wasauce/AirCloudPCBs/AirCloudv1/Deliverables/images/04.jpg

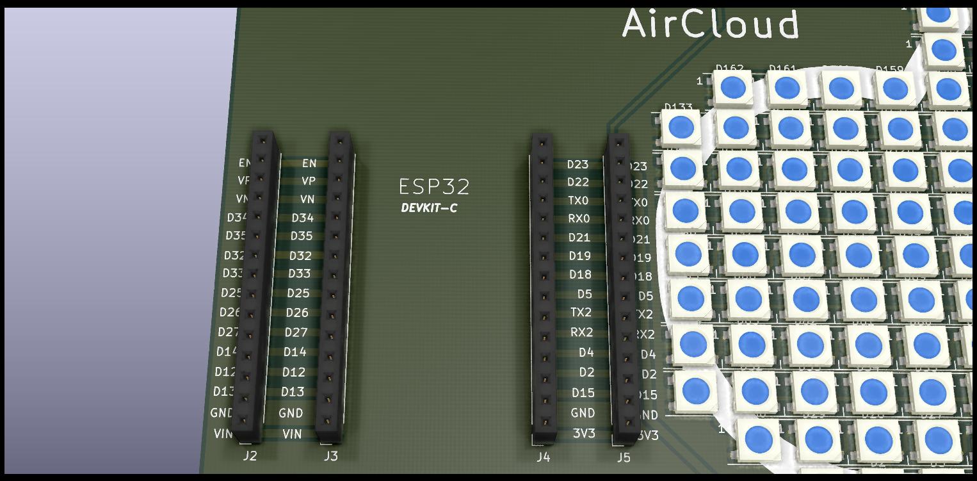
AirCloudv1/Deliverables/images/04.jpg
