wasauce/AirCloudPCBs/AirCloudv1/Deliverables/images/01.jpg

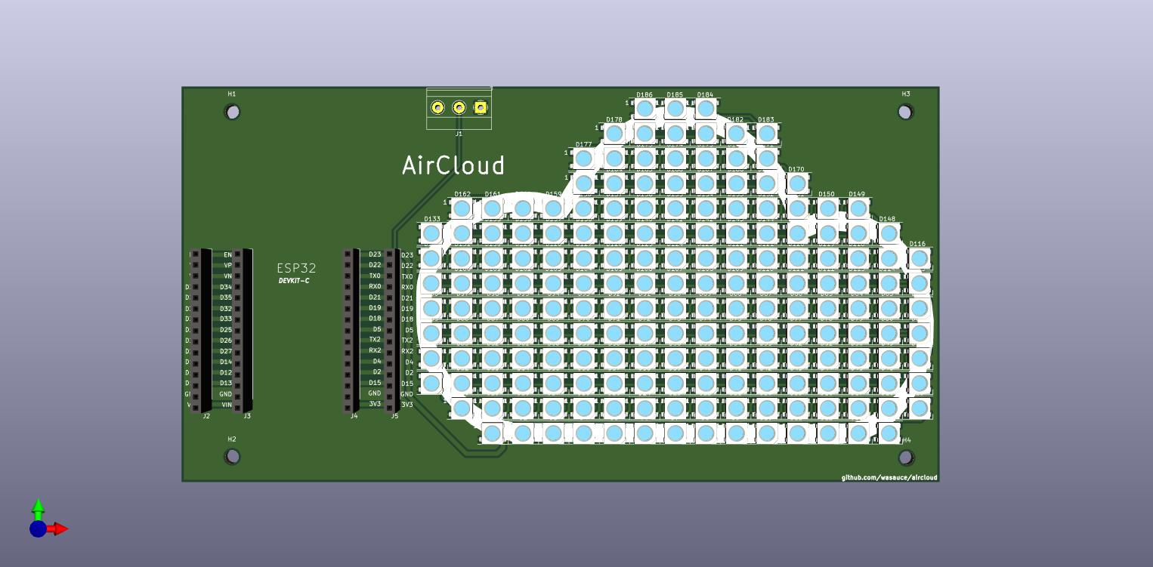
AirCloudv1/Deliverables/images/01.jpg
