wasauce/AirCloudPCBs/AirCloudv1/CONNECTION.png

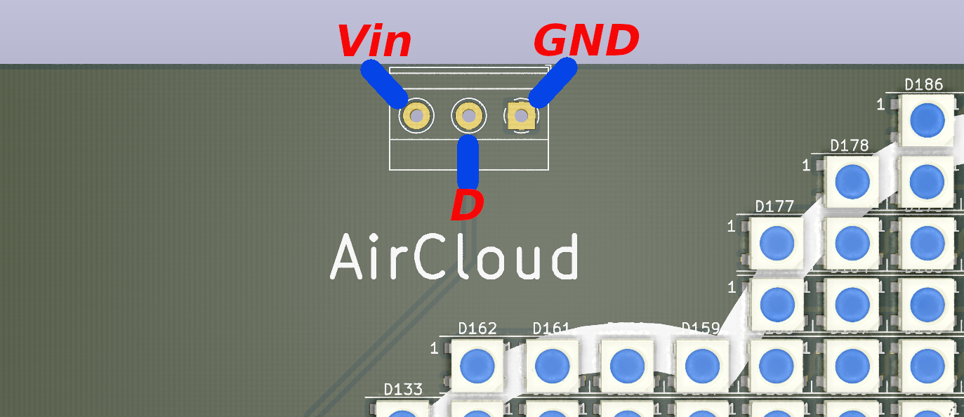
AirCloudv1/CONNECTION.png
