wasauce/AirCloudPCBs/AirCloudv1/Deliverables-matrix/images/01.jpg

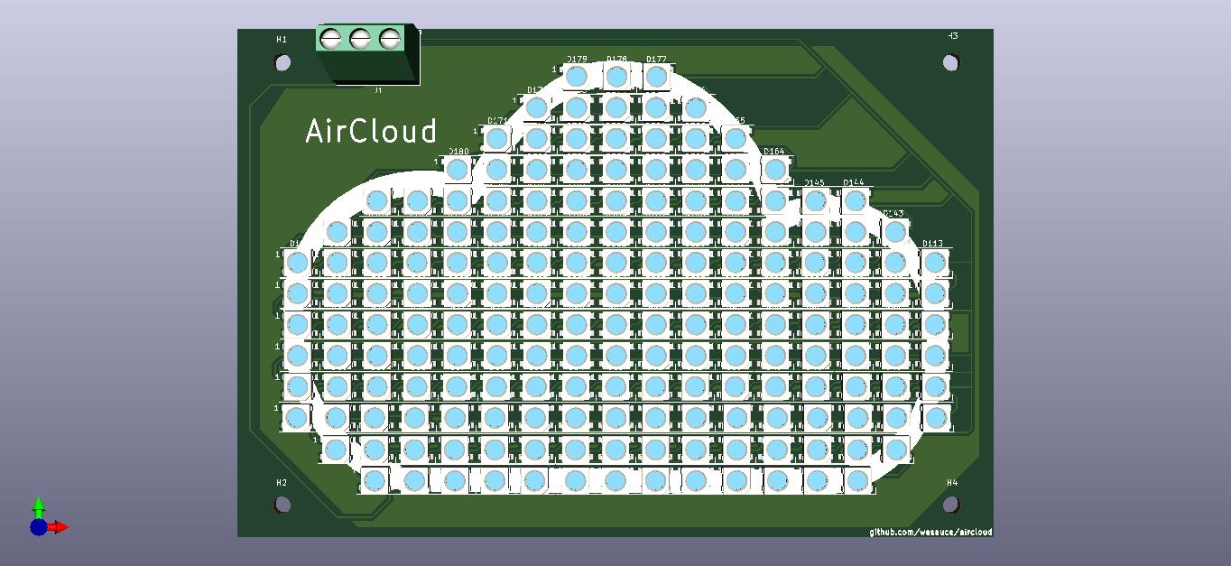
AirCloudv1/Deliverables-matrix/images/01.jpg
