wasauce/AirCloudPCBs/AirCloudv1/Deliverables-matrix/images/02.jpg

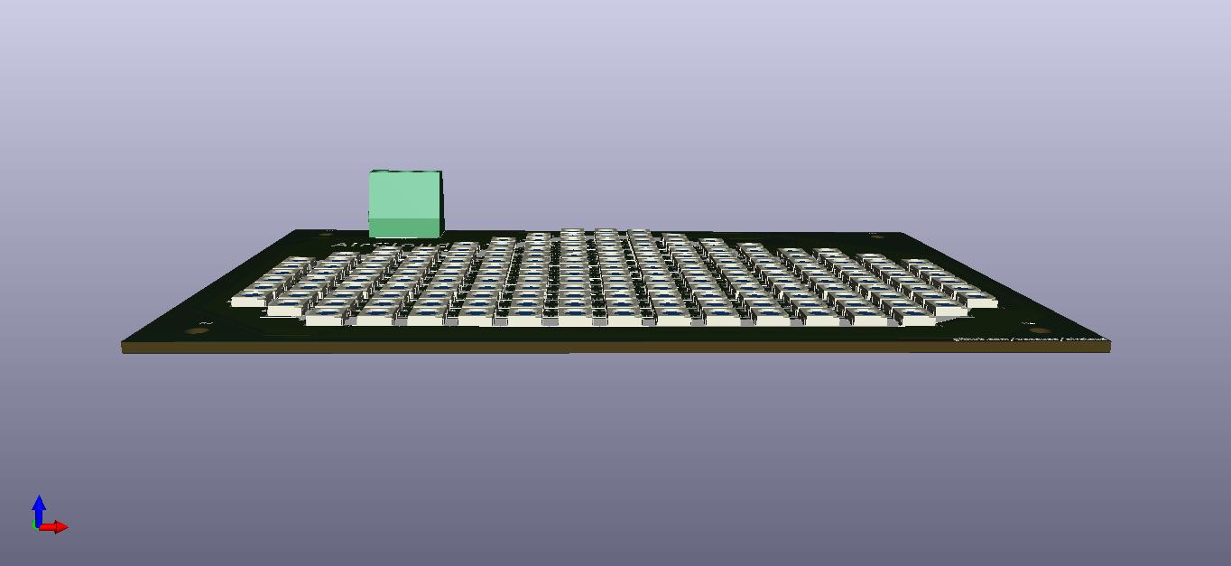
AirCloudv1/Deliverables-matrix/images/02.jpg
