wasauce/AirCloudPCBs/AirCloudv1/Deliverables-matrix/images/03.jpg

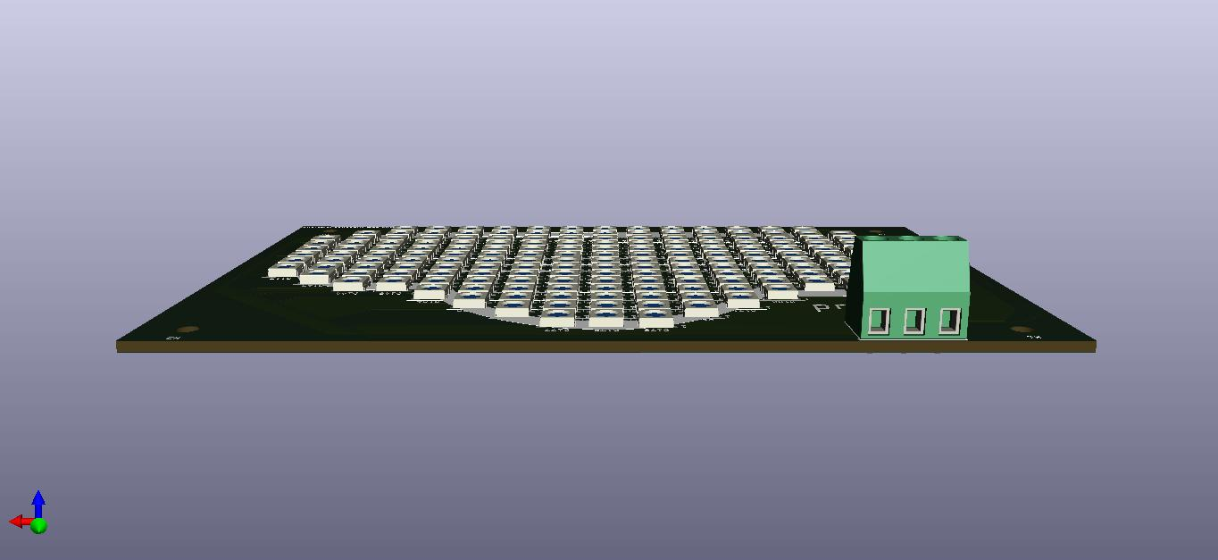
AirCloudv1/Deliverables-matrix/images/03.jpg
