wasauce/AirCloudPCBs/AirCloudv1/Deliverables/images/02.jpg

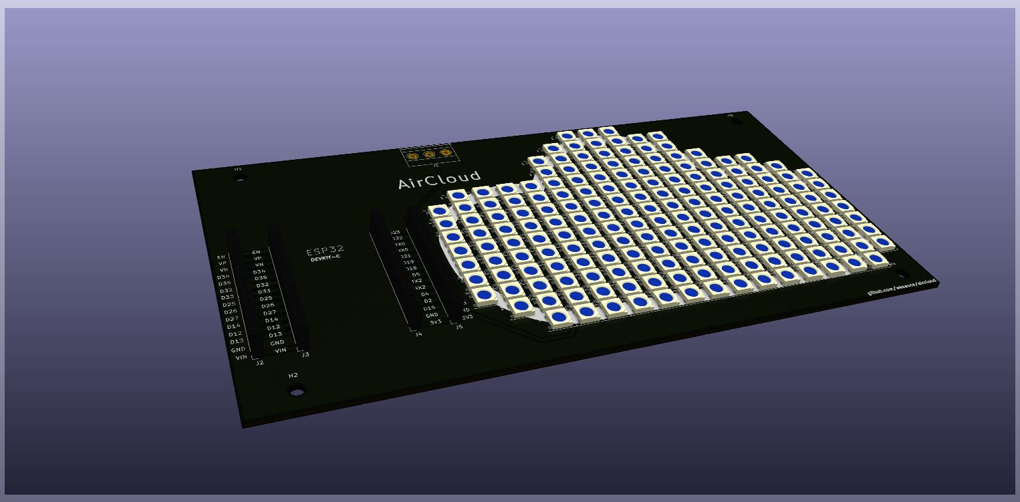
AirCloudv1/Deliverables/images/02.jpg
