wasauce/AirCloudPCBs/AirCloudv1/Deliverables/images/03.jpg

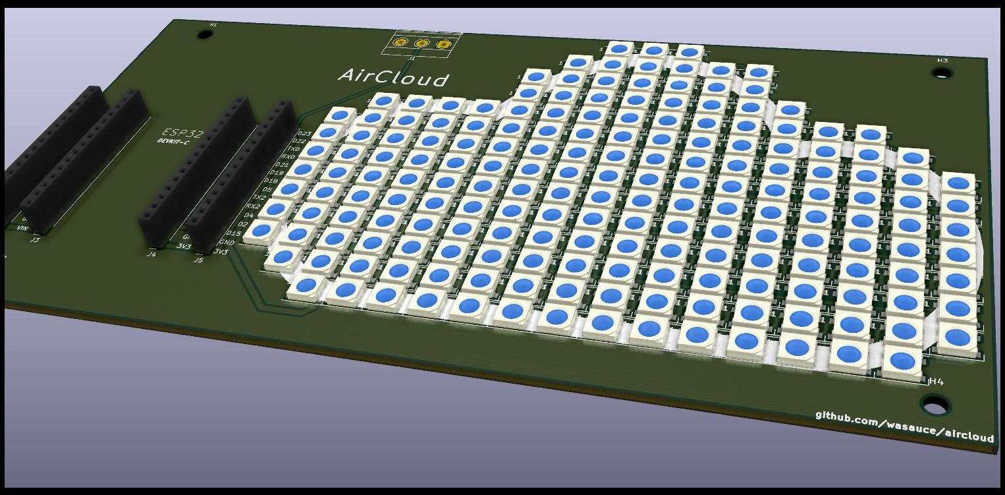
AirCloudv1/Deliverables/images/03.jpg
