wasauce/AirCloudPCBs/AirCloudv2/AirCloud_Back.PNG

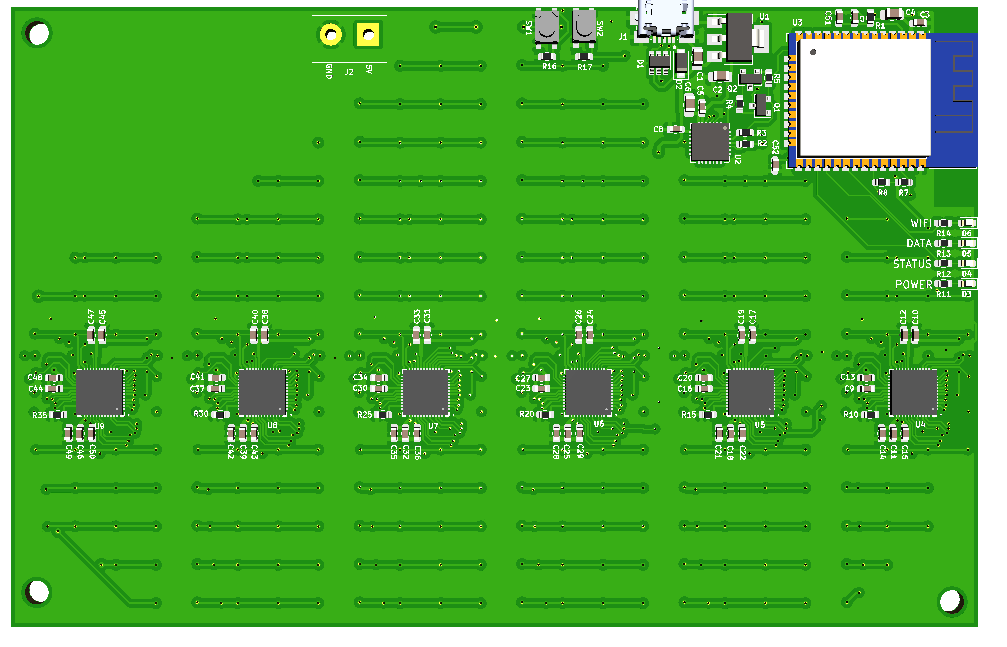
AirCloudv2/AirCloud_Back.PNG
