wasauce/AirCloudPCBs/AirCloudv2/AirCloud_Back_jack.PNG

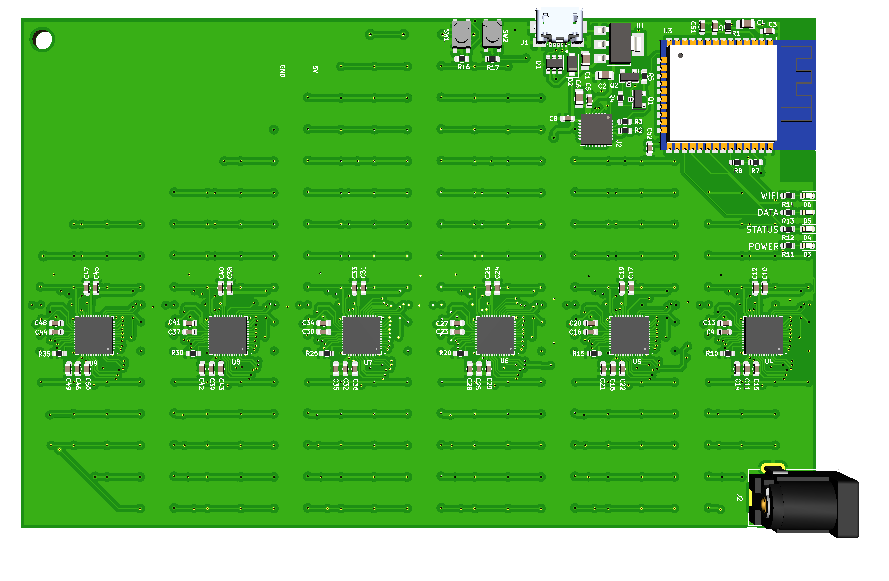
AirCloudv2/AirCloud_Back_jack.PNG
