wasauce/AirCloudPCBs/AirCloudv2/AirCloud_Back_Spacinf.PNG

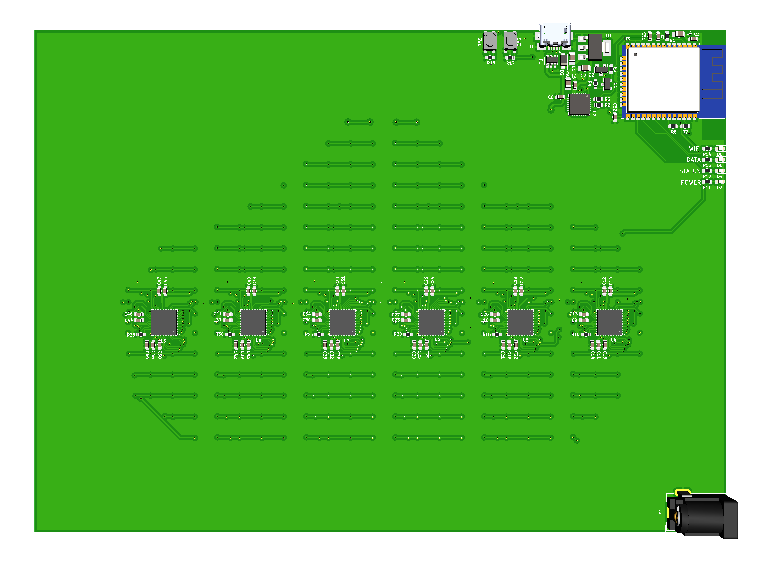
AirCloudv2/AirCloud_Back_Spacinf.PNG
