wasauce/AirCloudPCBs/AirCloudv2/AirCloud_Front.PNG

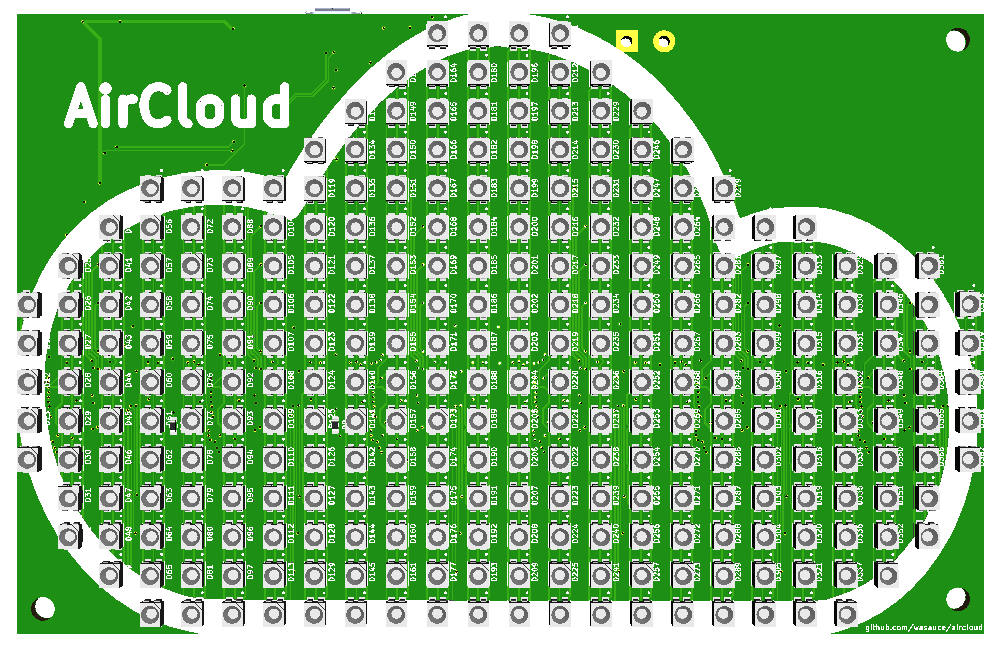
AirCloudv2/AirCloud_Front.PNG
