wasauce/AirCloudPCBs/AirCloudv2/AirCloud_Front_Jack.PNG

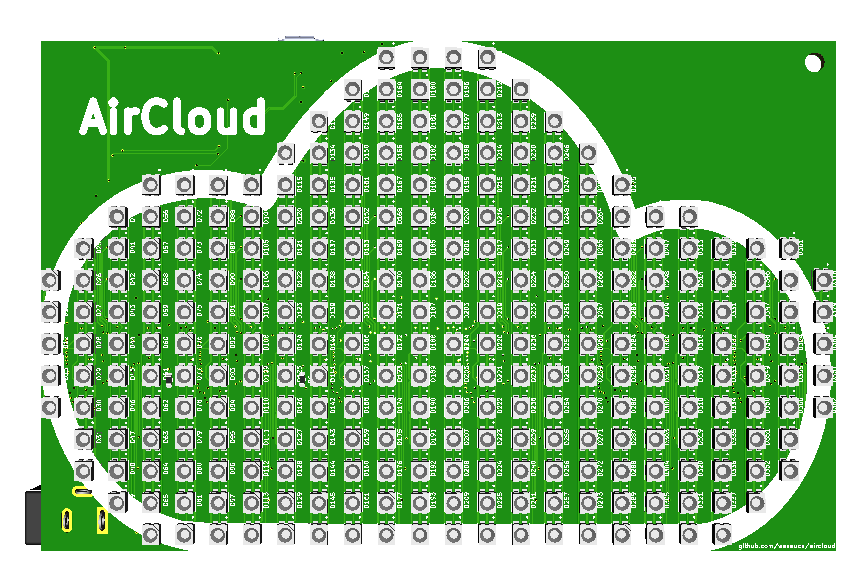
AirCloudv2/AirCloud_Front_Jack.PNG
