wasauce/AirCloudPCBs/AirCloudv2/AirCloud_Front_Spacing.PNG

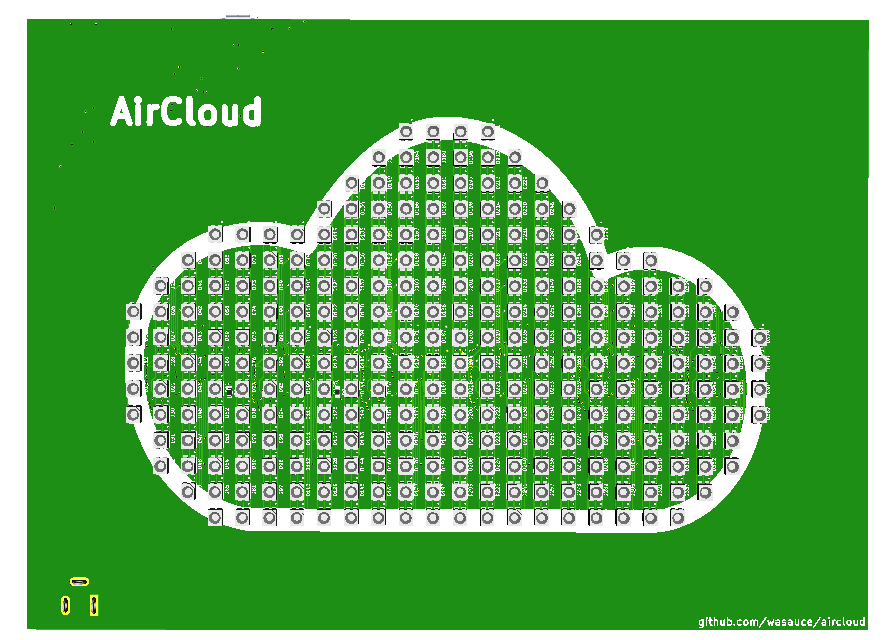
AirCloudv2/AirCloud_Front_Spacing.PNG
