wasauce/AirCloudPCBs/AirCloudv2/Matrix.PNG

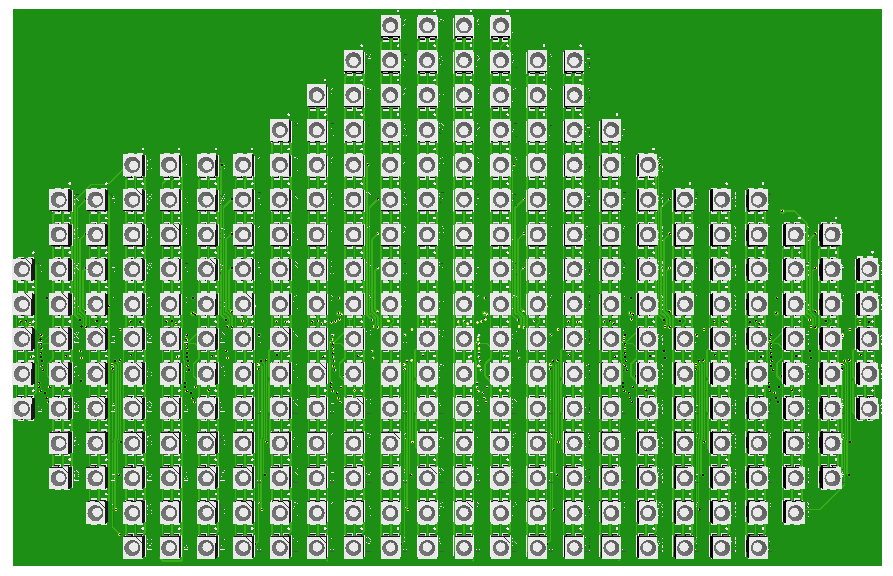
AirCloudv2/Matrix.PNG
