wasauce/AirCloudPCBs/AirCloudv2/Matrix_1.PNG

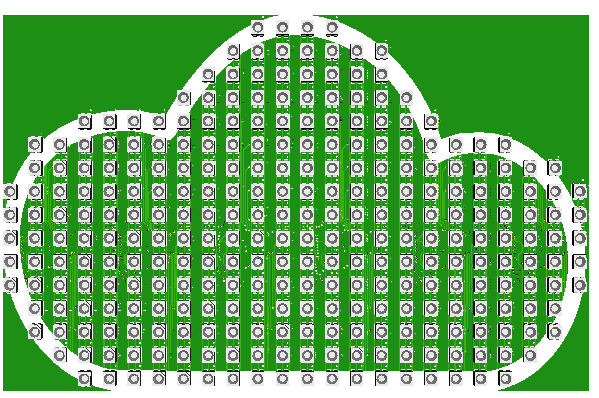
AirCloudv2/Matrix_1.PNG
