wasauce/AirCloudPCBs/AirCloudv3/Images/1.jpg

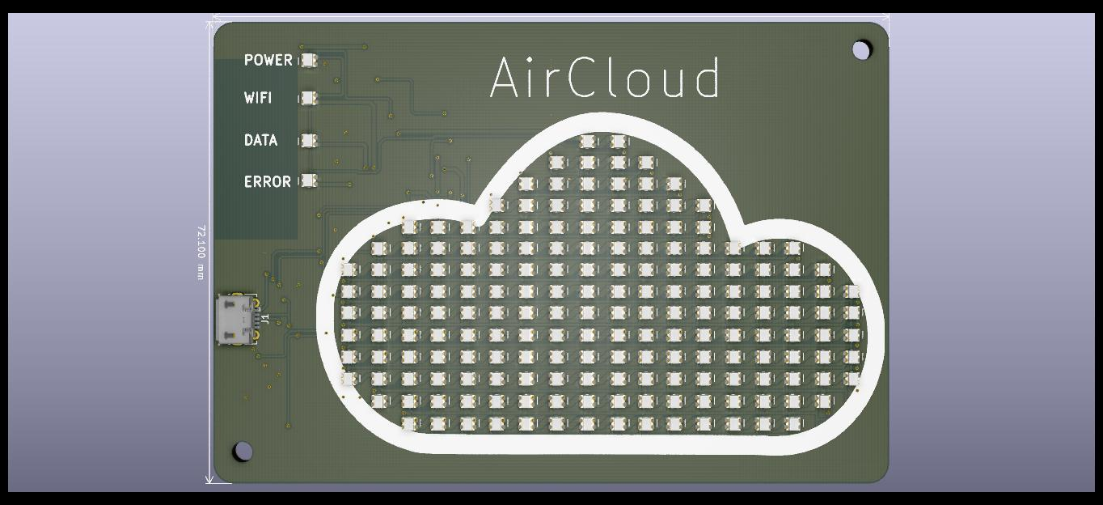
AirCloudv3/Images/1.jpg
