wasauce/AirCloudPCBs/AirCloudv3/Images/2.jpg

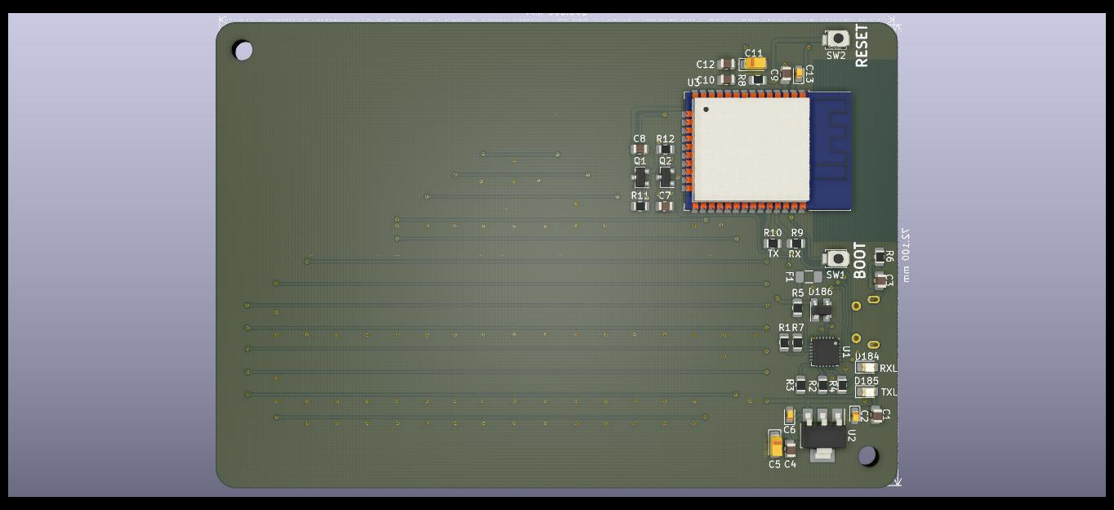
AirCloudv3/Images/2.jpg
