wasauce/AirCloudPCBs/AirCloudv3/Images/3.jpg

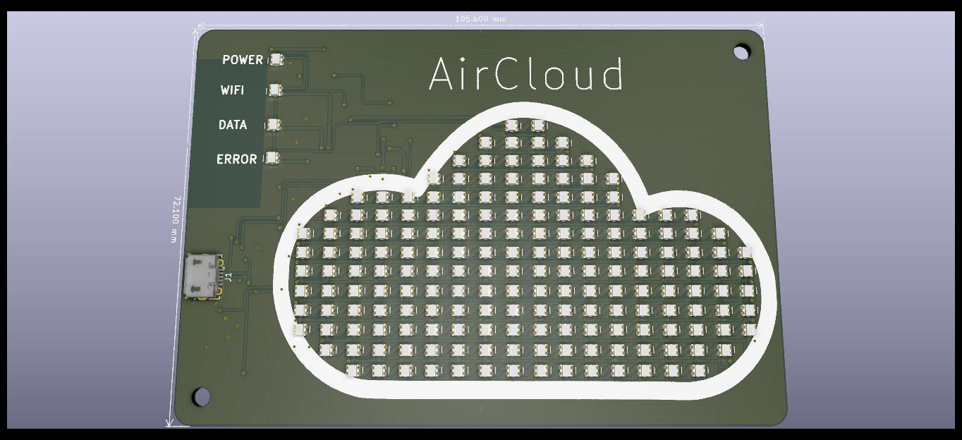
AirCloudv3/Images/3.jpg
