wasauce/AirCloudPCBs/AirCloudv3/Images/4.jpg

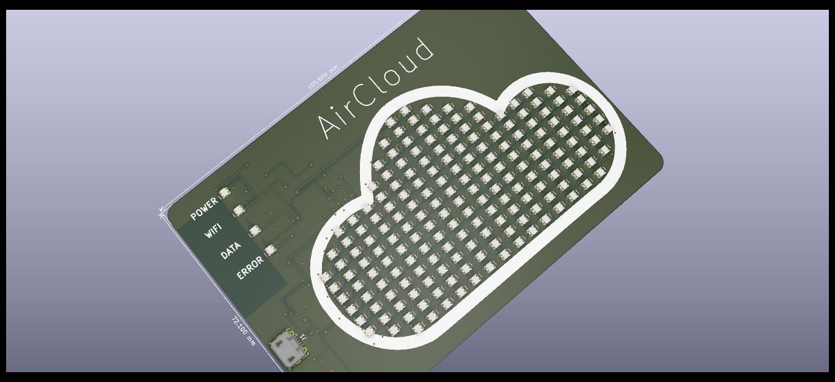
AirCloudv3/Images/4.jpg
