wasauce/AirCloudPCBs/AirCloudv3/Images/5.jpg

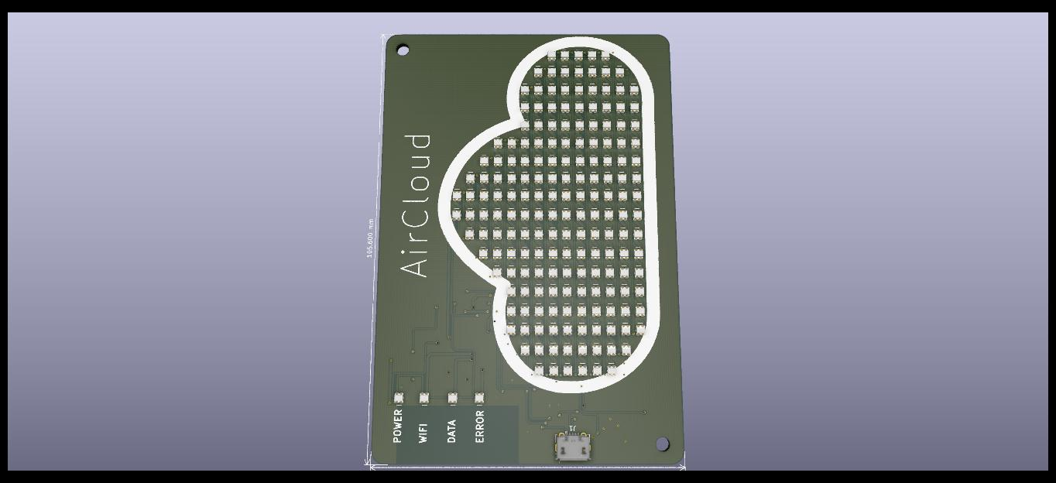
AirCloudv3/Images/5.jpg
