wasauce/AirCloudPCBs/AirCloudv3/BOM/BOM.xlsx

Reference | Value | Footprint | Datasheet | Cost | Mfg PN | Vendor Link | Vendor PN | Qty | Rev
C1, C4, C7-C10, C12 | 0.1uF | C_0805_2012Metric | https://www.mouser.com/datasheet/2/40/X7RDielectric-777024.pdf | 0.1000 | 08055C104KAT2A | https://www.mouser.com/ProductDetail/AVX/08055C104KAT2A | 581-08055C104K | 7 | OK | 0.7000
C2, C6 | 10uF/6V3 | CP_EIA-1608-08_AVX-J | https://www.mouser.com/datasheet/2/427/tmcj-1764085.pdf | 0.2700 | TMCJ0J106MTRF | https://www.mouser.com/ProductDetail/Vishay-Sprague/TMCJ0J106MTRF | 74-TMCJ0J106MTRF | 2 | OK | 0.5400
C3 | 4.7nF | C_0805_2012Metric | https://www.mouser.com/datasheet/2/445/885012207090-1727858.pdf | 0.1000 | 885000000000 | https://www.mouser.com/ProductDetail/Wurth-Elektronik/885012207090 | 710-885012207090 | 1 | OK | 0.1000
C5, C11 | 22uF | CP_EIA-3216-18_Kemet-A | https://www.mouser.com/datasheet/2/212/1/KEM_T2005_T491-1093550.pdf | 0.5300 | T491A226K006AT7280 | https://www.mouser.com/ProductDetail/KEMET/T491A226K006AT7280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 | 80-T491A226K006AT | 2 | OK | 1.0600
C13 | 4.7uF | CP_EIA-1608-08_AVX-J | https://www.mouser.com/datasheet/2/427/tmcj-1764085.pdf | 0.2700 | TMCJ0J475MTRF | https://www.mouser.com/ProductDetail/Vishay-Sprague/TMCJ0J475MTRF?qs=WatphXlIDnxcU2F%2FkoHLoA%3D%3D | 74-TMCJ0J475MTRF | 1 | OK | 0.2700
D184, D185 | Blue | LED_0805_2012Metric_Castellated | https://www.mouser.com/datasheet/2/445/150080BS75000-1715853.pdf | 0.1800 | 150080BS75000 | https://www.mouser.com/ProductDetail/Wurth-Elektronik/150080BS75000?qs=2kOmHSv6VfT2tBo3UPVqAQ%3D%3D | 710-150080BS75000 | 2 | OK | 0.3600
D186 | PRTR5V0U2X | SOT-143 | https://www.mouser.com/datasheet/2/916/PRTR5V0U2X-1320589.pdf | 0.5000 | PRTR5V0U2X,215 | https://www.mouser.com/ProductDetail/Nexperia/PRTR5V0U2X215 | 771-PRTR5V0U2X-T/R | 1 | OK | 0.5000
D1-D183, D187-D190 | WS2812B_2020 | WS2812B2020 | https://datasheet.lcsc.com/lcsc/2012110135_Worldsemi-WS2812B-2020_C965555.pdf | 0.0924 | WS2812B-2020 | https://lcsc.com/product-detail/Light-Emitting-Diodes-LED_Worldsemi-WS2812B-2020_C965555.html | C965555 | 187 | OK | 17.2788
F1 | 6V/500mA | Fuse_1206_3216Metric | https://www.mouser.com/datasheet/2/87/eaton-pts1206-6-60-volt-dc-surface-mount-resettabl-1608737.pdf | 0.1300 | PTS12066V050 | https://www.mouser.com/ProductDetail/Bussmann-Eaton/PTS12066V050?qs=QmibqUXyDhT3w6keDqXDtw%3D%3D | PTS12066V050 | 1 | OK | 0.1300
J1 | USB_B_Micro | USB_Micro-B_Molex-105017-0001 | https://datasheet.lcsc.com/lcsc/1811131824_MOLEX-1050170001_C136000.pdf | 0.2880 | 105017-0001 | https://lcsc.com/product-detail/Micro-USB-Connectors_MOLEX_105017-0001_105017-0001_C136000.html | C136000 | 1 | OK | 0.2880
Q1, Q2 | MMBT3904 | SOT-23 | https://www.mouser.com/datasheet/2/916/MMBT3904-1599187.pdf | 0.1000 | MMBT3904,215 | https://www.mouser.com/ProductDetail/Nexperia/MMBT3904215?qs=LOCUfHb8d9s%2FW6hzAJGDbw%3D%3D | 771-MMBT3904T/R | 2 | OK | 0.2000
R1 | 2K | R_0805_2012Metric | https://www.mouser.com/datasheet/2/447/PYu_RT_1_to_0_01_RoHS_L_11-1669912.pdf | 0.1200 | RT0805FRE102KL | https://www.mouser.com/ProductDetail/Yageo/RT0805FRE102KL?qs=F5EMLAvA7ICZZb51T28hLA%3D%3D | 603-RT0805FRE102KL | 1 | OK | 0.1200
R2, R3 | 1K | R_0805_2012Metric | https://www.mouser.com/datasheet/2/447/PYu_RT_1_to_0_01_RoHS_L_11-1669912.pdf | 0.1200 | RT0805FRE071KL | https://www.mouser.com/ProductDetail/Yageo/RT0805FRE071KL?qs=8cPjvKtxWv4wlgQ3qHu8dQ%3D%3D | 603-RT0805FRE071KL | 2 | OK | 0.2400
R4 | 22K | R_0805_2012Metric | https://www.mouser.com/datasheet/2/427/crcwce3-1762584.pdf | 0.1000 | CRCW080522K0FKEAC | https://www.mouser.com/ProductDetail/Vishay-Dale/CRCW080522K0FKEAC?qs=E3Y5ESvWgWM%252BLh7gNR1oHw%3D%3D | 71-CRCW080522K0FKEAC | 1 | OK | 0.1000
R5 | 22.1K | R_0805_2012Metric | https://www.mouser.com/datasheet/2/392/susumu_RR_Data_Sheet-1206438.pdf | 0.1000 | RR1220P-2212-D-M | https://www.mouser.com/ProductDetail/Susumu/RR1220P-2212-D-M | 754-RR1220P-2212D-M | 1 | OK | 0.1000
R6 | 1M | R_0805_2012Metric | https://www.mouser.com/datasheet/2/447/PYu_AC_51_RoHS_L_7-1714230.pdf | 0.1000 | AC0805FR-7W1ML | https://www.mouser.com/ProductDetail/Yageo/AC0805FR-7W1ML?qs=tggtontpCXNsGpOF44NrCA%3D%3D | 603-AC0805FR-7W1ML | 1 | OK | 0.1000
R7 | 47.5K | R_0805_2012Metric | https://www.mouser.com/datasheet/2/447/PYu_AC_51_RoHS_L_7-1714230.pdf | 0.1000 | AC0805FR-7W47K5L | https://www.mouser.com/ProductDetail/Yageo/AC0805FR-7W47K5L | 603-AC0805FR-7W47K5L | 1 | OK | 0.1000
R8 | 620 | R_0805_2012Metric | https://www.mouser.com/datasheet/2/54/crxxxxx-1858361.pdf | 0.1000 | CR0805-JW-621ELF | https://www.mouser.com/ProductDetail/Bourns/CR0805-JW-621ELF?qs=%252BcBkmVQIZ2S44sYUQ9%2FccQ%3D%3D | 652-CR0805JW-621ELF | 1 | OK | 0.1000
R9, R10 | 150 | R_0805_2012Metric | https://www.mouser.com/datasheet/2/54/crxxxxx-1858361.pdf | 0.1000 | CR0805-FX-1500ELF | https://www.mouser.com/ProductDetail/Bourns/CR0805-FX-1500ELF | 652-CR0805FX-1500ELF | 2 | OK | 0.2000
R11, R12 | 10K | R_0805_2012Metric | https://www.mouser.com/datasheet/2/392/susumu_RR_Data_Sheet-1206438.pdf | 0.1000 | RR1220P-103-D | https://www.mouser.com/ProductDetail/Susumu/RR1220P-103-D?qs=nCAm%252BcMdy9wM6YRNq%2FvwoQ%3D%3D | 754-RR1220P-103D | 2 | OK | 0.2000
SW1 | BOOT | SW_SPST_B3U-1000P | https://datasheet.lcsc.com/lcsc/1810010153_Omron-Electronics-B3U-1000P_C231329.pdf | 0.2585 | B3U-1000P | https://lcsc.com/product-detail/Tactile-Switches_Omron-Electronics-B3U-1000P_C231329.html | C231329 | 1 | OK | 0.2585
SW2 | RESET | SW_SPST_B3U-1000P | https://datasheet.lcsc.com/lcsc/1810010153_Omron-Electronics-B3U-1000P_C231329.pdf | 0.2585 | B3U-1000P | https://lcsc.com/product-detail/Tactile-Switches_Omron-Electronics-B3U-1000P_C231329.html | C231329 | 1 | OK | 0.2585
U1 | CP2102N-A02-GQFN24 | QFN-24-1EP_4x4mm_P0.5mm_EP2.6x2.6mm | https://www.mouser.com/datasheet/2/368/cp2102n_datasheet-1634912.pdf | 1.8700 | CP2102N-A02-GQFN24R | https://www.mouser.com/ProductDetail/Silicon-Labs/CP2102N-A02-GQFN24R?qs=u16ybLDytRaIVBf0X4zL0g%3D%3D | 634-CP2102NA02QFN24R | 1 | OK | 1.8700
U2 | AZ1117-3.3 | SOT-223-3_TabPin2 | https://datasheet.lcsc.com/lcsc/1811061323_Diodes-Incorporated-AZ1117IH-3-3TRG1_C108495.pdf | 0.2505 | AZ1117IH-3.3TRG1 | https://lcsc.com/product-detail/Dropout-Regulators-LDO_Diodes-Incorporated-AZ1117IH-3-3TRG1_C108495.html | C108495 | 1 | OK | 0.2505
U3 | ESP32-WROOM-32 | ESP32-WROOM-32 | https://datasheet.lcsc.com/lcsc/2007061615_Espressif-Systems-ESP32-WROOM-32_C82899.pdf | 2.3582 | ESP32-WROOM-32 | https://lcsc.com/product-detail/WiFi-Modules_Espressif-Systems-ESP32-WROOM-32_C82899.html | C82899 | 1 | OK | 2.3582
 |  |  |  |  |  |  | TOTAL | 224 |  | 27.6825
