wasauce/AirCloudPCBs/AirCloudv1/Deliverables/BOM.xlsx

Reference | Value | Footprint | Datasheet | Cost | Mfg Part Number | QTY | Vendor Link
D1-D186 | LED_SMD | LED_WS2812B_PLCC4_5.0x5.0mm_P3.2mm | https://cdn-shop.adafruit.com/datasheets/WS2812B.pdf | 1.8 | WS2812B | 186 | http://cdn.sparkfun.com/datasheets/BreakoutBoards/WS2812B.pdf
J1 | Screw_Terminal_01x03 | TerminalBlock_Phoenix_MKDS-1,5-3-5.08_1x03_P5.08mm |  | 0.88 | TB002-500-03BE | 1 | https://www.digikey.com/en/products/detail/cui-devices/TB002-500-03BE/10064070
J2-J5 | Conn_01x15_Female | Connector_PinSocket_2.54mm:PinSocket_1x15_P2.54mm_Vertical | http://www.adam-tech.com/downloader.php?p=SMC-1-XX-1-GT.pdf |  | SMC-1-40-1-GT | 4 | https://www.digikey.com/en/products/detail/adam-tech/SMC-1-40-1-GT/9831942
