wasauce/AirCloudPCBs/AirCloudv2/Manufacturing Files/BoM/AirCloud-BOM.xlsx

References | Description | Digikey Part # | Manufacturer | Manufacturer Part Number | Quantity
C3, C5, C7, C8, C12, C13, C14, C19, C20, C21, C26, C27, C28,C33, C34, C35, C40, C41, C42, C47, C48, C49, C51, C52 | -20%, +80% 50V Ceramic Capacitor Y5V (F) 0603 (1608 Metric) | 311-1343-1-ND | Yageo | CC0603ZRY5V9BB104 | 24
C9, C10, C11, C15, C16, C17, C18, C22, C23, C24, C25, C29,C30, C31, C32, C36, C37, C38, C39, C43, C44, C45, C46, C50 | 0.47µF ±20% 25V Ceramic Capacitor X5R 0603 (1608 Metric) | 732-7917-1-ND | Würth Elektronik | 885012106020 | 24
C1, C2, C4 | 22µF ±20% 16V Ceramic Capacitor X5R 0805 (2012 Metric) | 1276-6780-1-ND | Samsung Electro-Mechanics | CL21A226MOCLRNC | 3
C6 | 4.7µF ±10% 6.3V Ceramic Capacitor X5R 0805 (2012 Metric) | 1276-1198-1-ND | Samsung Electro-Mechanics | CL21A475KQFNNNE | 1
D2 | Clamp Ipp Tvs Diode Surface Mount SOT-23-6 | 497-6635-1-ND | STMicroelectronics | ESDA6V1BC6 | 1
D1 | Diode Schottky 1A Surface Mount SOD-123FL | 1655-1928-1-ND | SMC Diode Solutions | DSS15UTR | 1
D3, D4, D5, D6 | White LED Indication - Discrete 2.925V 0603 (1608 Metric) | 1080-1573-1-ND | Everlight Electronics Co Ltd | 19-113Z/T1D-CP2Q2HY/3T | 4
D10, D11, D12, D13, D14, D25, D26, D27, D28, D29, D30, D31, D32, D40, D41, D42, D43, D44, D45, D46, D47, D48, D49, D55, D56, D57, D58, D59, D60, D61, D62, D63, D64, D65, D66, D71, D72, D73, D74, D75, D76, D77, D78, D79, D80, D81, D82, D87, D88, D89, D90, D91, D92, D93, D94, D95, D96, D97, D98, D103, D104, D105, D106, D107, D108, D109, D110, D111, D112, D113, D114, D118, D119, D120, D121, D122, D123, D124, D125, D126, D127, D128, D129, D130, D133, D134, D135, D136, D137, D138, D139, D140, D141, D142, D143, D144, D145, D146, D148, D149, D150, D151, D152, D153, D154, D155, D156, D157, D158, D159, D160, D161, D162, D163, D164, D165, D166, D167, D168, D169, D170, D171, D172, D173, D174, D175, D176, D177, D178, D179, D180, D181, D182, D183, D184, D185, D186, D187, D188, D189, D190, D191, D192, D193, D194,D195, D196, D197, D198, D199, D200, D201, D202, D203, D204, D205, D206, D207, D208, D209, D210, D211, D212, D213, D214, D215, D216, D217, D218, D219, D220, D221, D222, D223, D224, D225, D226, D228, D229, D230, D231, D232, D233, D234, D235, D236, D237, D238, D239, D240, D241, D242, D245, D246, D247, D248, D249, D250, D251, D252, D253, D254, D255, D256, D257, D258, D262, D263, D264, D265, D266, D267, D268, D269, D270, D271, D272, D273, D274, D279, D280, D281, D282, D283, D284, D285, D286, D287, D288, D289, D290, D296, D297, D298, D299, D300, D301, D302, D303, D304, D305, D306, D312, D313, D314, D315, D316, D317, D318, D319, D320, D321, D322, D329, D330, D331, D332, D333, D334, D335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 | Red, Green, Blue (RGB) 625nm Red, 525nm Green, 470nm Blue LED Indication - Discrete 2.2V Red, 3.2V Green, 3.3V Blue 4-PLCC |  | SunLED | XZM2CRKM2DGFBB45SCCB | 285
J1 | USB - micro B USB 2.0 Receptacle Connector 5 Position Surface Mount, Right Angle | 609-4613-1-ND | Amphenol ICC (FCI) | 10118192-0001LF | 1
J2 | Power Barrel Connector Jack 2.50mm ID (0.098"), 5.50mm OD (0.217") Through Hole, Right Angle | 732-5934-ND | Würth Elektronik | 694108301002 | 1
R25, R30, R35 | 20 kOhms ±1% 0.125W, 1/8W Chip Resistor 0603 (1608 Metric) Anti-Sulfur, Moisture Resistant Thin Film | RNCP0603FTD20K0CT-ND | Stackpole Electronics Inc | RNCP0603FTD20K0 | 3
R2, R3 | 0 Ohms Jumper 0.1W, 1/10W Chip Resistor 0603 (1608 Metric) Thick Film | 311-0.0HRCT-ND | Yageo | RC0603FR-070RL | 2
R1, R4, R5, R6, R7, R8, R9, R16, R17 | 10 kOhms ±5% 0.1W, 1/10W Chip Resistor 0603 (1608 Metric) Thick Film | 311-10KGRCT-ND | Yageo | RC0603JR-0710KL | 9
R11, R12, R13, R14 | 10 kOhms ±5% 0.1W, 1/10W Chip Resistor 0603 (1608 Metric) Thick Film | 311-10KGRCT-ND | Yageo | RC0603JR-0710KL | 4
R10, R15, R20 | 20 kOhms ±1% 0.125W, 1/8W Chip Resistor 0603 (1608 Metric) Anti-Sulfur, Moisture Resistant Thin Film | RNCP0603FTD20K0CT-ND | Stackpole Electronics Inc | RNCP0603FTD20K0 | 3
SW1, SW2 | Tactile Switch SPST-NO Top Actuated Surface Mount | CKN12215-1-ND | C&K | PTS815 SJM 250 SMTR LFS | 2
U3 | Bluetooth, WiFi 802.11b/g/n, Bluetooth v4.2 +EDR, Class 1, 2 and 3 Transceiver Module 2.4GHz ~ 2.5GHz Integrated, Trace Surface Mount | 1904-1025-1-ND | Espressif Systems | ESP32-WROOM-32D (16MB) | 1
U4, U5, U6,U7, U8, U9 | IC LED DRVR LINEAR 46MA 48QFN | 706-1509-1-ND | Lumissil Microsystems | IS31FL3733-QFLS4-TR | 6
U1 | Linear Voltage Regulator IC Output 1A SOT-223 | NCP1117LPST33T3GOSCT-ND | ON Semiconductor | NCP1117LPST33T3G | 1
U2 | USB Bridge, USB to UART USB 2.0 UART Interface 28-QFN (5x5) | 336-5890-1-ND | Silicon Labs | CP2102N-A02-GQFN28R | 1
Q1, Q2 | Bipolar (BJT) Transistor NPN 100MHz Surface Mount SOT-23 | MMSS8050-L-TPMSCT-ND | Micro Commercial Co | MMSS8050-L-TP | 2
