wasauce/AirCloudPCBs/AirCloudv2/3D/PTS815SJM250SMTRLFS.stp

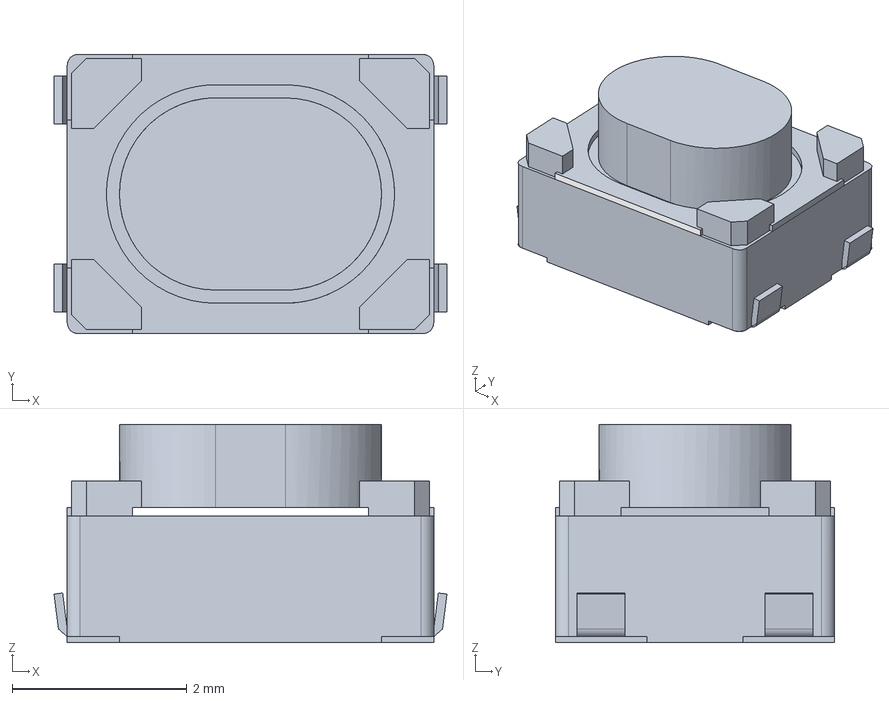
[picture p22: CAD file, 2021-05-02]
AirCloudv2/3D/PTS815SJM250SMTRLFS.stp
4.50 x 3.20 x 2.50 mm
