wasauce/AirCloudPCBs/AirCloudv2/3D/XZxxxx45.step

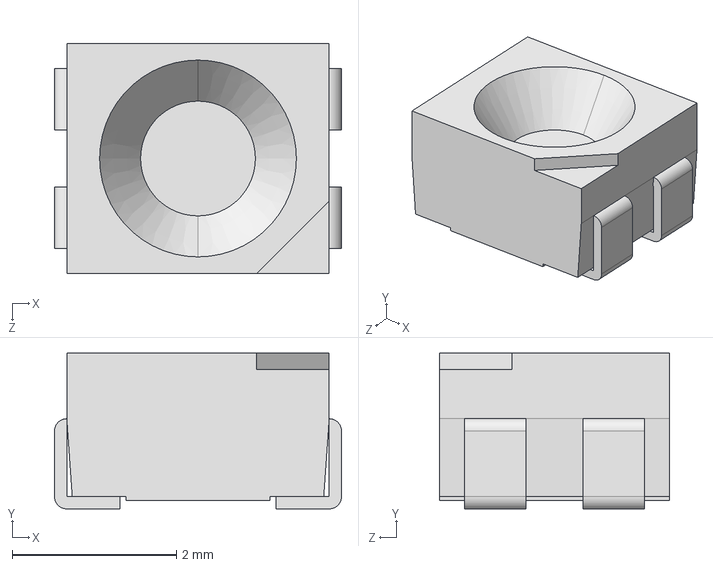
[picture p23: CAD file, 2021-05-02]
AirCloudv2/3D/XZxxxx45.step
3.50 x 1.90 x 2.80 mm
