wasauce/AirCloudPCBs/AirCloudv2/3D/QFN-48_ISI.step

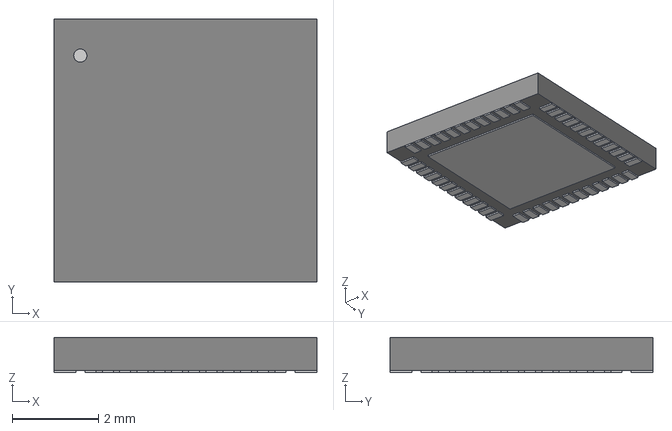
[picture p24: CAD file, 2021-05-02]
AirCloudv2/3D/QFN-48_ISI.step
6.10 x 6.10 x 0.815 mm
