wasauce/AirCloudPCBs/AirCloudv2/3D/UHD1110-FKA-CL1A13R3Q1BBQFMF3--3DModel-STEP-56544.STEP

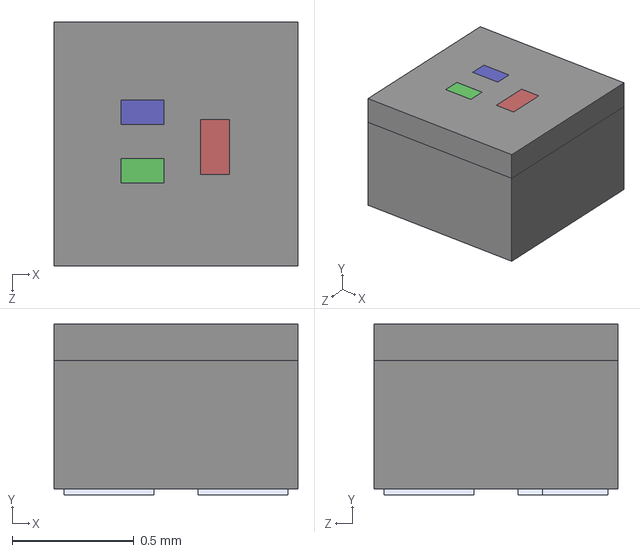
[picture p25: CAD file, 2021-05-02]
AirCloudv2/3D/UHD1110-FKA-CL1A13R3Q1BBQFMF3--3DModel-STEP-56544.STEP
1.00 x 0.7 x 1.00 mm
