wasauce/AirCloudPCBs/AirCloudv2/3D/TSM-103-01-T-SH.stp

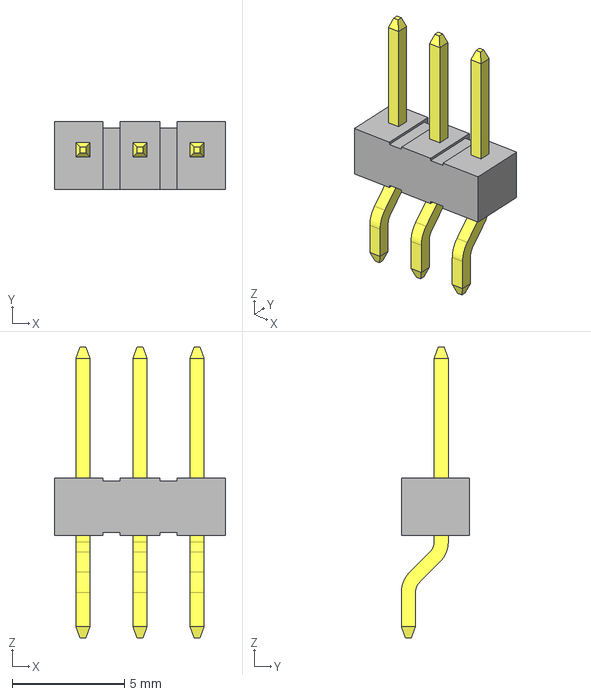
[picture p26: CAD file, 2021-05-02]
AirCloudv2/3D/TSM-103-01-T-SH.stp
7.62 x 3.05 x 13.0 mm
_TSM-103-01-SH_body
_T-1S6-08(-01-3-SH)
