wasauce/AirCloudPCBs/AirCloudv2/3D/694108301002 (rev1).stp

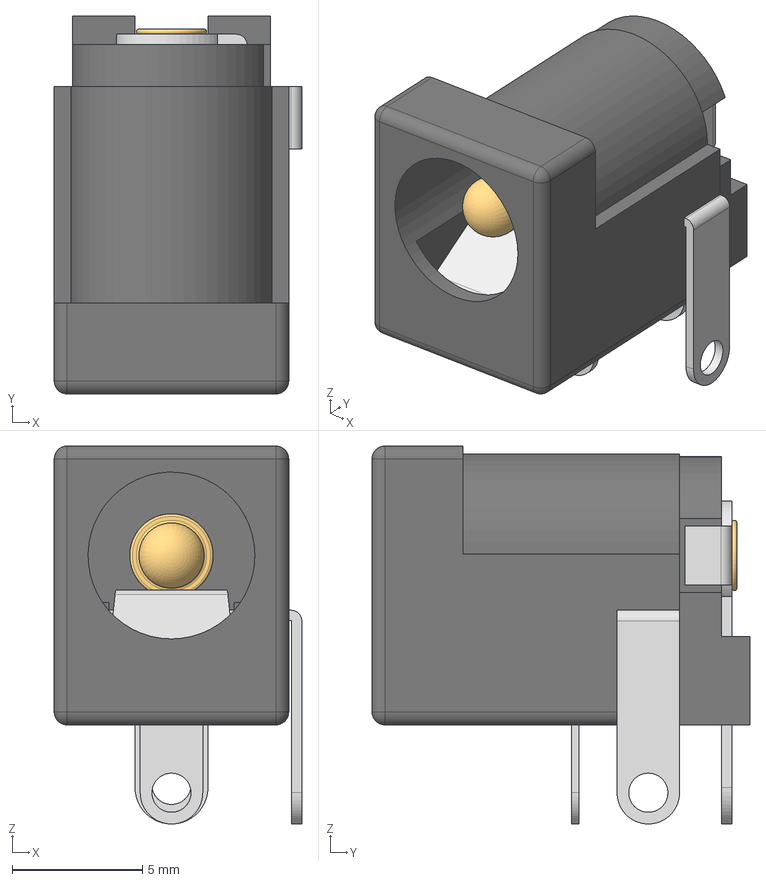
[picture p27: CAD file, 2021-05-02]
AirCloudv2/3D/694108301002 (rev1).stp
9.50 x 14.5 x 14.5 mm
6941xx301002
694108301002_PinContact
6941xx301002_Back
6941xx301002_PinContact2
6941xx301002_PinLame
6941xx301002_PinBis
