wasauce/AirCloudPCBs/AirCloudv2/3D/10118192-0001LF--3DModel-STEP-56544.STEP

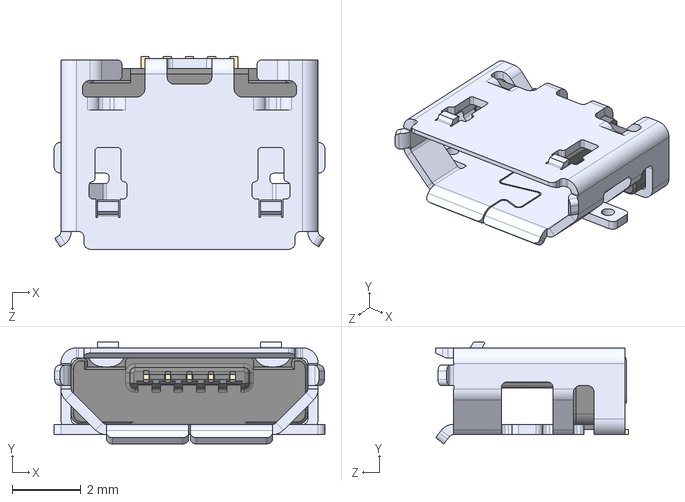
[picture p28: CAD file, 2021-05-02]
AirCloudv2/3D/10118192-0001LF--3DModel-STEP-56544.STEP
7.90 x 2.97 x 5.62 mm
