wasauce/AirCloudPCBs/AirCloudv2/3D/10118192-002lfc.stp

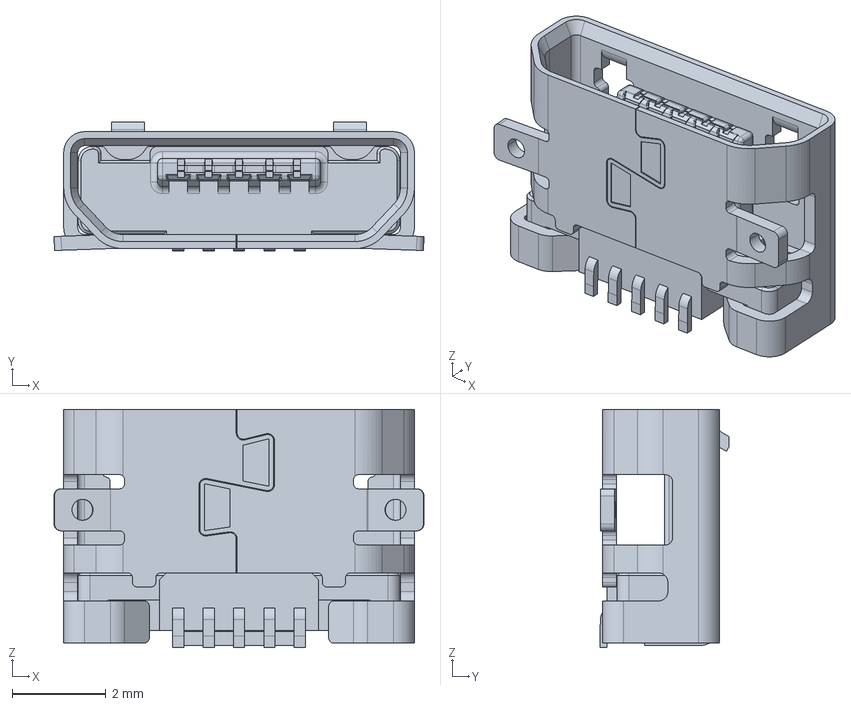
[picture p29: CAD file, 2021-05-02]
AirCloudv2/3D/10118192-002lfc.stp
7.91 x 2.77 x 5.10 mm
