wasauce/AirCloudPCBs/AirCloudv3/Schematic.pdf

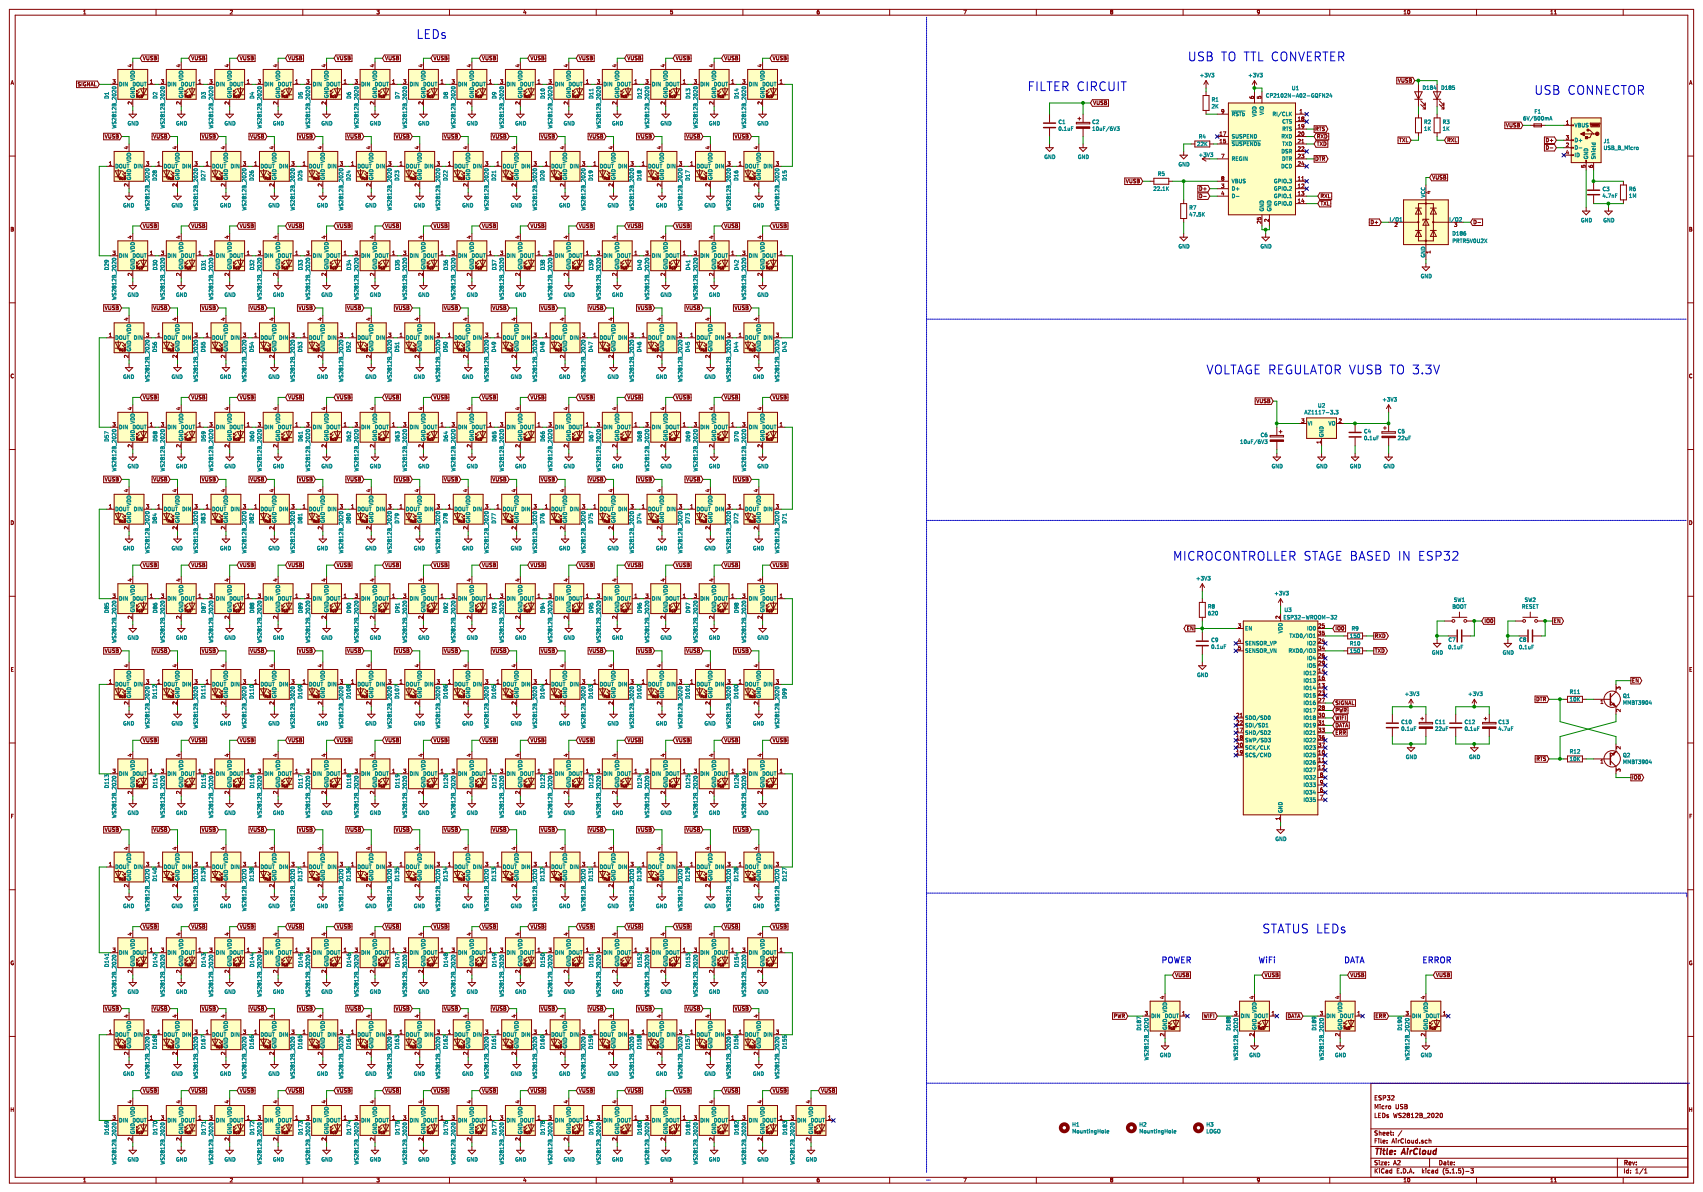
[picture p30: page 1]
