wasauce/AirCloudPCBs/AirCloudv3/PCB.pdf

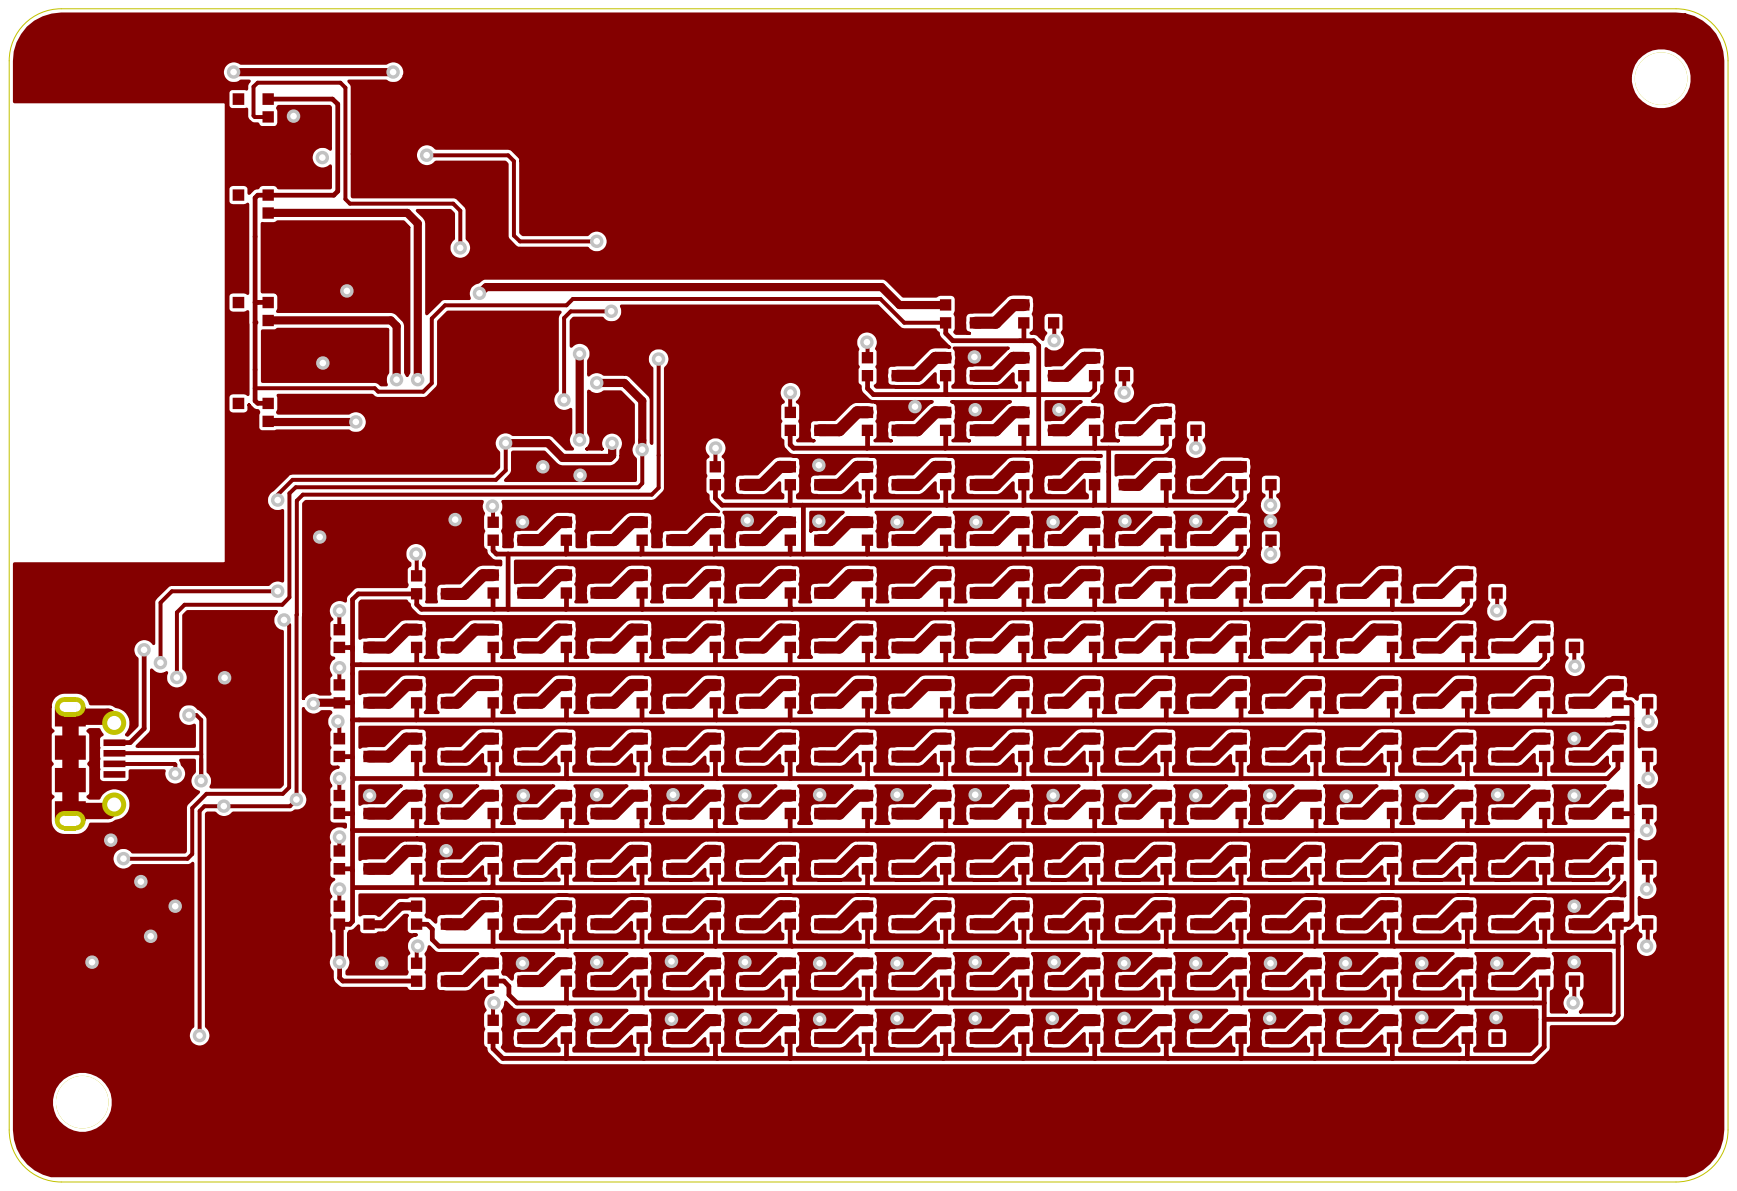
[picture p31: page 1]

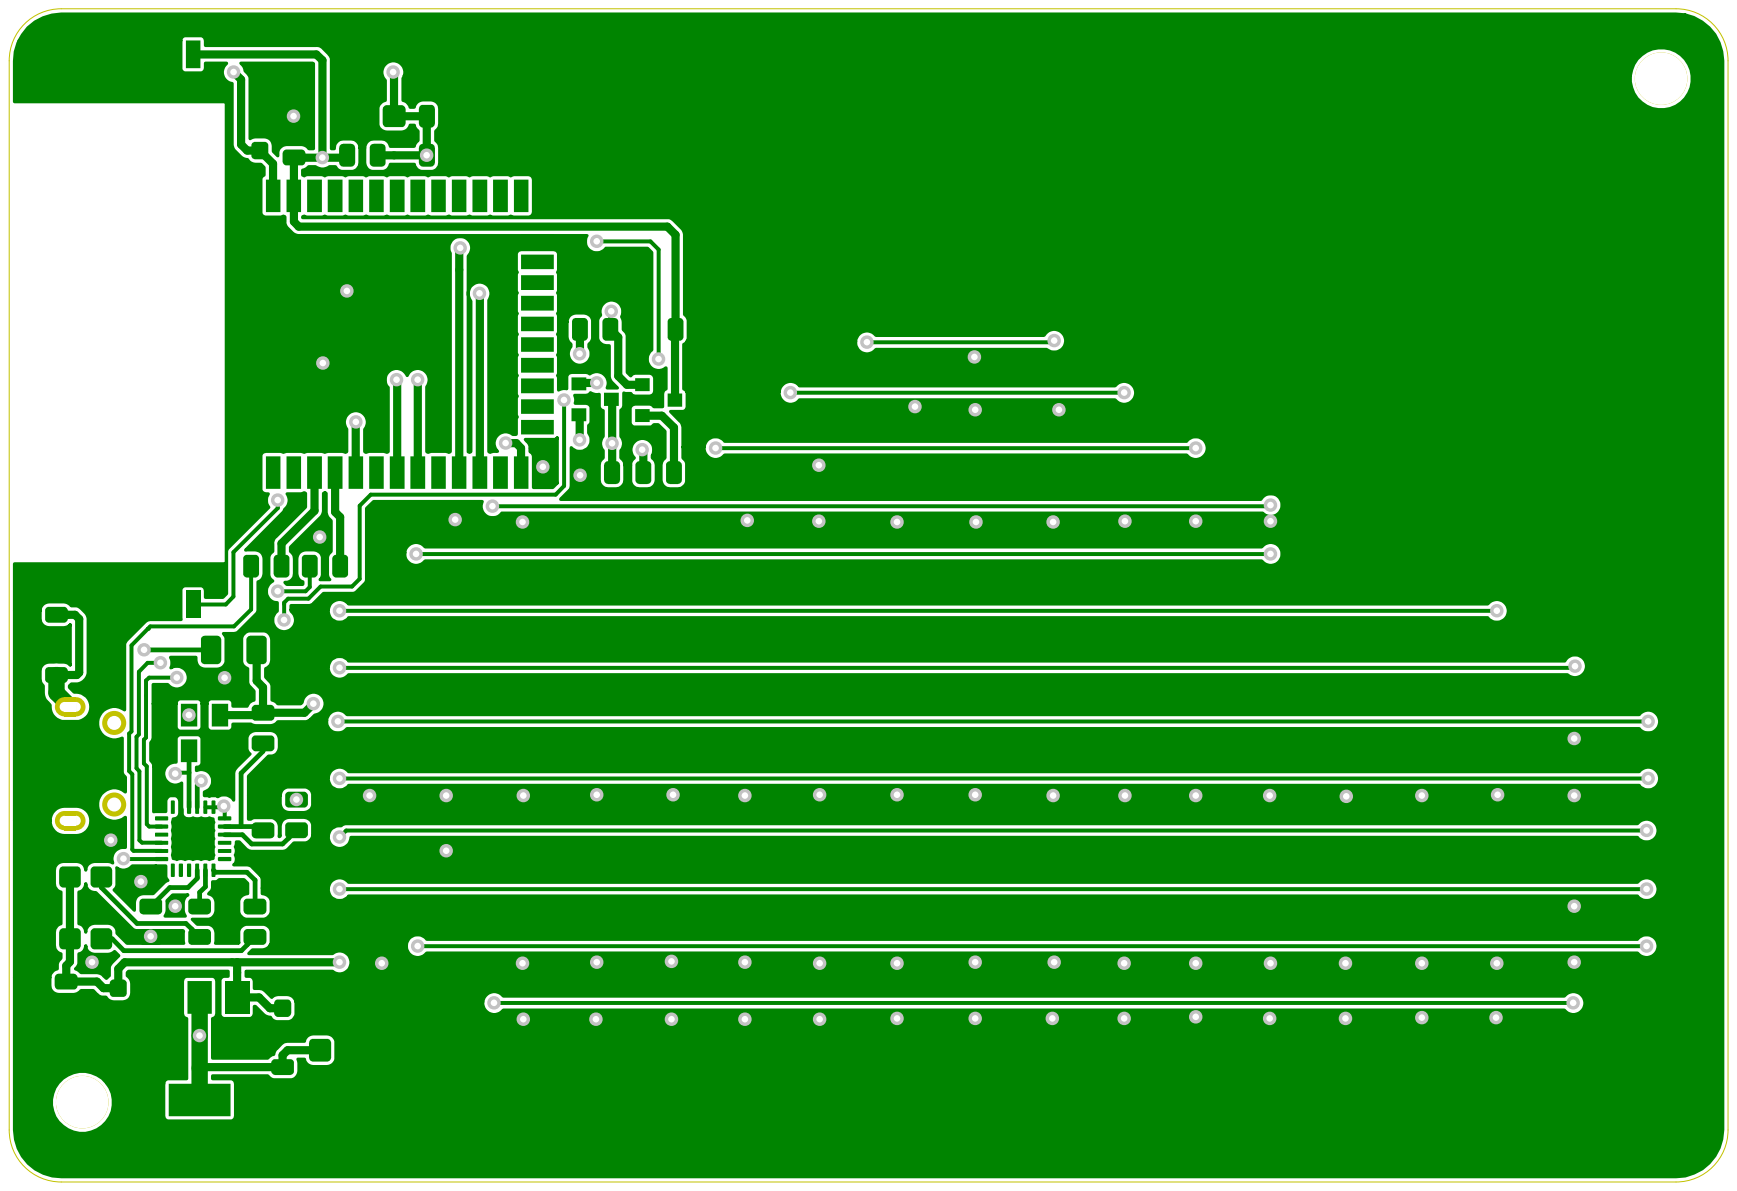
[picture p32: page 2]

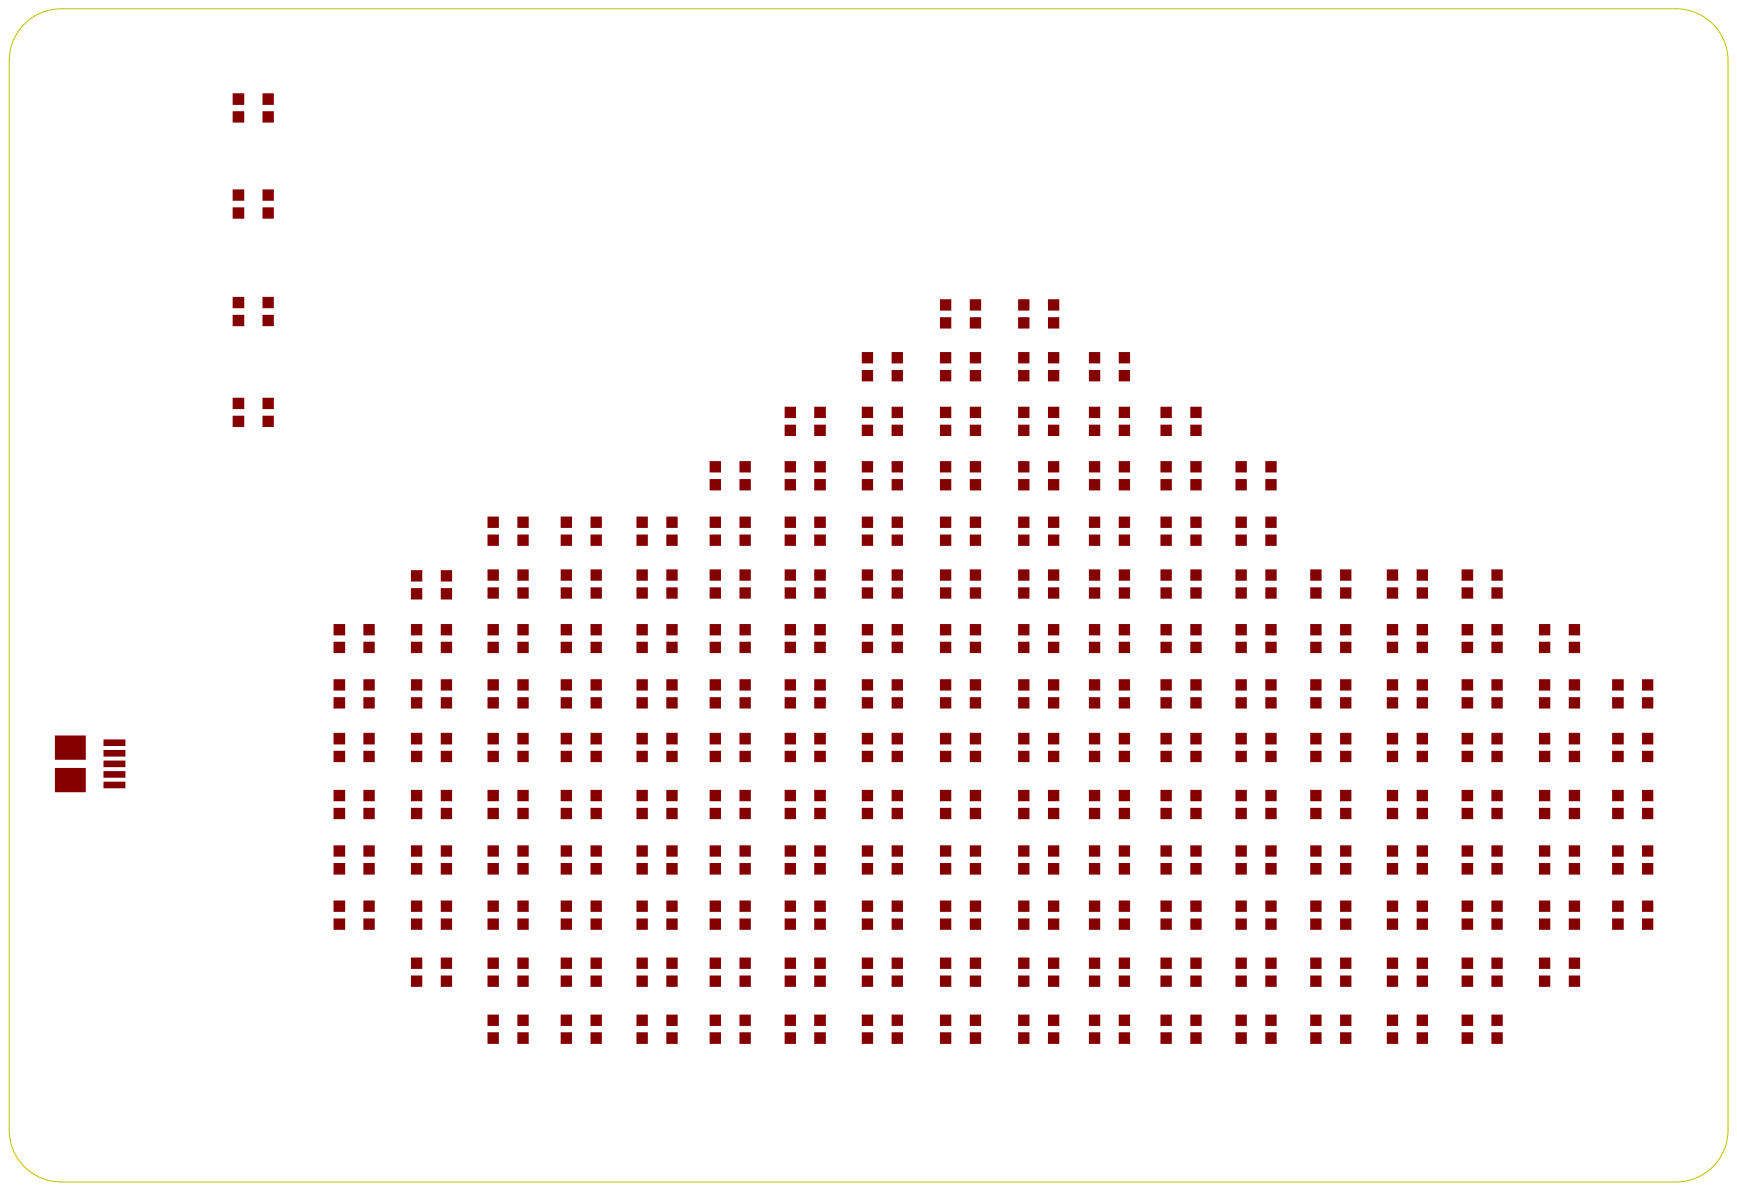
[picture p33: page 3]

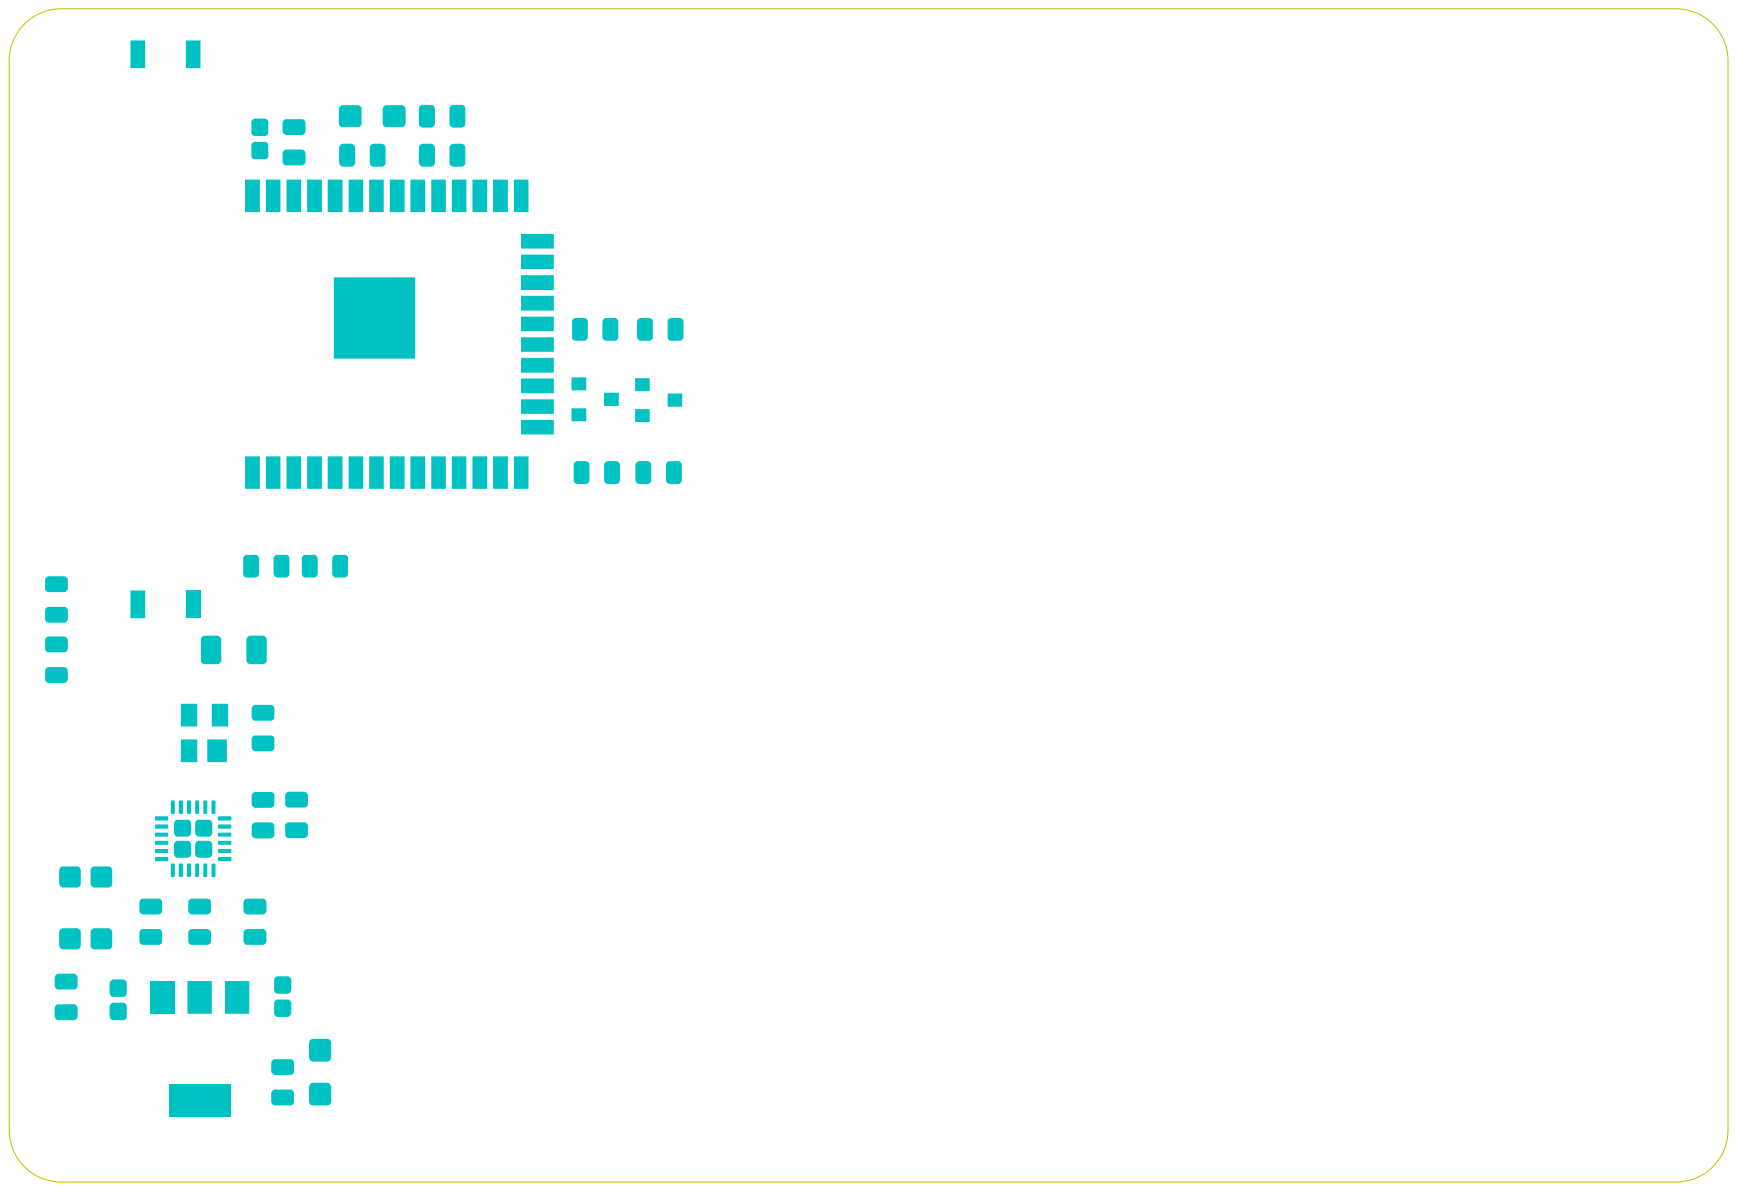
[picture p34: page 4]

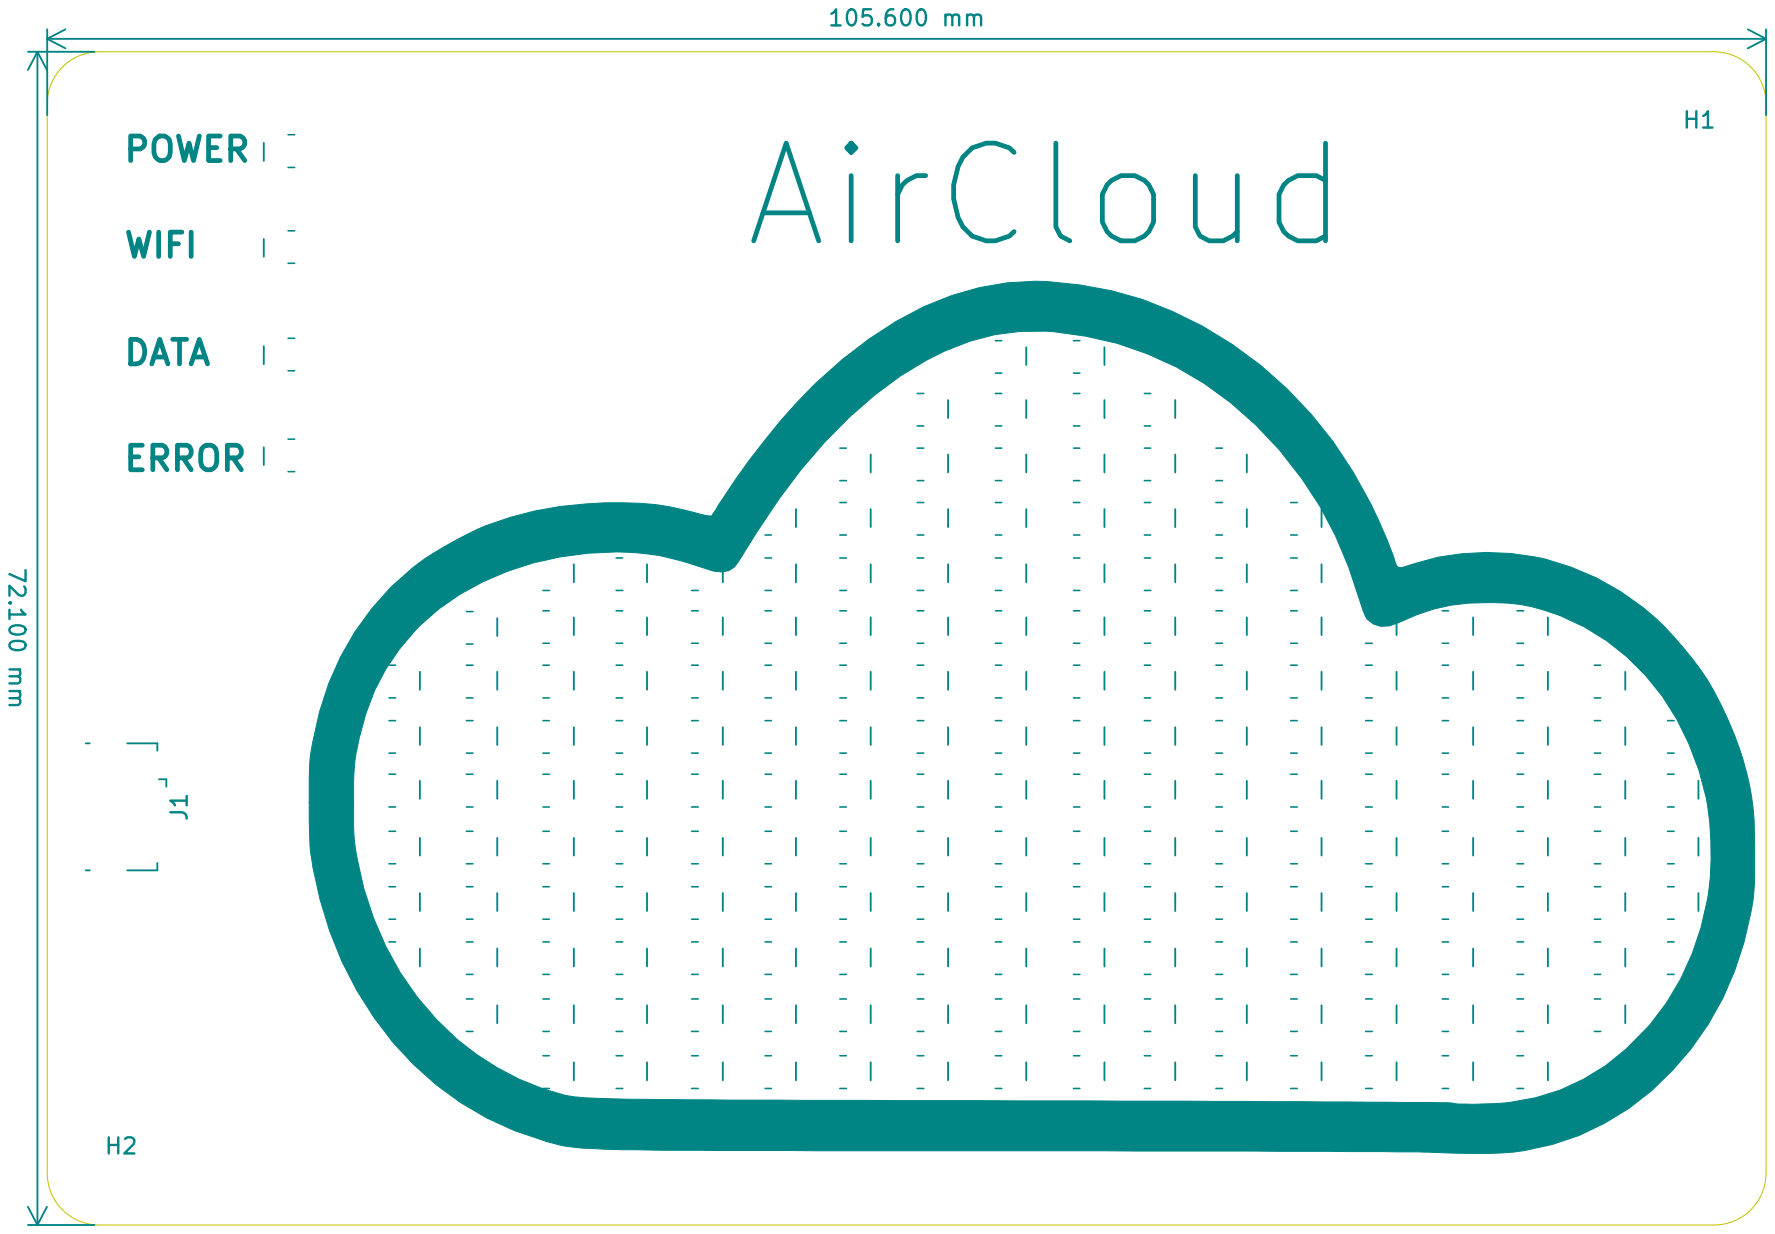
[picture p35: page 5]

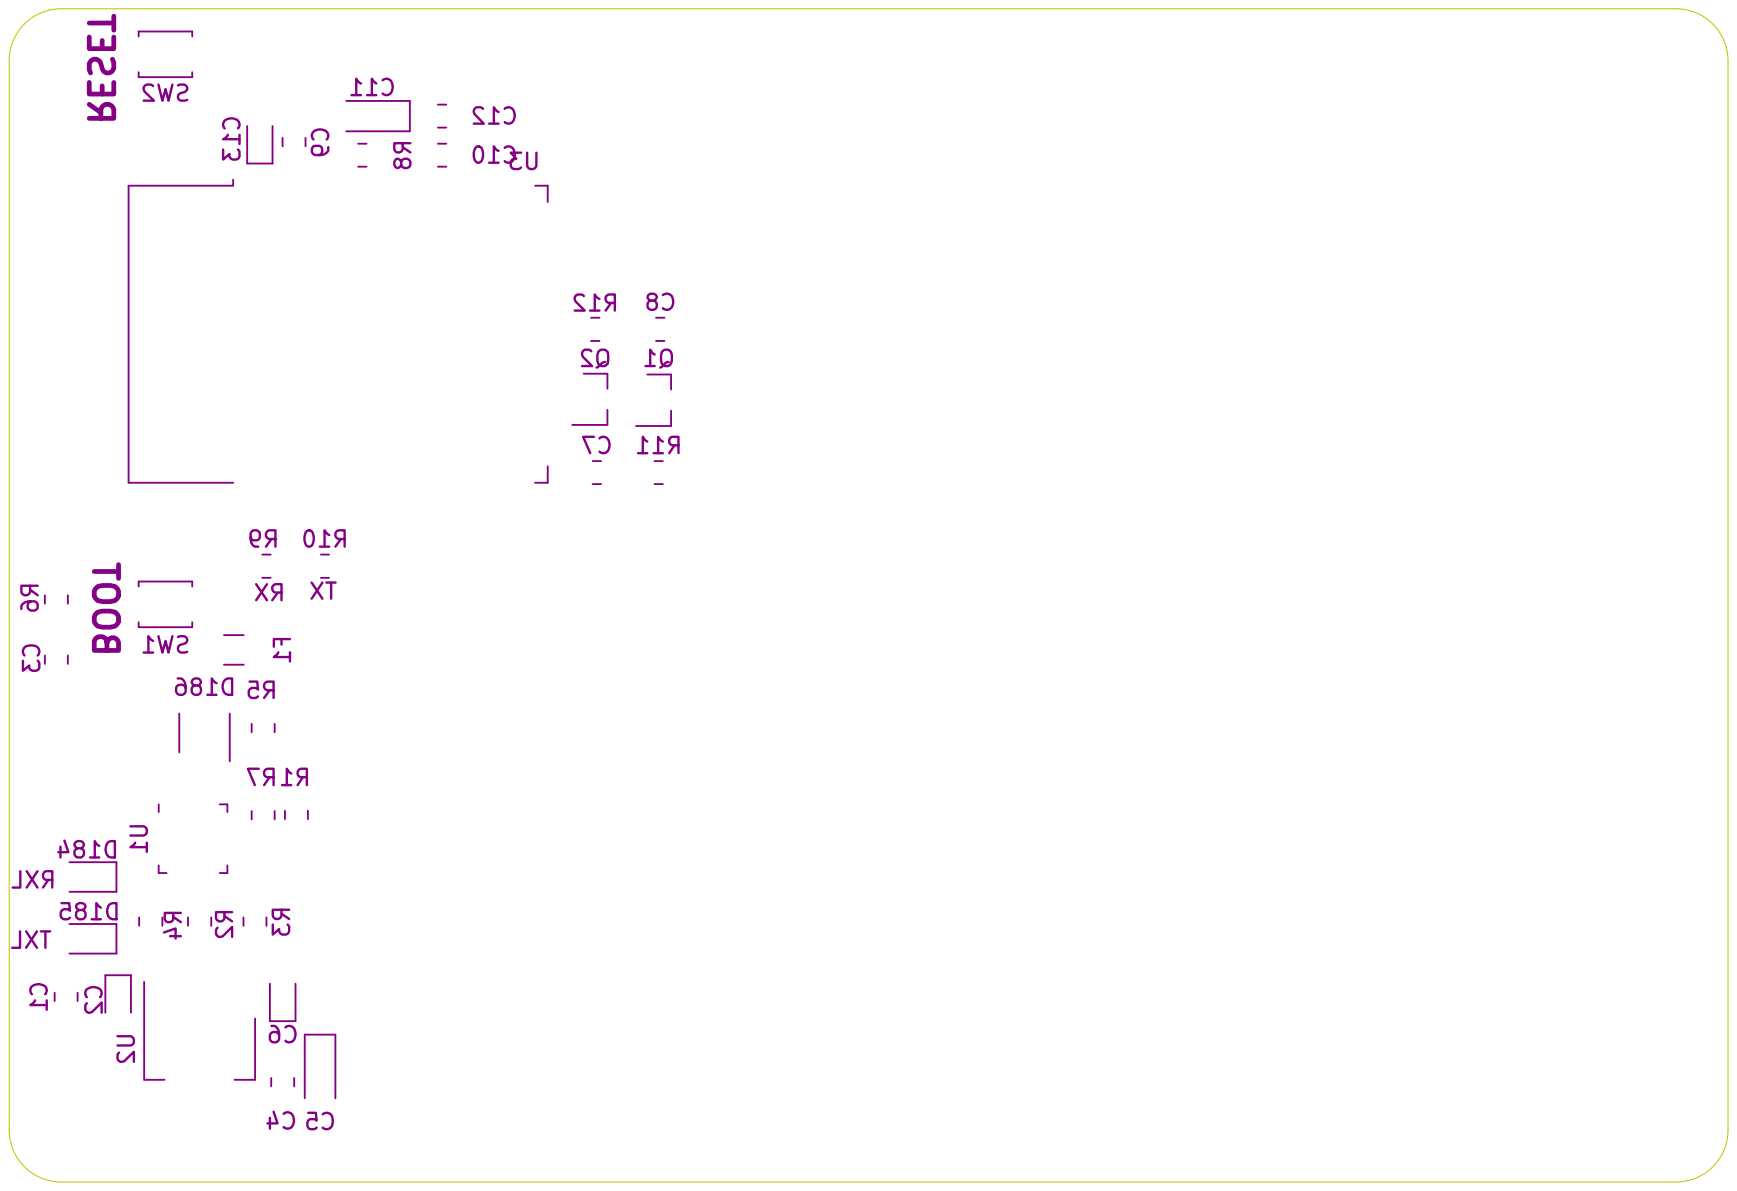
[picture p36: page 6]

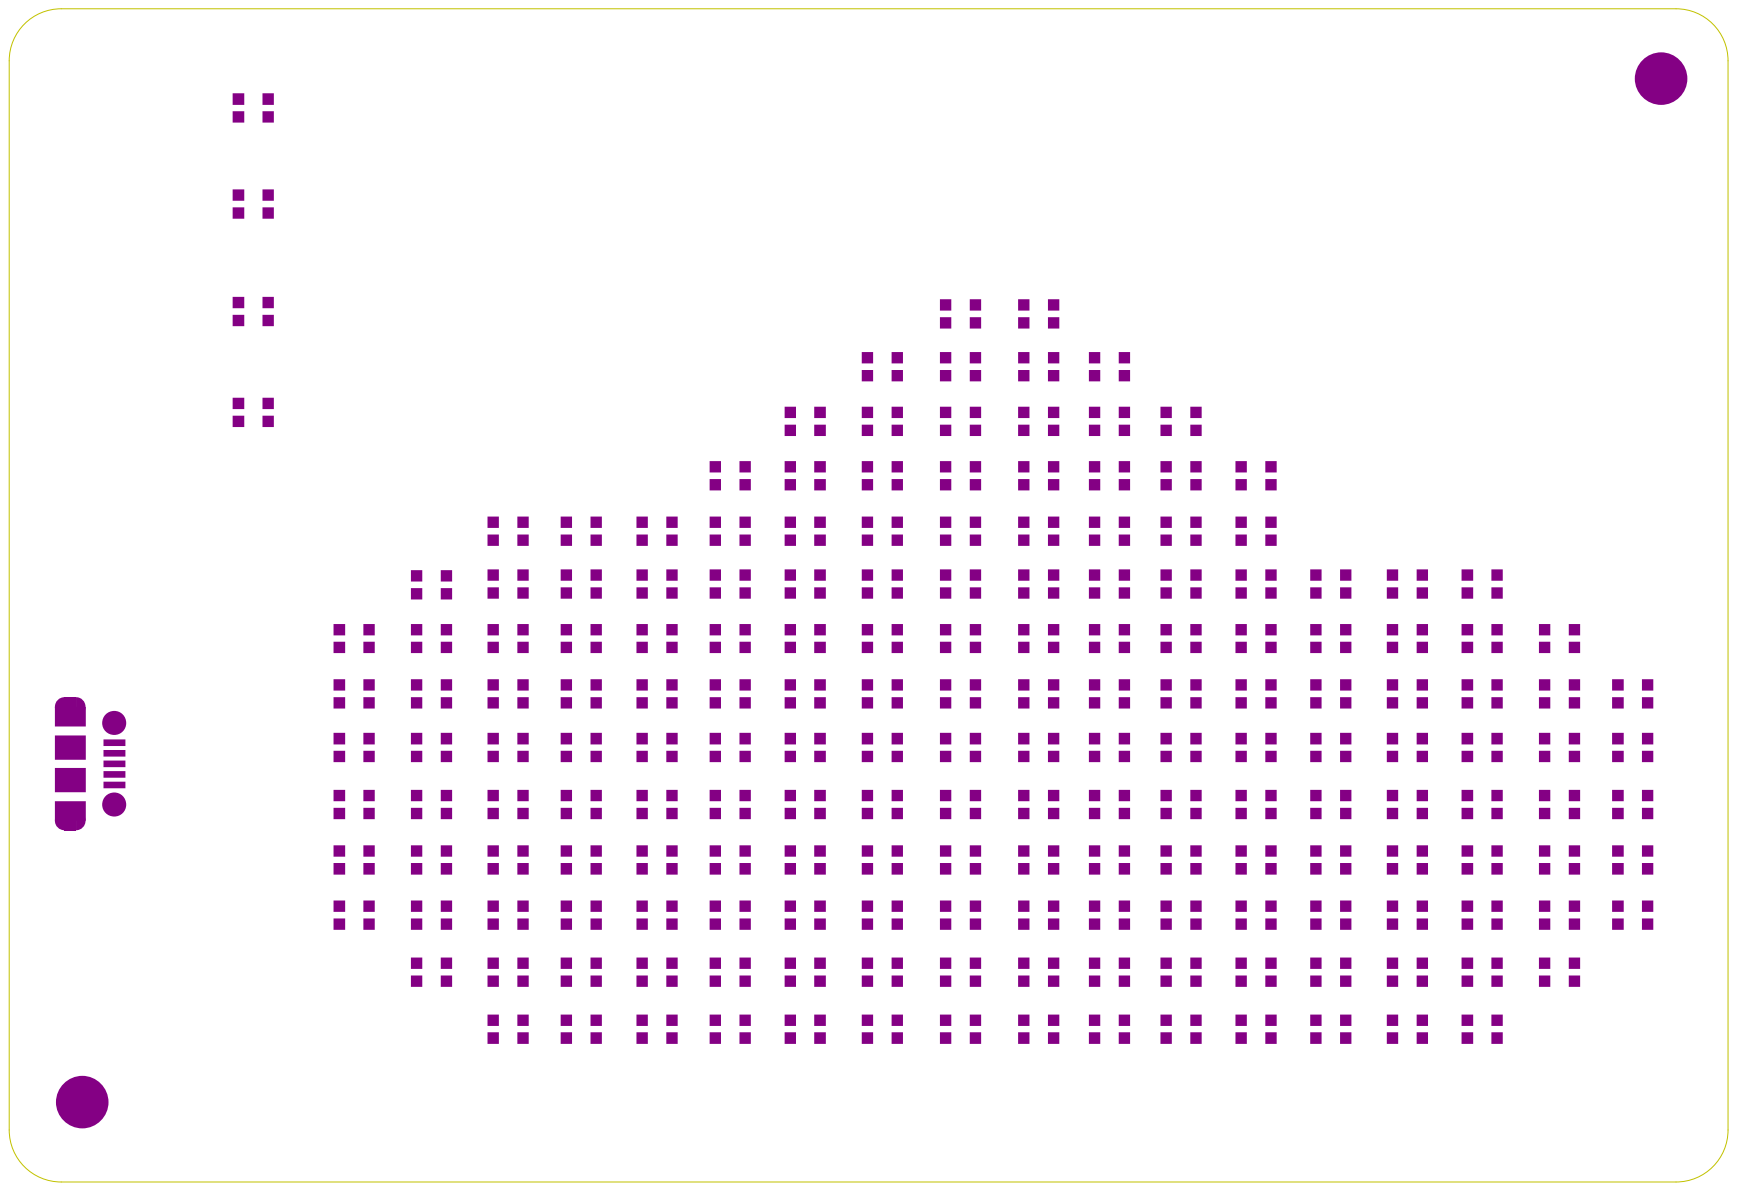
[picture p37: page 7]

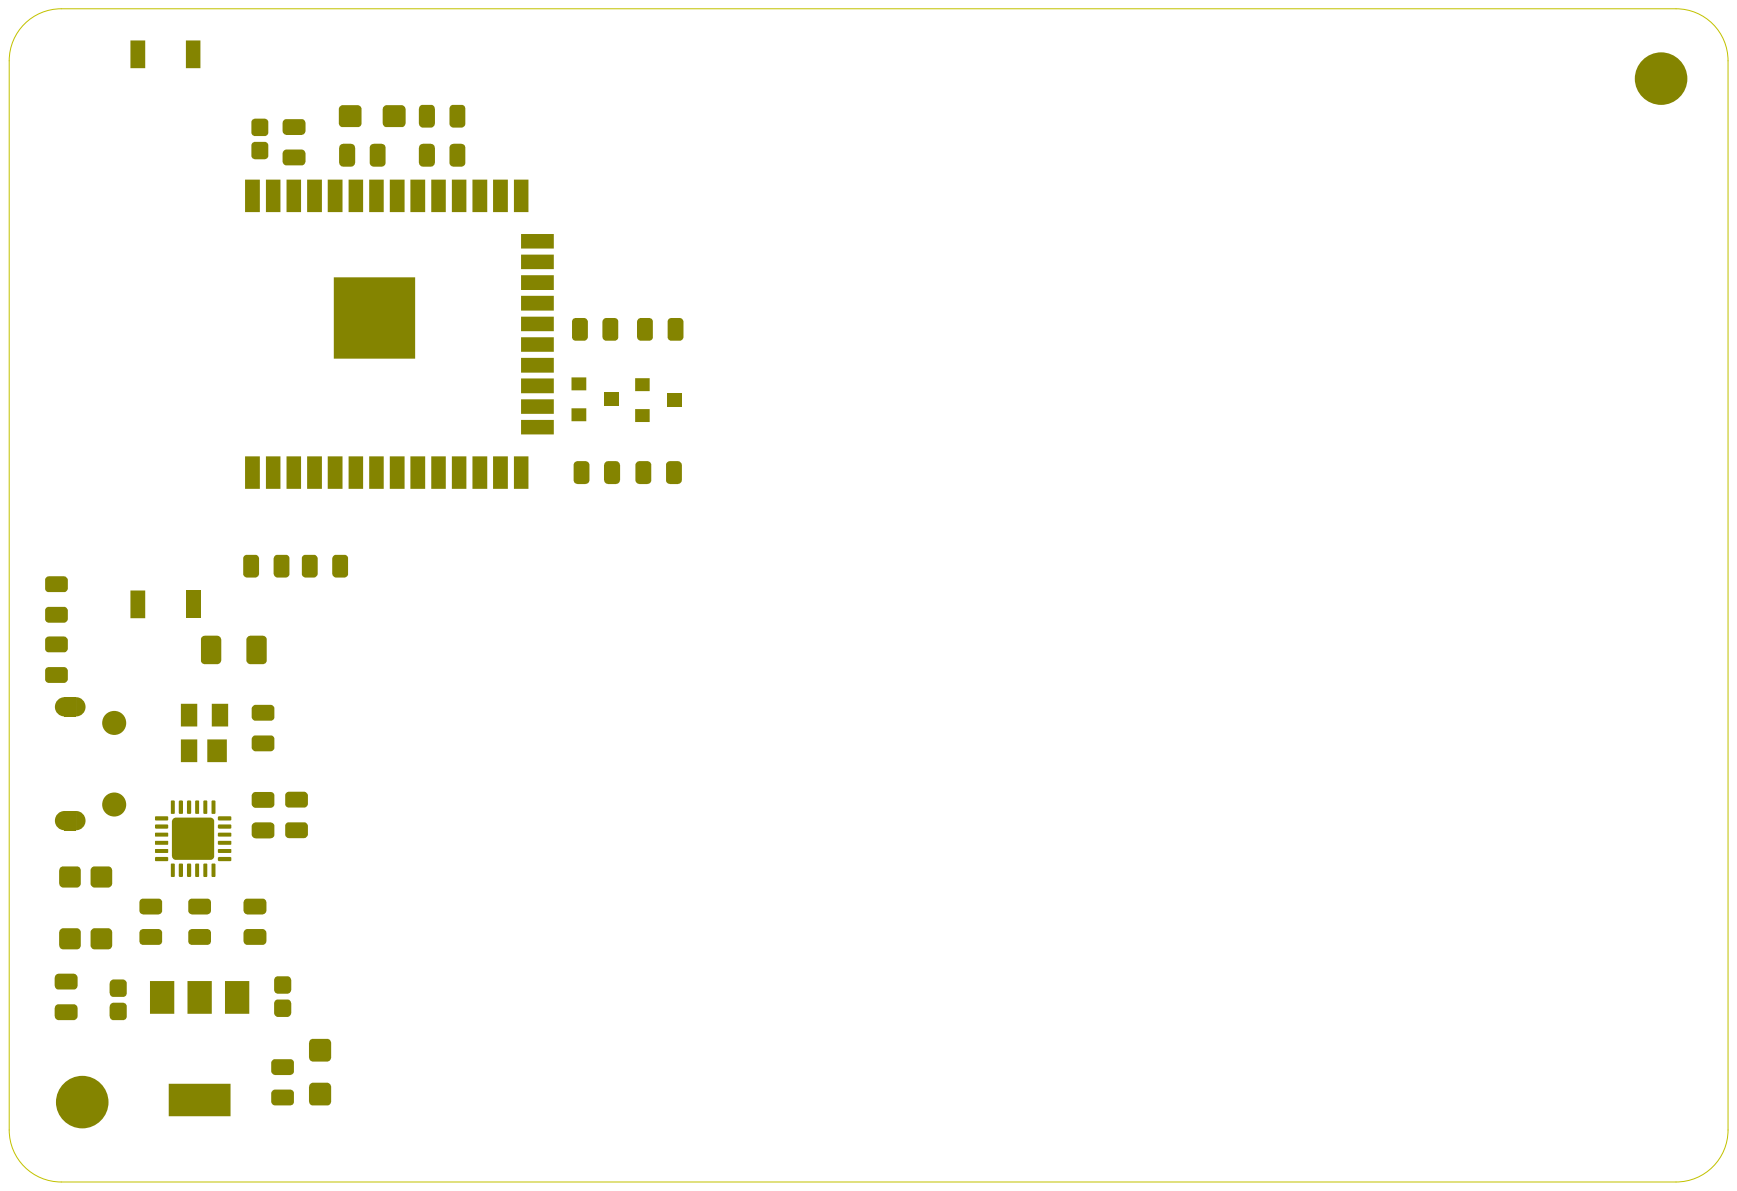
[picture p38: page 8]
