wasauce/AirCloudPCBs/AirCloudv1/Deliverables-matrix/Schematic.pdf

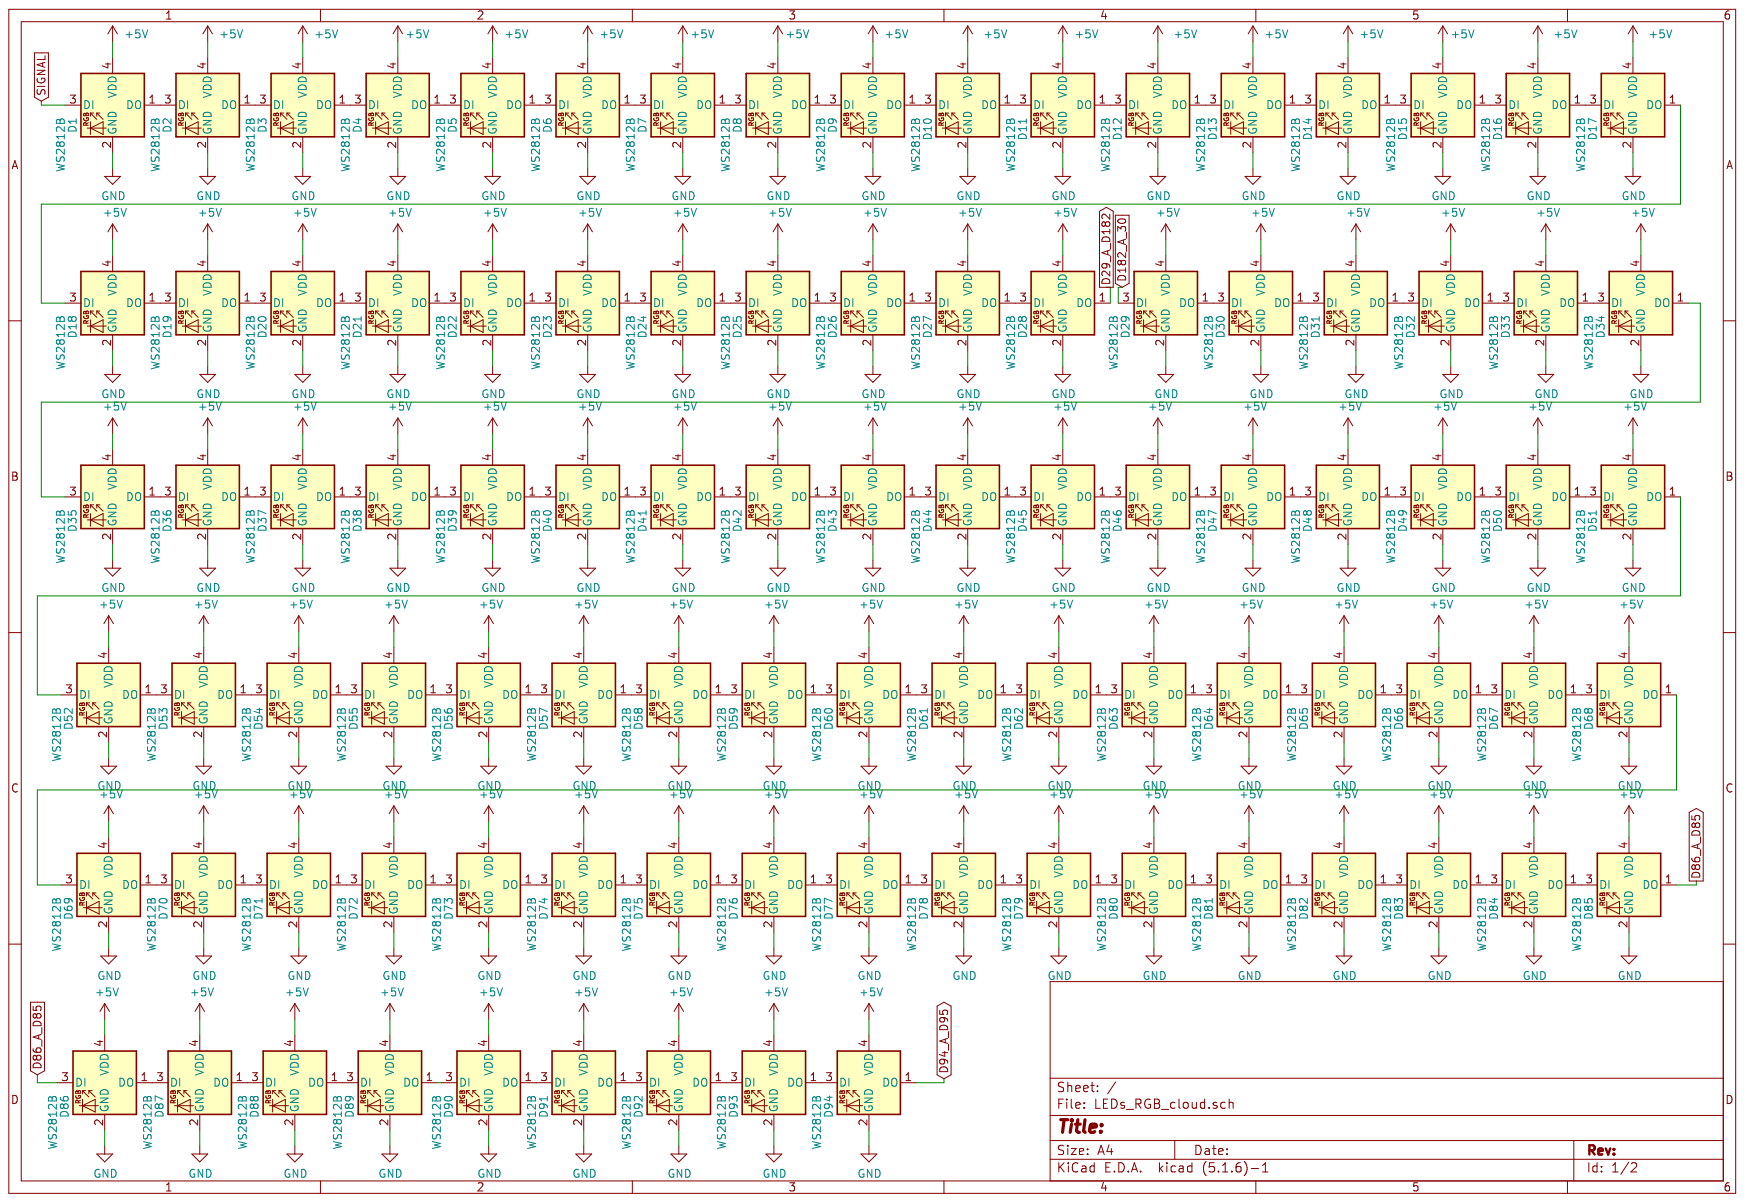
[picture p39: page 1]

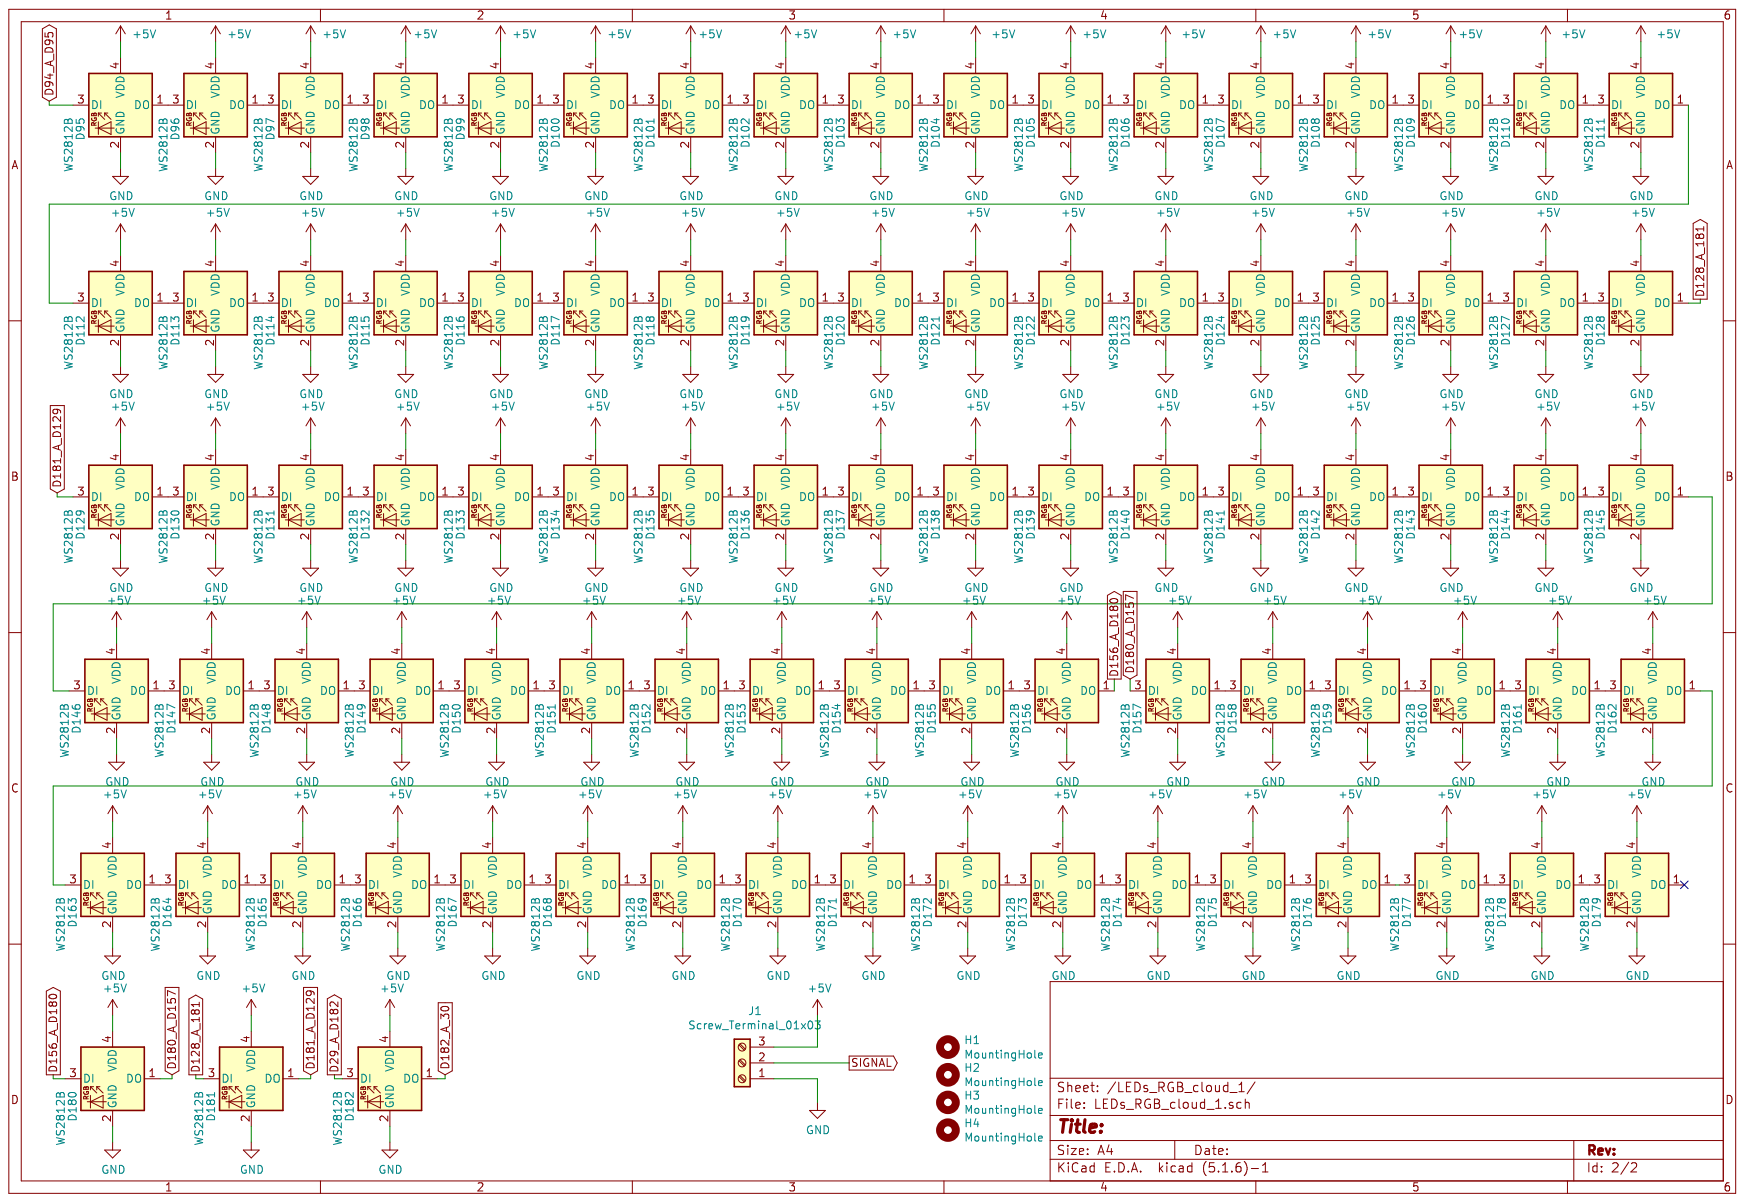
[picture p40: page 2]
