wasauce/AirCloudPCBs/AirCloudv1/Deliverables/Schematic.pdf

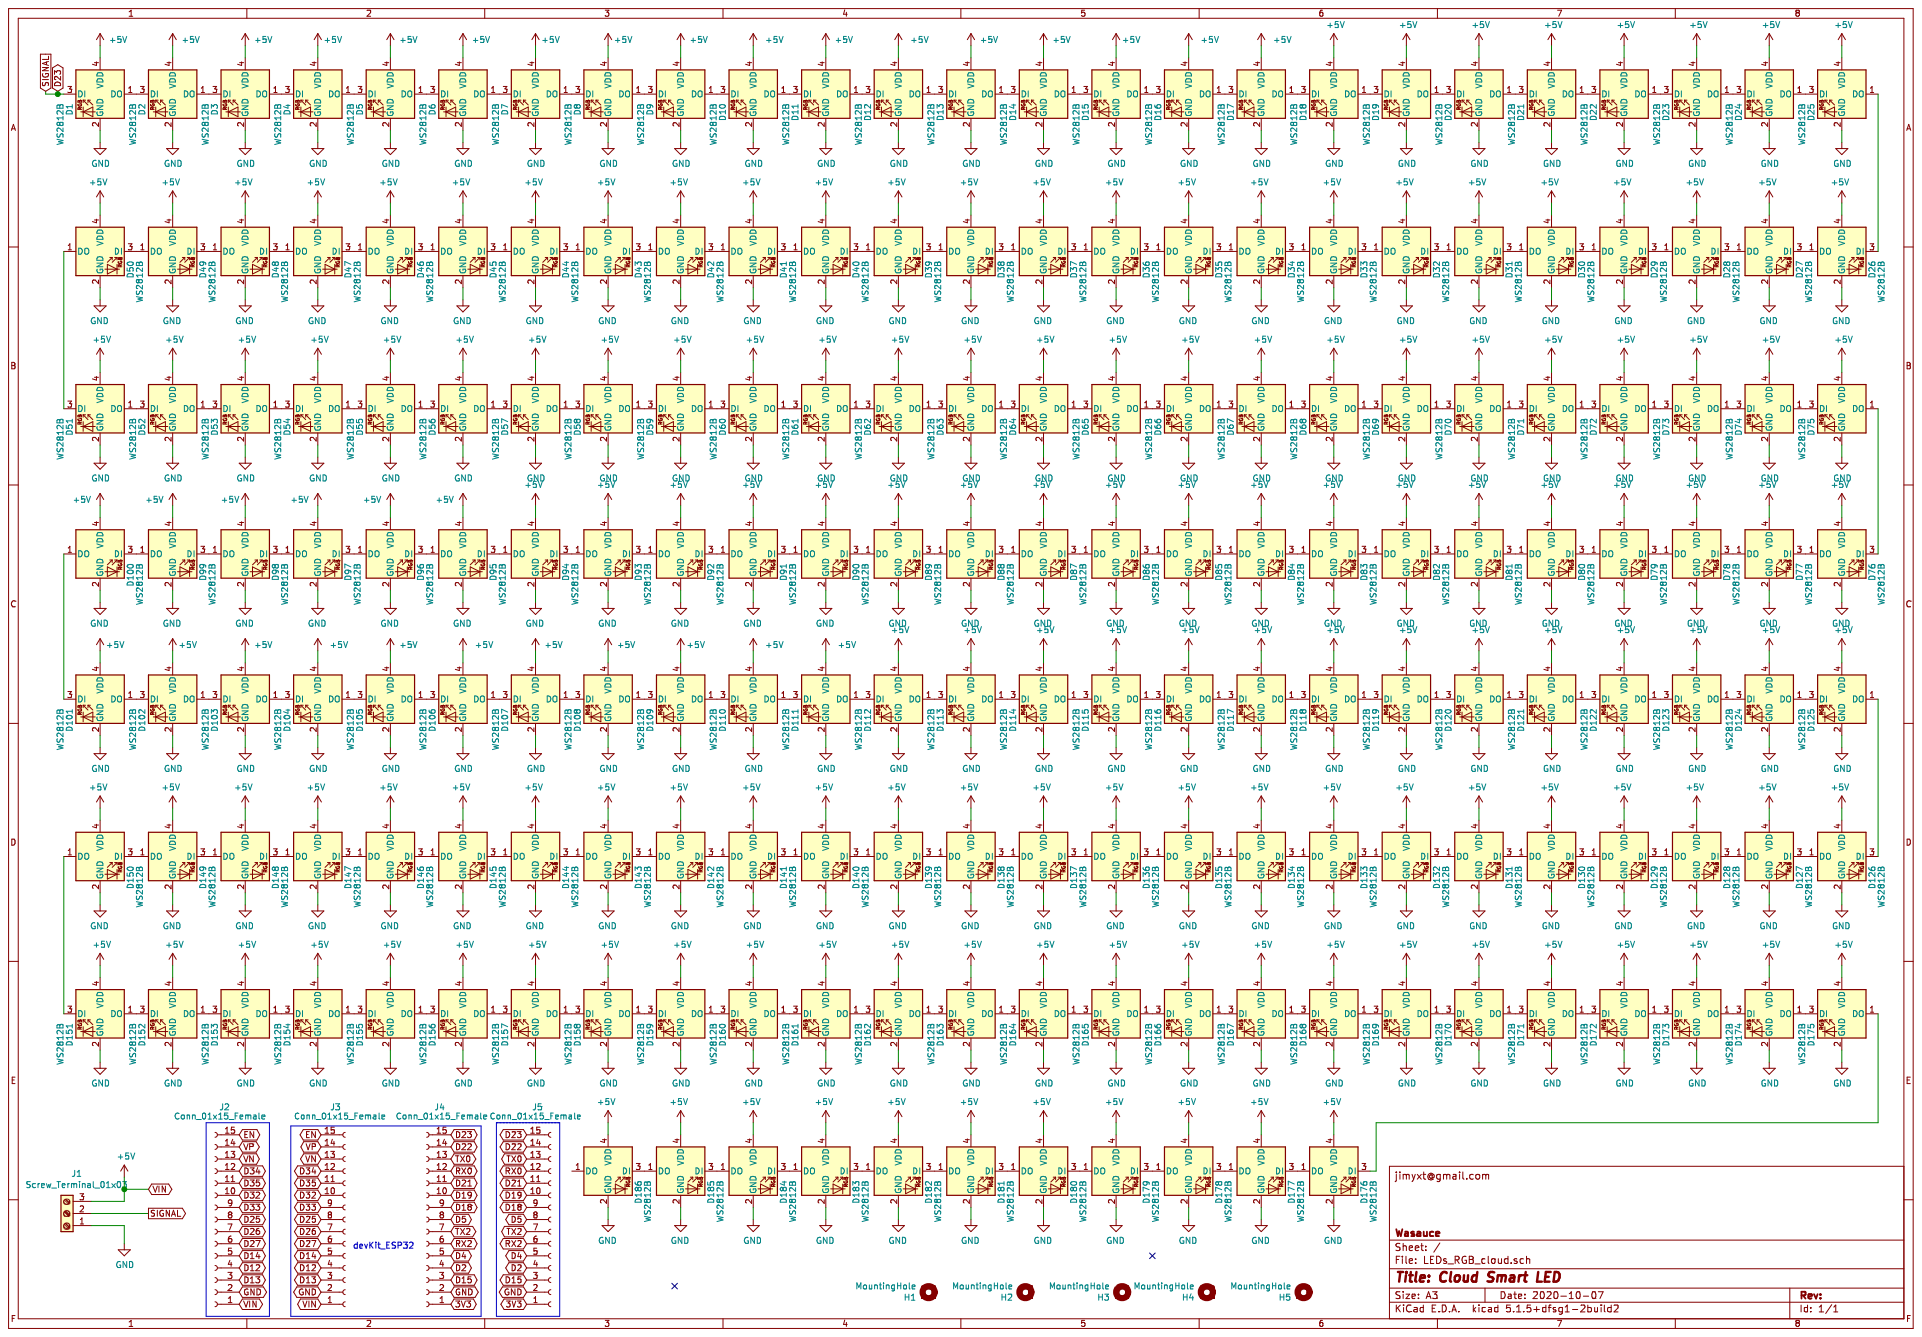
[picture p41: page 1]
