wasauce/AirCloudPCBs/AirCloudv2/LED_Cloud.kicad_pcb

## KiCad design AirCloudv2/LED_Cloud.kicad_pcb (2021-05-02)

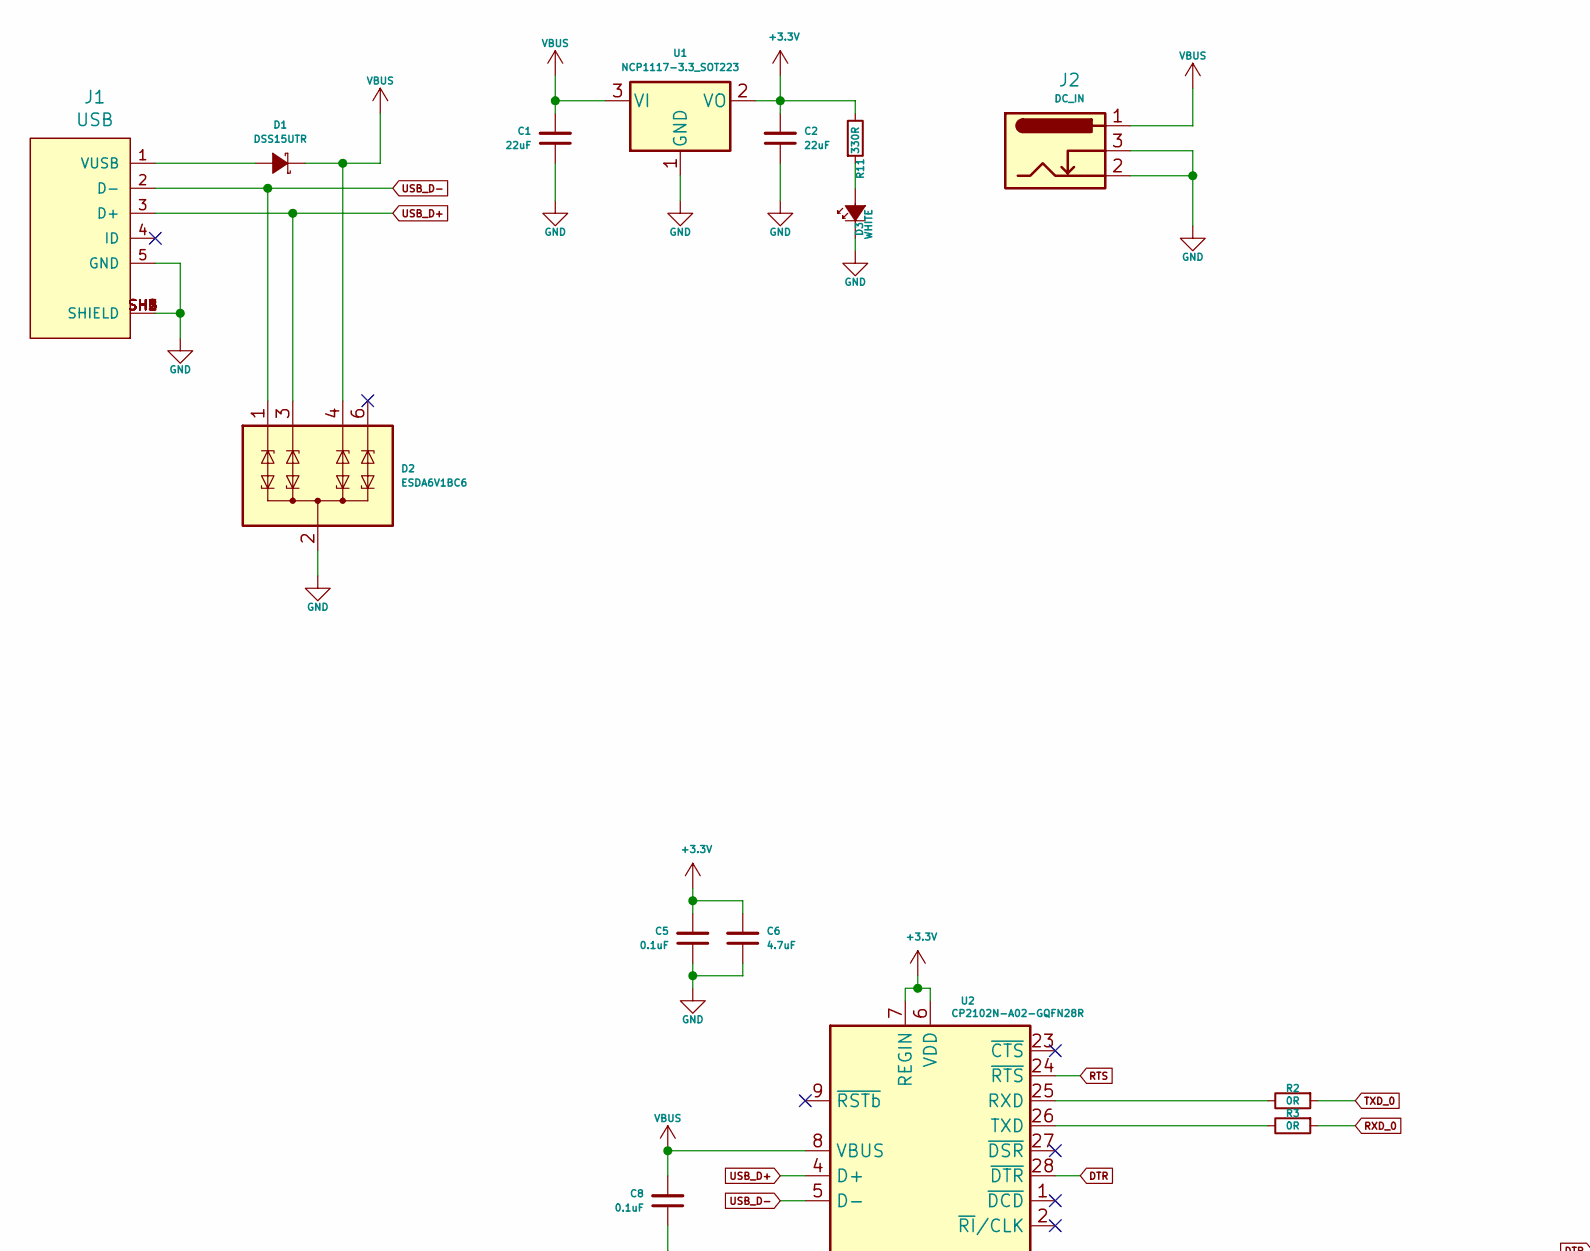
[picture p42: schematic LED_Cloud.sch, part in row 1, column 1]

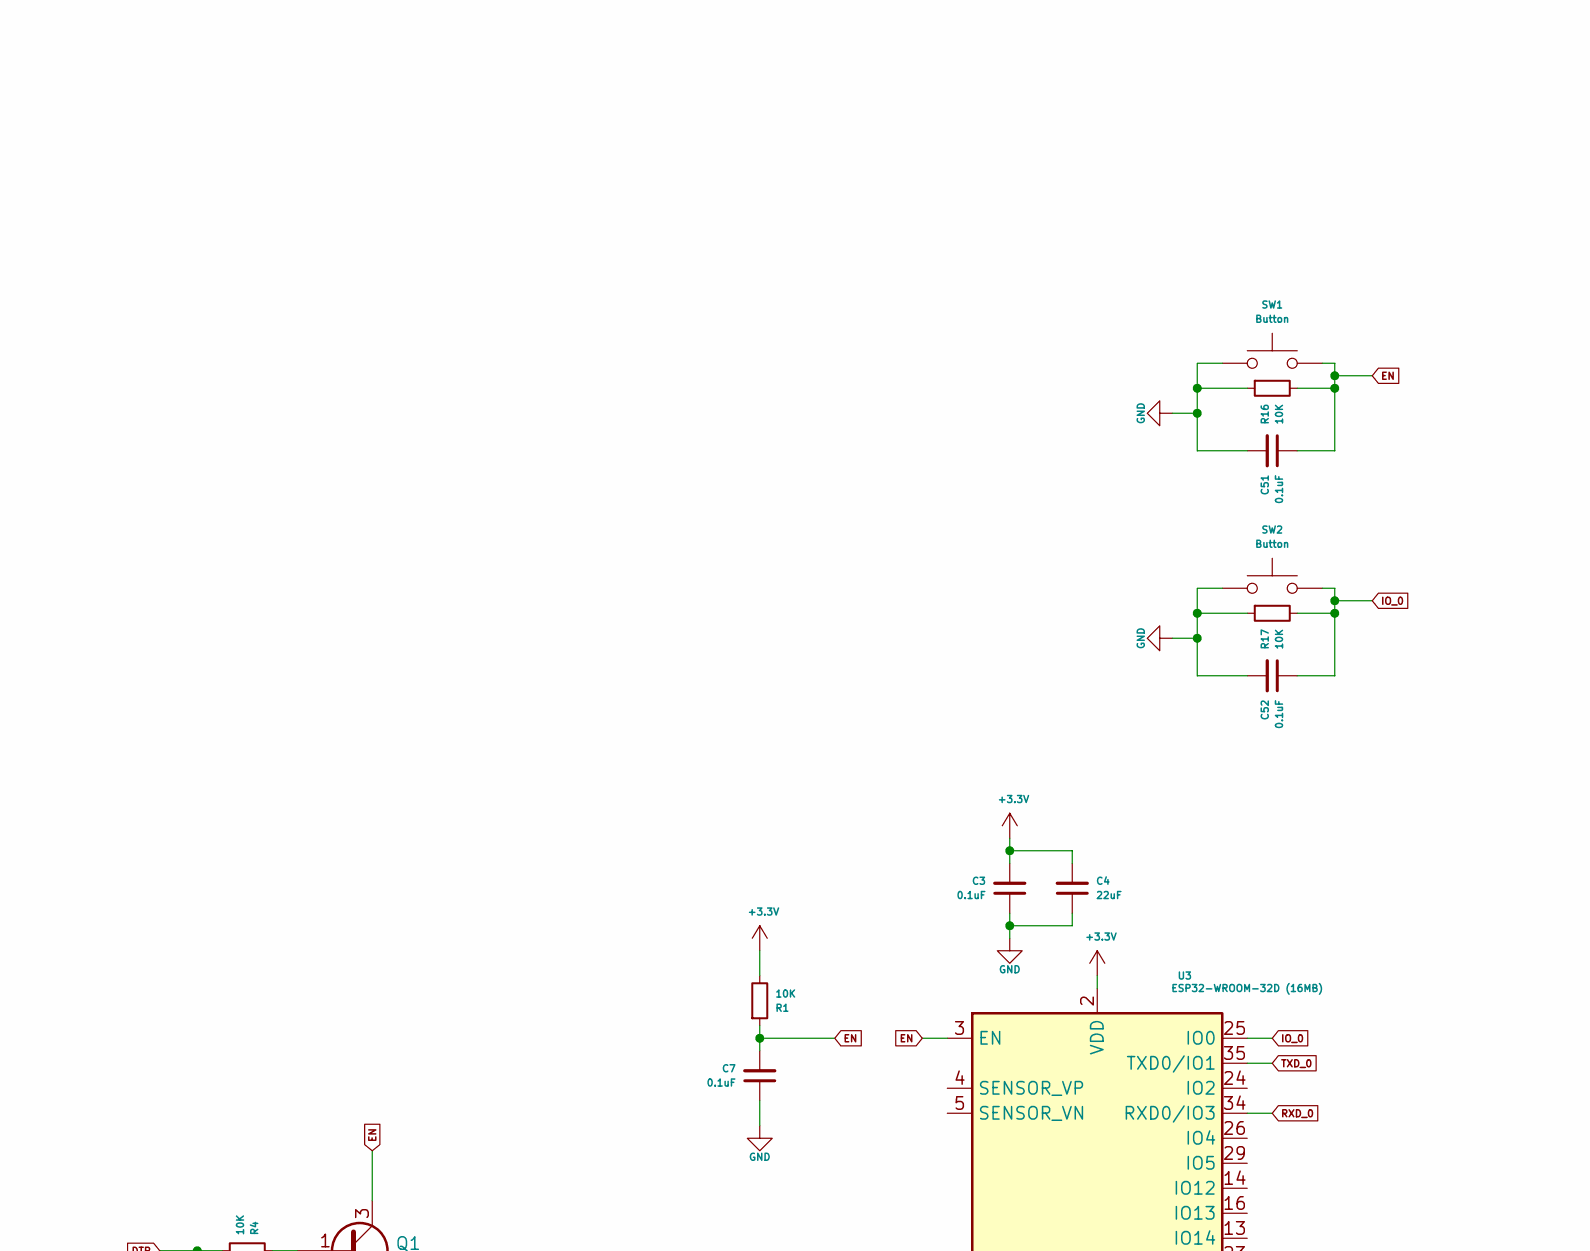
[picture p43: schematic LED_Cloud.sch, part in row 1, column 2]

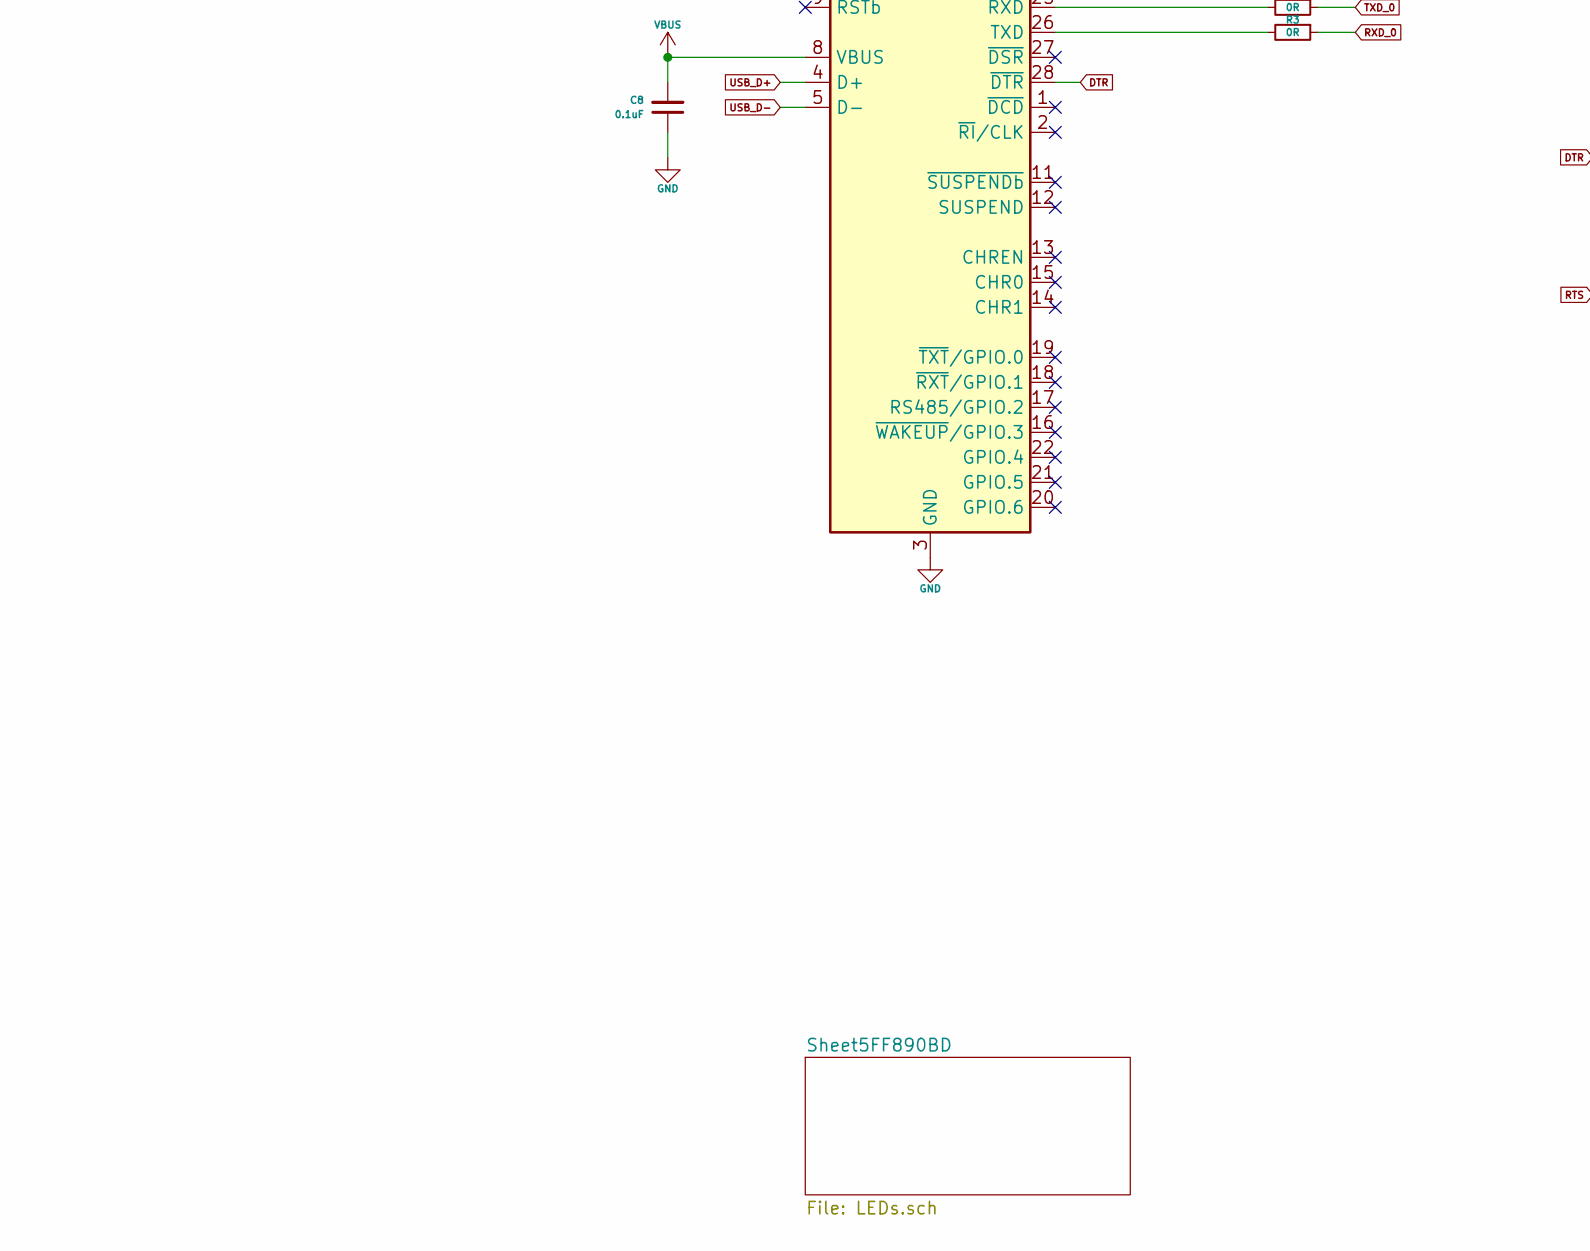
[picture p44: schematic LED_Cloud.sch, part in row 2, column 1]

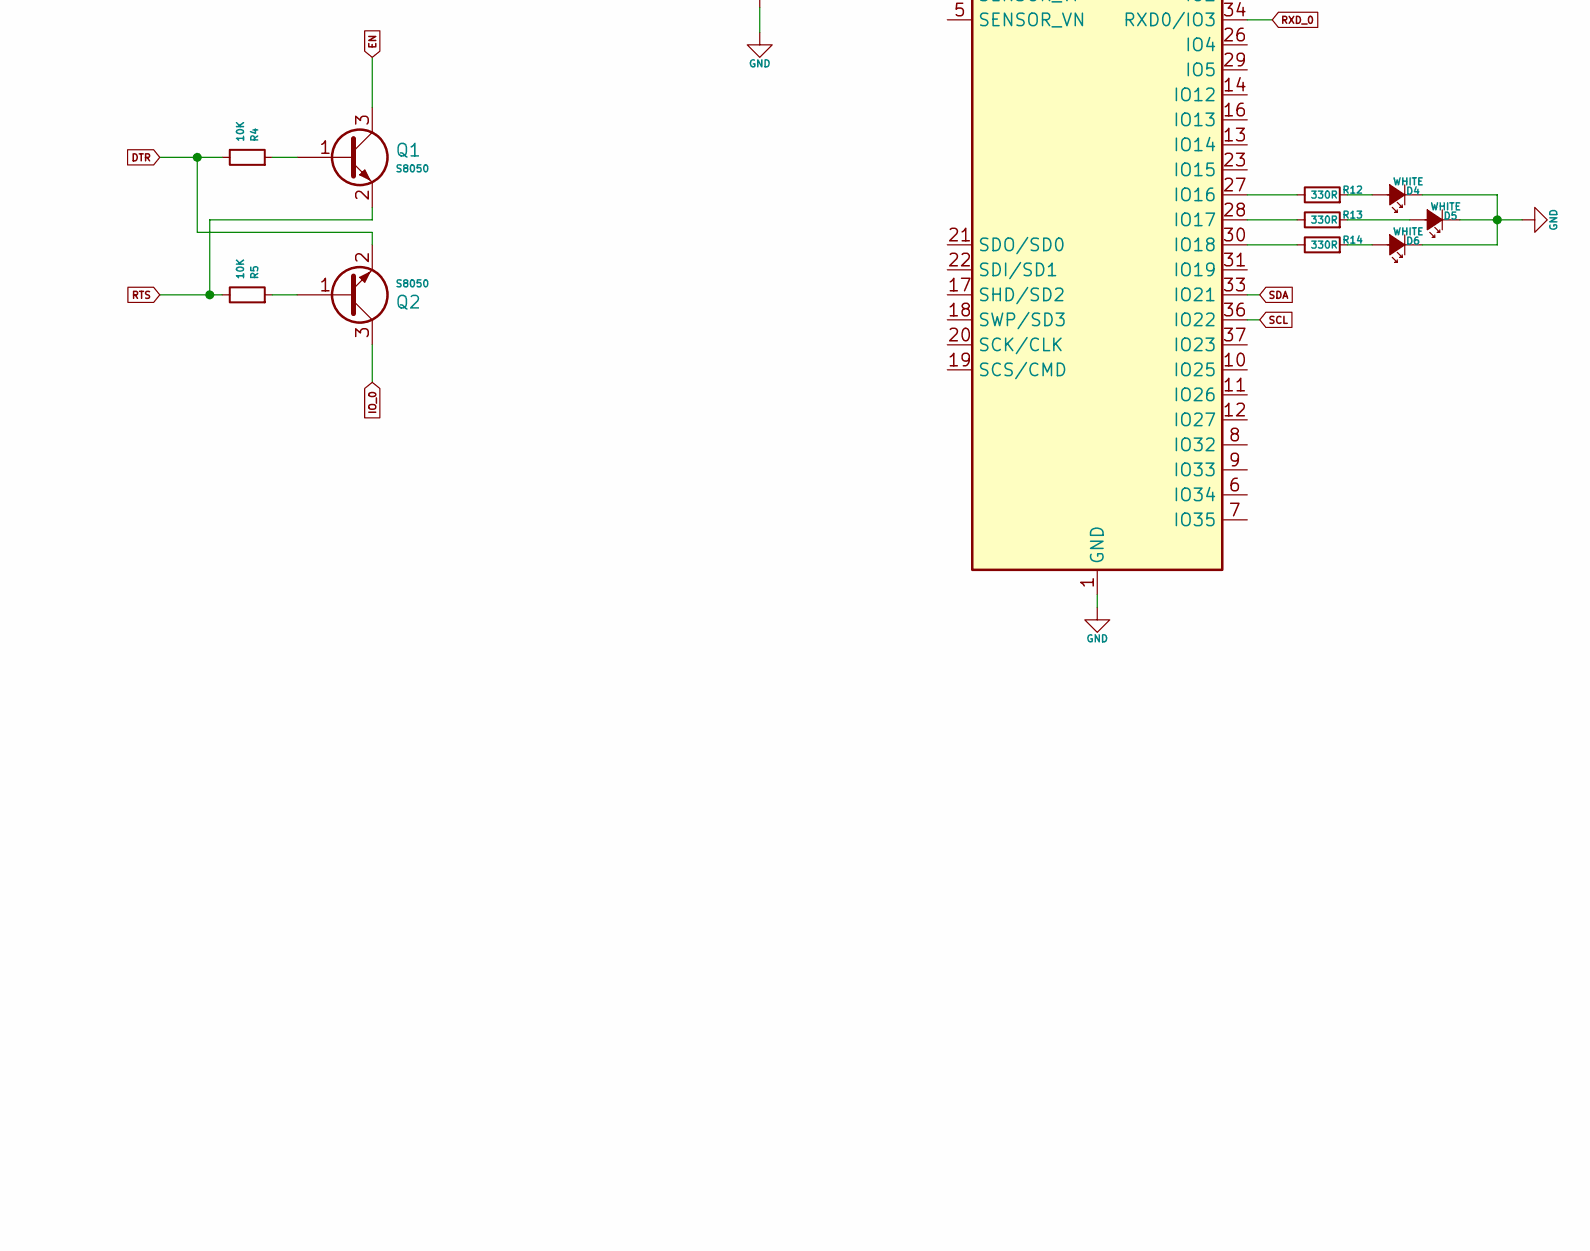
[picture p45: schematic LED_Cloud.sch, part in row 2, column 2]

Parts:
C1, C2, C4: CL21A226MOCLRNC; C_0805_2012Metric_Pad1.15x1.40mm_HandSolder; Manufacturer Part Number CL21A226MOCLRNC; Digikey Part # 1276-6780-1-ND
C3, C5, C7, C8, C51, C52: CC0603ZRY5V9BB104; C_0603_1608Metric; Manufacturer Part Number CC0603ZRY5V9BB104; Digikey Part # 311-1343-1-ND
C6: CL21A475KQFNNNE; C_0805_2012Metric_Pad1.15x1.40mm_HandSolder; Manufacturer Part Number CL21A475KQFNNNE; Digikey Part # 1276-1198-1-ND
D1: DSS15UTR; D_SOD-123F; Manufacturer Part Number DSS15UTR; Digikey Part # 1655-1928-1-ND
D2: ESDA6V1BC6; SOT-23-6; Manufacturer Part Number ESDA6V1BC6; Digikey Part # 497-6635-1-ND
D3, D4, D5, D6: 19-113Z/T1D-CP2Q2HY/3T; LED_0603_1608Metric; Manufacturer Part Number 19-113Z/T1D-CP2Q2HY/3T; Digikey Part # 1080-1573-1-ND
J1: 10118192-0001LF; AMPHENOL_10118192-0001LF; Manufacturer Part Number 10118192-0001LF; Digikey Part # 609-4613-1-ND
J2: 694108301002; BarrelJack_Wuerth_6941xx301002; Manufacturer Part Number 694108301002; Digikey Part # 732-5934-ND
Q1, Q2: MMSS8050-L-TP; SOT-23; Manufacturer Part Number MMSS8050-L-TP; Digikey Part # MMSS8050-L-TPMSCT-ND
R1, R4, R5, R16, R17: RC0603JR-0710KL; R_0603_1608Metric; Manufacturer Part Number RC0603JR-0710KL; Digikey Part # 311-10KGRCT-ND
R2, R3: RC0603FR-070RL; R_0603_1608Metric; Manufacturer Part Number RC0603FR-070RL; Digikey Part # 311-0.0HRCT-ND
R11, R12, R13, R14: CRGCQ0603J330R; R_0603_1608Metric; Manufacturer Part Number CRGCQ0603J330R; Digikey Part # A130088CT-ND
SW1, SW2: PTS815 SJM 250 SMTR LFS; PTS815_SJM_250_SMTR_LFS; Manufacturer Part Number PTS815 SJM 250 SMTR LFS; Digikey Part # CKN12215-1-ND
U1: NCP1117LPST33T3G; SOT-223-3_TabPin2; Manufacturer Part Number NCP1117LPST33T3G; Digikey Part # NCP1117LPST33T3GOSCT-ND
U2: CP2102N-A02-GQFN28R; QFN-28-1EP_5x5mm_P0.5mm_EP3.35x3.35mm; Manufacturer Part Number CP2102N-A02-GQFN28R; Digikey Part # 336-5890-1-ND
U3: ESP32-WROOM-32D (16MB); ESP32-WROOM-32; Manufacturer Part Number ESP32-WROOM-32D (16MB); Digikey Part # 1904-1025-1-ND

Connections:
+3V3: C2.2, C3.2, C4.2, C5.2, C6.2, R1.2, R11.2, U1.2 (VO), U2.6 (VDD), U2.7 (REGIN), U3.2 (VDD); also elsewhere on the board
DTR: Q2.2 (E), R4.2, U2.28 (~DTR)
EN: C7.2, C51.1, Q1.3 (C), R1.1, R16.2, SW1.2, U3.3 (EN)
GND: C1.1, C2.1, C3.1, C4.1, C5.1, C6.1, C7.1, C8.1, C51.2, C52.2, D2.2 (COM), D2.5 (COM), D3.1 (K), D4.1 (K), D5.1 (K), D6.1 (K), J1.5 (GND), J1.SH1 (SHIELD), J1.SH2 (SHIELD), J1.SH3 (SHIELD), J1.SH4 (SHIELD), J1.SH5 (SHIELD), J1.SH6 (SHIELD), J2.2, J2.3, R16.1, R17.1, SW1.1, SW2.1, U1.1 (GND), U2.3 (GND), U2.29 (GND), U3.1 (GND), U3.15 (GND), U3.38 (GND), U3.39 (GND); also elsewhere on the board
IO_0: C52.1, Q2.3 (C), R17.2, SW2.2, U3.25 (IO0)
unnamed: D1.2 (A), J1.1 (VUSB)
unnamed: D3.2 (A), R11.1
unnamed: D4.2 (A), R12.1
unnamed: D5.2 (A), R13.1
unnamed: D6.2 (A), R14.1
unnamed: Q1.1 (B), R4.1
unnamed: Q2.1 (B), R5.1
unnamed: R2.2, U2.25 (RXD)
unnamed: R3.2, U2.26 (TXD)
unnamed: R12.2, U3.27 (IO16)
unnamed: R13.2, U3.28 (IO17)
unnamed: R14.2, U3.30 (IO18)
RTS: Q1.2 (E), R5.2, U2.24 (~RTS)
RXD_0: R3.1, U3.34 (RXD0/IO3)
SCL: U3.36 (IO22); also elsewhere on the board
SDA: U3.33 (IO21); also elsewhere on the board
TXD_0: R2.1, U3.35 (TXD0/IO1)
USB_D+: D2.3 (TVS2), J1.3 (D+), U2.4 (D+)
USB_D-: D2.1 (TVS1), J1.2 (D-), U2.5 (D-)
VBUS: C1.2, C8.2, D1.1 (K), D2.4 (TVS3), J2.1, U1.3 (VI), U2.8 (VBUS); also elsewhere on the board

Schematic: LEDs.sch

Parts:
C9, C10, C11, C15, C16, C17, C18, C22, C23, C24, C25, C29, C30, C31, C32, C36, C37, C38, C39, C43, C44, C45, C46, C50: 885012106020; C_0603_1608Metric; Manufacturer Part Number 885012106020; Digikey Part # 732-7917-1-ND
C12, C13, C14, C19, C20, C21, C26, C27, C28, C33, C34, C35, C40, C41, C42, C47, C48, C49: CC0603ZRY5V9BB104; C_0603_1608Metric; Manufacturer Part Number CC0603ZRY5V9BB104; Digikey Part # 311-1343-1-ND
D10, D11, D12, D13, D14, D25, D26, D27, D28, D29, D30, D31, D32, D40, D41, D42, D43, D44, D45, D46, D47, D48, D49, D55, D56, D57, D58, D59, D60, D61, D62, D63, D64, D65, D66, D71, D72, D73, D74, D75, D76, D77, D78, D79, D80, D81, D82, D87, D88, D89, D90, D91, D92, D93, D94, D95, D96, D97, D98, D103, D104, D105, D106, D107, D108, D109, D110, D111, D112, D113, D114, D118, D119, D120, D121, D122, D123, D124, D125, D126, D127, D128, D129, D130, D133, D134, D135, D136, D137, D138, D139, D140, D141, D142, D143, D144, D145, D146, D148, D149, D150, D151, D152, D153, D154, D155, D156, D157, D158, D159, D160, D161, D162, D163, D164, D165, D166, D167, D168, D169, D170, D171, D172, D173, D174, D175, D176, D177, D178, D179, D180, D181, D182, D183, D184, D185, D186, D187, D188, D189, D190, D191, D192, D193, D194, D195, D196, D197, D198, D199, D200, D201, D202, D203, D204, D205, D206, D207, D208, D209, D210, D211, D212, D213, D214, D215, D216, D217, D218, D219, D220, D221, D222, D223, D224, D225, D226, D228, D229, D230, D231, D232, D233, D234, D235, D236, D237, D238, D239, D240, D241, D242, D245, D246, D247, D248, D249, D250, D251, D252, D253, D254, D255, D256, D257, D258, D262, D263, D264, D265, D266, D267, D268, D269, D270, D271, D272, D273, D274, D279, D280, D281, D282, D283, D284, D285, D286, D287, D288, D289, D290, D296, D297, D298, D299, D300, D301, D302, D303, D304, D305, D306, D312, D313, D314, D315, D316, D317, D318, D319, D320, D321, D322, D329, D330, D331, D332, D333, D334, D335, D336, D337, D338, D345, D346, D347, D348, D349, D350, D351, D352, D353, D361, D362, D363, D364, D365, D366, D367, D368, D378, D379, D380, D381, D382: XZM2CRKM2DGFBB45SCCB; LED_XZM2CRKM2DGFBB45SCCB; PARTREV Feb 28, 2019
R6, R7, R8, R9: RC0603JR-0710KL; R_0603_1608Metric; Manufacturer Part Number RC0603JR-0710KL; Digikey Part # 311-10KGRCT-ND
R10, R15, R20, R25, R30, R35: RNCP0603FTD20K0; R_0603_1608Metric; Manufacturer Part Number RNCP0603FTD20K0; Digikey Part # RNCP0603FTD20K0CT-ND
U4, U5, U6, U7, U8, U9: IS31FL3733-QFLS4-TR; Manufacturer Part Number IS31FL3733-QFLS4-TR; Digikey Part # 706-1509-1-ND

Connections:
+3V3: C15.1, C22.1, C29.1, C36.1, C43.1, C50.1, R6.2, R7.2, R8.2, U4.39 (VIO), U5.39 (VIO), U6.39 (VIO), U7.39 (VIO), U8.39 (VIO), U9.39 (VIO); also elsewhere on the board
GND: C9.2, C10.2, C11.2, C12.2, C13.2, C14.2, C15.2, C16.2, C17.2, C18.2, C19.2, C20.2, C21.2, C22.2, C23.2, C24.2, C25.2, C26.2, C27.2, C28.2, C29.2, C30.2, C31.2, C32.2, C33.2, C34.2, C35.2, C36.2, C37.2, C38.2, C39.2, C40.2, C41.2, C42.2, C43.2, C44.2, C45.2, C46.2, C47.2, C48.2, C49.2, C50.2, R9.1, R10.1, R15.1, R20.1, R25.1, R30.1, R35.1, U4.5 (PGND), U4.12 (PGND), U4.34 (AGND), U4.43 (ADDR1), U4.44 (ADDR2), U4.48 (GND), U4.49 (HTAB), U5.5 (PGND), U5.12 (PGND), U5.34 (AGND), U5.44 (ADDR2), U5.48 (GND), U5.49 (HTAB), U6.5 (PGND), U6.12 (PGND), U6.34 (AGND), U6.44 (ADDR2), U6.48 (GND), U6.49 (HTAB), U7.5 (PGND), U7.12 (PGND), U7.34 (AGND), U7.44 (ADDR2), U7.48 (GND), U7.49 (HTAB), U8.5 (PGND), U8.12 (PGND), U8.34 (AGND), U8.43 (ADDR1), U8.48 (GND), U8.49 (HTAB), U9.5 (PGND), U9.12 (PGND), U9.34 (AGND), U9.48 (GND), U9.49 (HTAB); also elsewhere on the board
IICRST: R9.2, U4.47 (IICRST), U5.47 (IICRST), U6.47 (IICRST), U7.47 (IICRST), U8.47 (IICRST), U9.47 (IICRST)
unnamed: D10.1, D11.1, D12.1, D13.1, D14.1, U4.15 (SW12)
unnamed: D10.2, D11.2, D12.2, D13.2, D14.2, U4.14 (SW11)
unnamed: D10.3, D11.3, D12.3, D13.3, D14.3, U4.13 (SW10)
unnamed: D10.4, D26.4, D42.4, D58.4, U4.24 (CS8)
unnamed: D11.4, D27.4, D43.4, D59.4, U4.25 (CS9)
unnamed: D12.4, D28.4, D44.4, D60.4, U4.26 (CS10)
unnamed: D13.4, D29.4, D45.4, D61.4, U4.27 (CS11)
unnamed: D14.4, D30.4, D46.4, D62.4, U4.28 (CS12)
unnamed: D25.1, D26.1, D27.1, D28.1, D29.1, D30.1, D31.1, D32.1, U4.11 (SW9)
unnamed: D25.2, D26.2, D27.2, D28.2, D29.2, D30.2, D31.2, D32.2, U4.10 (SW8)
unnamed: D25.3, D26.3, D27.3, D28.3, D29.3, D30.3, D31.3, D32.3, U4.9 (SW7)
unnamed: D25.4, D41.4, D57.4, U4.23 (CS7)
unnamed: D31.4, D47.4, D63.4, U4.30 (CS13)
unnamed: D32.4, D48.4, D64.4, U4.31 (CS14)
unnamed: D40.1, D41.1, D42.1, D43.1, D44.1, D45.1, D46.1, D47.1, D48.1, D49.1, U4.8 (SW6)
unnamed: D40.2, D41.2, D42.2, D43.2, D44.2, D45.2, D46.2, D47.2, D48.2, D49.2, U4.7 (SW5)
unnamed: D40.3, D41.3, D42.3, D43.3, D44.3, D45.3, D46.3, D47.3, D48.3, D49.3, U4.6 (SW4)
unnamed: D40.4, D56.4, U4.22 (CS6)
unnamed: D49.4, D65.4, U4.32 (CS15)
unnamed: D55.1, D56.1, D57.1, D58.1, D59.1, D60.1, D61.1, D62.1, D63.1, D64.1, D65.1, D66.1, U4.4 (SW3)
unnamed: D55.2, D56.2, D57.2, D58.2, D59.2, D60.2, D61.2, D62.2, D63.2, D64.2, D65.2, D66.2, U4.3 (SW2)
unnamed: D55.3, D56.3, D57.3, D58.3, D59.3, D60.3, D61.3, D62.3, D63.3, D64.3, D65.3, D66.3, U4.2 (SW1)
unnamed: D55.4, U4.21 (CS5)
unnamed: D66.4, U4.33 (CS16)
unnamed: D71.1, D72.1, D73.1, D74.1, D75.1, D76.1, D77.1, D78.1, D79.1, D80.1, D81.1, D82.1, U5.15 (SW12)
unnamed: D71.2, D72.2, D73.2, D74.2, D75.2, D76.2, D77.2, D78.2, D79.2, D80.2, D81.2, D82.2, U5.14 (SW11)
unnamed: D71.3, D72.3, D73.3, D74.3, D75.3, D76.3, D77.3, D78.3, D79.3, D80.3, D81.3, D82.3, U5.13 (SW10)
unnamed: D87.1, D88.1, D89.1, D90.1, D91.1, D92.1, D93.1, D94.1, D95.1, D96.1, D97.1, D98.1, U5.11 (SW9)
unnamed: D87.2, D88.2, D89.2, D90.2, D91.2, D92.2, D93.2, D94.2, D95.2, D96.2, D97.2, D98.2, U5.10 (SW8)
unnamed: D87.3, D88.3, D89.3, D90.3, D91.3, D92.3, D93.3, D94.3, D95.3, D96.3, D97.3, D98.3, U5.9 (SW7)
unnamed: D103.1, D104.1, D105.1, D106.1, D107.1, D108.1, D109.1, D110.1, D111.1, D112.1, D113.1, D114.1, U5.8 (SW6)
unnamed: D103.2, D104.2, D105.2, D106.2, D107.2, D108.2, D109.2, D110.2, D111.2, D112.2, D113.2, D114.2, U5.7 (SW5)
unnamed: D103.3, D104.3, D105.3, D106.3, D107.3, D108.3, D109.3, D110.3, D111.3, D112.3, D113.3, D114.3, U5.6 (SW4)
unnamed: D71.4, D87.4, D103.4, D119.4, U5.21 (CS5)
unnamed: D72.4, D88.4, D104.4, D120.4, U5.22 (CS6)
unnamed: D73.4, D89.4, D105.4, D121.4, U5.23 (CS7)
unnamed: D74.4, D90.4, D106.4, D122.4, U5.24 (CS8)
unnamed: D75.4, D91.4, D107.4, D123.4, U5.25 (CS9)
unnamed: D76.4, D92.4, D108.4, D124.4, U5.26 (CS10)
unnamed: D77.4, D93.4, D109.4, D125.4, U5.27 (CS11)
unnamed: D78.4, D94.4, D110.4, D126.4, U5.28 (CS12)
unnamed: D79.4, D95.4, D111.4, D127.4, U5.30 (CS13)
unnamed: D80.4, D96.4, D112.4, D128.4, U5.31 (CS14)
unnamed: D81.4, D97.4, D113.4, D129.4, U5.32 (CS15)
unnamed: D82.4, D98.4, D114.4, D130.4, U5.33 (CS16)
unnamed: D118.1, D119.1, D120.1, D121.1, D122.1, D123.1, D124.1, D125.1, D126.1, D127.1, D128.1, D129.1, D130.1, U5.4 (SW3)
unnamed: D118.2, D119.2, D120.2, D121.2, D122.2, D123.2, D124.2, D125.2, D126.2, D127.2, D128.2, D129.2, D130.2, U5.3 (SW2)
unnamed: D118.3, D119.3, D120.3, D121.3, D122.3, D123.3, D124.3, D125.3, D126.3, D127.3, D128.3, D129.3, D130.3, U5.2 (SW1)
unnamed: D118.4, U5.19 (CS4)
unnamed: D133.1, D134.1, D135.1, D136.1, D137.1, D138.1, D139.1, D140.1, D141.1, D142.1, D143.1, D144.1, D145.1, D146.1, U6.15 (SW12)
unnamed: D133.2, D134.2, D135.2, D136.2, D137.2, D138.2, D139.2, D140.2, D141.2, D142.2, D143.2, D144.2, D145.2, D146.2, U6.14 (SW11)
unnamed: D133.3, D134.3, D135.3, D136.3, D137.3, D138.3, D139.3, D140.3, D141.3, D142.3, D143.3, D144.3, D145.3, D146.3, U6.13 (SW10)
unnamed: D133.4, D149.4, D165.4, D181.4, U6.18 (CS3)
unnamed: D134.4, D150.4, D166.4, D182.4, U6.19 (CS4)
unnamed: D135.4, D151.4, D167.4, D183.4, U6.21 (CS5)
unnamed: D136.4, D152.4, D168.4, D184.4, U6.22 (CS6)
unnamed: D137.4, D153.4, D169.4, D185.4, U6.23 (CS7)
unnamed: D138.4, D154.4, D170.4, D186.4, U6.24 (CS8)
unnamed: D139.4, D155.4, D171.4, D187.4, U6.25 (CS9)
unnamed: D140.4, D156.4, D172.4, D188.4, U6.26 (CS10)
unnamed: D141.4, D157.4, D173.4, D189.4, U6.27 (CS11)
unnamed: D142.4, D158.4, D174.4, D190.4, U6.28 (CS12)
unnamed: D143.4, D159.4, D175.4, D191.4, U6.30 (CS13)
unnamed: D144.4, D160.4, D176.4, D192.4, U6.31 (CS14)
unnamed: D145.4, D161.4, D177.4, D193.4, U6.32 (CS15)
unnamed: D146.4, D162.4, D178.4, D194.4, U6.33 (CS16)
unnamed: D148.1, D149.1, D150.1, D151.1, D152.1, D153.1, D154.1, D155.1, D156.1, D157.1, D158.1, D159.1, D160.1, D161.1, D162.1, U6.11 (SW9)
unnamed: D148.2, D149.2, D150.2, D151.2, D152.2, D153.2, D154.2, D155.2, D156.2, D157.2, D158.2, D159.2, D160.2, D161.2, D162.2, U6.10 (SW8)
unnamed: D148.3, D149.3, D150.3, D151.3, D152.3, D153.3, D154.3, D155.3, D156.3, D157.3, D158.3, D159.3, D160.3, D161.3, D162.3, U6.9 (SW7)
unnamed: D148.4, D164.4, D180.4, U6.17 (CS2)
unnamed: D163.1, D164.1, D165.1, D166.1, D167.1, D168.1, D169.1, D170.1, D171.1, D172.1, D173.1, D174.1, D175.1, D176.1, D177.1, D178.1, U6.8 (SW6)
unnamed: D163.2, D164.2, D165.2, D166.2, D167.2, D168.2, D169.2, D170.2, D171.2, D172.2, D173.2, D174.2, D175.2, D176.2, D177.2, D178.2, U6.7 (SW5)
unnamed: D163.3, D164.3, D165.3, D166.3, D167.3, D168.3, D169.3, D170.3, D171.3, D172.3, D173.3, D174.3, D175.3, D176.3, D177.3, D178.3, U6.6 (SW4)
unnamed: D163.4, D179.4, U6.16 (CS1)
unnamed: D179.1, D180.1, D181.1, D182.1, D183.1, D184.1, D185.1, D186.1, D187.1, D188.1, D189.1, D190.1, D191.1, D192.1, D193.1, D194.1, U6.4 (SW3)
unnamed: D179.2, D180.2, D181.2, D182.2, D183.2, D184.2, D185.2, D186.2, D187.2, D188.2, D189.2, D190.2, D191.2, D192.2, D193.2, D194.2, U6.3 (SW2)
unnamed: D179.3, D180.3, D181.3, D182.3, D183.3, D184.3, D185.3, D186.3, D187.3, D188.3, D189.3, D190.3, D191.3, D192.3, D193.3, D194.3, U6.2 (SW1)
unnamed: D195.1, D196.1, D197.1, D198.1, D199.1, D200.1, D201.1, D202.1, D203.1, D204.1, D205.1, D206.1, D207.1, D208.1, D209.1, D210.1, U7.15 (SW12)
unnamed: D195.2, D196.2, D197.2, D198.2, D199.2, D200.2, D201.2, D202.2, D203.2, D204.2, D205.2, D206.2, D207.2, D208.2, D209.2, D210.2, U7.14 (SW11)
unnamed: D195.3, D196.3, D197.3, D198.3, D199.3, D200.3, D201.3, D202.3, D203.3, D204.3, D205.3, D206.3, D207.3, D208.3, D209.3, D210.3, U7.13 (SW10)
unnamed: D195.4, D211.4, U7.16 (CS1)
unnamed: D196.4, D212.4, D228.4, U7.17 (CS2)
unnamed: D197.4, D213.4, D229.4, D245.4, U7.18 (CS3)
unnamed: D198.4, D214.4, D230.4, D246.4, U7.19 (CS4)
unnamed: D199.4, D215.4, D231.4, D247.4, U7.21 (CS5)
unnamed: D200.4, D216.4, D232.4, D248.4, U7.22 (CS6)
unnamed: D201.4, D217.4, D233.4, D249.4, U7.23 (CS7)
unnamed: D202.4, D218.4, D234.4, D250.4, U7.24 (CS8)
unnamed: D203.4, D219.4, D235.4, D251.4, U7.25 (CS9)
unnamed: D204.4, D220.4, D236.4, D252.4, U7.26 (CS10)
unnamed: D205.4, D221.4, D237.4, D253.4, U7.27 (CS11)
unnamed: D206.4, D222.4, D238.4, D254.4, U7.28 (CS12)
unnamed: D207.4, D223.4, D239.4, D255.4, U7.30 (CS13)
unnamed: D208.4, D224.4, D240.4, D256.4, U7.31 (CS14)
unnamed: D209.4, D225.4, D241.4, D257.4, U7.32 (CS15)
unnamed: D210.4, D226.4, D242.4, D258.4, U7.33 (CS16)
unnamed: D211.1, D212.1, D213.1, D214.1, D215.1, D216.1, D217.1, D218.1, D219.1, D220.1, D221.1, D222.1, D223.1, D224.1, D225.1, D226.1, U7.11 (SW9)
unnamed: D211.2, D212.2, D213.2, D214.2, D215.2, D216.2, D217.2, D218.2, D219.2, D220.2, D221.2, D222.2, D223.2, D224.2, D225.2, D226.2, U7.10 (SW8)
unnamed: D211.3, D212.3, D213.3, D214.3, D215.3, D216.3, D217.3, D218.3, D219.3, D220.3, D221.3, D222.3, D223.3, D224.3, D225.3, D226.3, U7.9 (SW7)
unnamed: D228.1, D229.1, D230.1, D231.1, D232.1, D233.1, D234.1, D235.1, D236.1, D237.1, D238.1, D239.1, D240.1, D241.1, D242.1, U7.8 (SW6)
unnamed: D228.2, D229.2, D230.2, D231.2, D232.2, D233.2, D234.2, D235.2, D236.2, D237.2, D238.2, D239.2, D240.2, D241.2, D242.2, U7.7 (SW5)
unnamed: D228.3, D229.3, D230.3, D231.3, D232.3, D233.3, D234.3, D235.3, D236.3, D237.3, D238.3, D239.3, D240.3, D241.3, D242.3, U7.6 (SW4)
unnamed: D245.1, D246.1, D247.1, D248.1, D249.1, D250.1, D251.1, D252.1, D253.1, D254.1, D255.1, D256.1, D257.1, D258.1, U7.4 (SW3)
unnamed: D245.2, D246.2, D247.2, D248.2, D249.2, D250.2, D251.2, D252.2, D253.2, D254.2, D255.2, D256.2, D257.2, D258.2, U7.3 (SW2)
unnamed: D245.3, D246.3, D247.3, D248.3, D249.3, D250.3, D251.3, D252.3, D253.3, D254.3, D255.3, D256.3, D257.3, D258.3, U7.2 (SW1)
unnamed: D262.1, D263.1, D264.1, D265.1, D266.1, D267.1, D268.1, D269.1, D270.1, D271.1, D272.1, D273.1, D274.1, U8.15 (SW12)
unnamed: D262.2, D263.2, D264.2, D265.2, D266.2, D267.2, D268.2, D269.2, D270.2, D271.2, D272.2, D273.2, D274.2, U8.14 (SW11)
unnamed: D262.3, D263.3, D264.3, D265.3, D266.3, D267.3, D268.3, D269.3, D270.3, D271.3, D272.3, D273.3, D274.3, U8.13 (SW10)
unnamed: D262.4, U8.19 (CS4)
unnamed: D263.4, D279.4, U8.21 (CS5)
unnamed: D264.4, D280.4, D296.4, D312.4, U8.22 (CS6)
unnamed: D265.4, D281.4, D297.4, D313.4, U8.23 (CS7)
unnamed: D266.4, D282.4, D298.4, D314.4, U8.24 (CS8)
unnamed: D267.4, D283.4, D299.4, D315.4, U8.25 (CS9)
unnamed: D268.4, D284.4, D300.4, D316.4, U8.26 (CS10)
unnamed: D269.4, D285.4, D301.4, D317.4, U8.27 (CS11)
unnamed: D270.4, D286.4, D302.4, D318.4, U8.28 (CS12)
unnamed: D271.4, D287.4, D303.4, D319.4, U8.30 (CS13)
unnamed: D272.4, D288.4, D304.4, D320.4, U8.31 (CS14)
unnamed: D273.4, D289.4, D305.4, D321.4, U8.32 (CS15)
unnamed: D274.4, D290.4, D306.4, D322.4, U8.33 (CS16)
unnamed: D279.1, D280.1, D281.1, D282.1, D283.1, D284.1, D285.1, D286.1, D287.1, D288.1, D289.1, D290.1, U8.11 (SW9)
unnamed: D279.2, D280.2, D281.2, D282.2, D283.2, D284.2, D285.2, D286.2, D287.2, D288.2, D289.2, D290.2, U8.10 (SW8)
unnamed: D279.3, D280.3, D281.3, D282.3, D283.3, D284.3, D285.3, D286.3, D287.3, D288.3, D289.3, D290.3, U8.9 (SW7)
unnamed: D296.1, D297.1, D298.1, D299.1, D300.1, D301.1, D302.1, D303.1, D304.1, D305.1, D306.1, U8.8 (SW6)
unnamed: D296.2, D297.2, D298.2, D299.2, D300.2, D301.2, D302.2, D303.2, D304.2, D305.2, D306.2, U8.7 (SW5)
unnamed: D296.3, D297.3, D298.3, D299.3, D300.3, D301.3, D302.3, D303.3, D304.3, D305.3, D306.3, U8.6 (SW4)
unnamed: D312.1, D313.1, D314.1, D315.1, D316.1, D317.1, D318.1, D319.1, D320.1, D321.1, D322.1, U8.4 (SW3)
unnamed: D312.2, D313.2, D314.2, D315.2, D316.2, D317.2, D318.2, D319.2, D320.2, D321.2, D322.2, U8.3 (SW2)
unnamed: D312.3, D313.3, D314.3, D315.3, D316.3, D317.3, D318.3, D319.3, D320.3, D321.3, D322.3, U8.2 (SW1)
unnamed: D329.1, D330.1, D331.1, D332.1, D333.1, D334.1, D335.1, D336.1, D337.1, D338.1, U9.15 (SW12)
unnamed: D329.2, D330.2, D331.2, D332.2, D333.2, D334.2, D335.2, D336.2, D337.2, D338.2, U9.14 (SW11)
unnamed: D329.3, D330.3, D331.3, D332.3, D333.3, D334.3, D335.3, D336.3, D337.3, D338.3, U9.13 (SW10)
unnamed: D329.4, D345.4, D361.4, U9.23 (CS7)
unnamed: D330.4, D346.4, D362.4, D378.4, U9.24 (CS8)
unnamed: D331.4, D347.4, D363.4, D379.4, U9.25 (CS9)
unnamed: D332.4, D348.4, D364.4, D380.4, U9.26 (CS10)
unnamed: D333.4, D349.4, D365.4, D381.4, U9.27 (CS11)
unnamed: D334.4, D350.4, D366.4, D382.4, U9.28 (CS12)
unnamed: D335.4, D351.4, D367.4, U9.30 (CS13)
unnamed: D336.4, D352.4, D368.4, U9.31 (CS14)
unnamed: D337.4, D353.4, U9.32 (CS15)
unnamed: D338.4, U9.33 (CS16)
unnamed: D345.1, D346.1, D347.1, D348.1, D349.1, D350.1, D351.1, D352.1, D353.1, U9.11 (SW9)
unnamed: D345.2, D346.2, D347.2, D348.2, D349.2, D350.2, D351.2, D352.2, D353.2, U9.10 (SW8)
unnamed: D345.3, D346.3, D347.3, D348.3, D349.3, D350.3, D351.3, D352.3, D353.3, U9.9 (SW7)
unnamed: D361.1, D362.1, D363.1, D364.1, D365.1, D366.1, D367.1, D368.1, U9.8 (SW6)
unnamed: D361.2, D362.2, D363.2, D364.2, D365.2, D366.2, D367.2, D368.2, U9.7 (SW5)
unnamed: D361.3, D362.3, D363.3, D364.3, D365.3, D366.3, D367.3, D368.3, U9.6 (SW4)
unnamed: D378.1, D379.1, D380.1, D381.1, D382.1, U9.4 (SW3)
unnamed: D378.2, D379.2, D380.2, D381.2, D382.2, U9.3 (SW2)
unnamed: D378.3, D379.3, D380.3, D381.3, D382.3, U9.2 (SW1)
unnamed: R10.2, U4.35 (RSET)
unnamed: R15.2, U5.35 (RSET)
unnamed: R20.2, U6.35 (RSET)
unnamed: R25.2, U7.35 (RSET)
unnamed: R30.2, U8.35 (RSET)
unnamed: R35.2, U9.35 (RSET)
SCL: R7.1, U4.42 (SCL), U5.42 (SCL), U6.42 (SCL), U7.42 (SCL), U7.43 (ADDR1), U8.42 (SCL), U9.42 (SCL); also elsewhere on the board
SDA: R8.1, U4.41 (SDA), U5.41 (SDA), U6.41 (SDA), U6.43 (ADDR1), U7.41 (SDA), U8.41 (SDA), U9.41 (SDA); also elsewhere on the board
SDB: R6.1, U4.46 (SDB), U5.46 (SDB), U6.46 (SDB), U7.46 (SDB), U8.46 (SDB), U9.46 (SDB)
SYNC: U4.40 (SYNC), U5.40 (SYNC), U6.40 (SYNC), U7.40 (SYNC), U8.40 (SYNC), U9.40 (SYNC)
VBUS: C9.1, C10.1, C11.1, C12.1, C13.1, C14.1, C16.1, C17.1, C18.1, C19.1, C20.1, C21.1, C23.1, C24.1, C25.1, C26.1, C27.1, C28.1, C30.1, C31.1, C32.1, C33.1, C34.1, C35.1, C37.1, C38.1, C39.1, C40.1, C41.1, C42.1, C44.1, C45.1, C46.1, C47.1, C48.1, C49.1, U4.20 (PVCC), U4.29 (PVCC), U4.37 (AVCC), U4.38 (DVCC), U5.20 (PVCC), U5.29 (PVCC), U5.37 (AVCC), U5.38 (DVCC), U5.43 (ADDR1), U6.20 (PVCC), U6.29 (PVCC), U6.37 (AVCC), U6.38 (DVCC), U7.20 (PVCC), U7.29 (PVCC), U7.37 (AVCC), U7.38 (DVCC), U8.20 (PVCC), U8.29 (PVCC), U8.37 (AVCC), U8.38 (DVCC), U8.44 (ADDR2), U9.20 (PVCC), U9.29 (PVCC), U9.37 (AVCC), U9.38 (DVCC), U9.43 (ADDR1), U9.44 (ADDR2); also elsewhere on the board

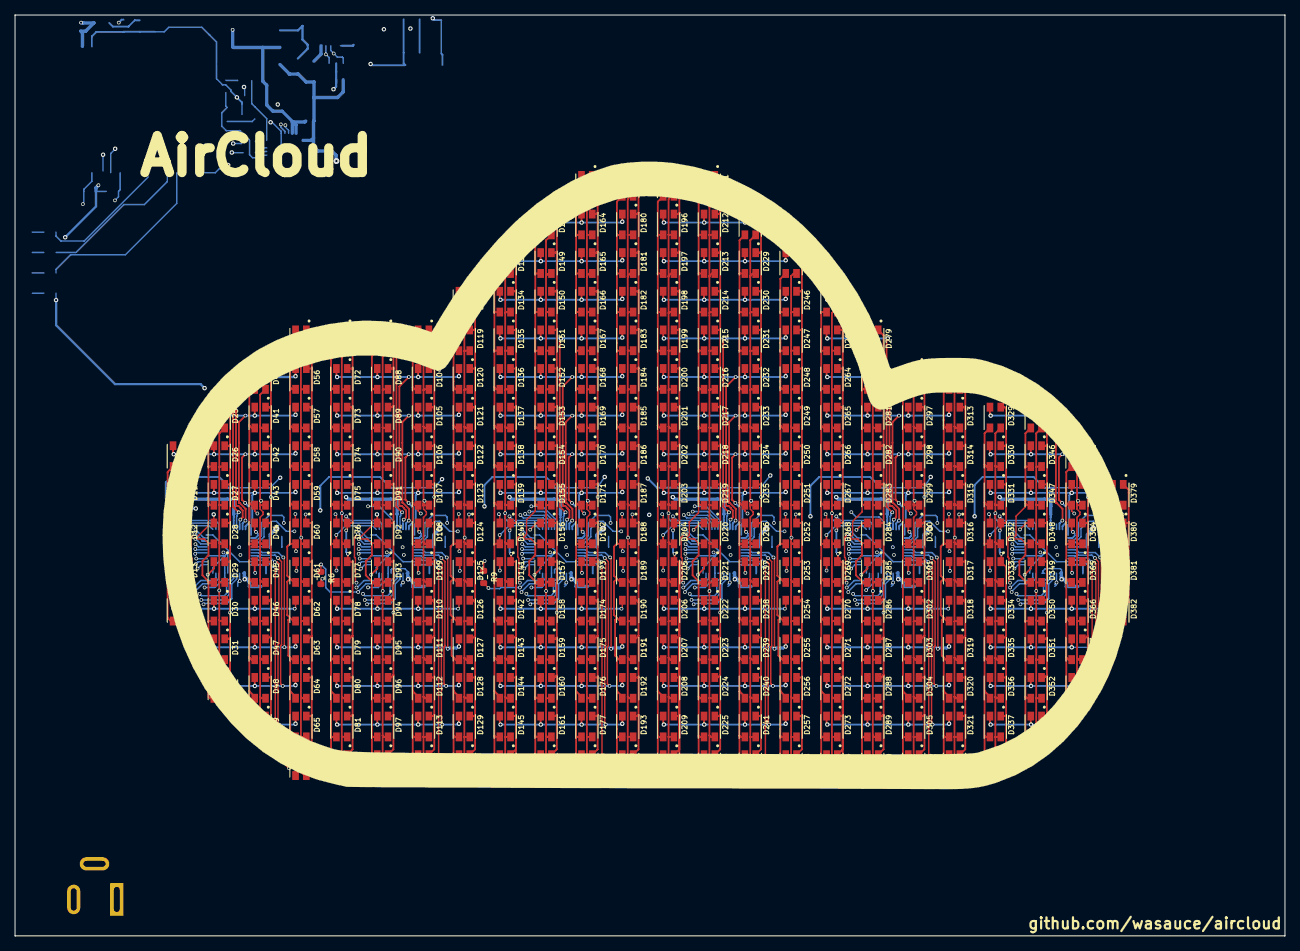
[picture p46: board LED_Cloud.kicad_pcb from above]

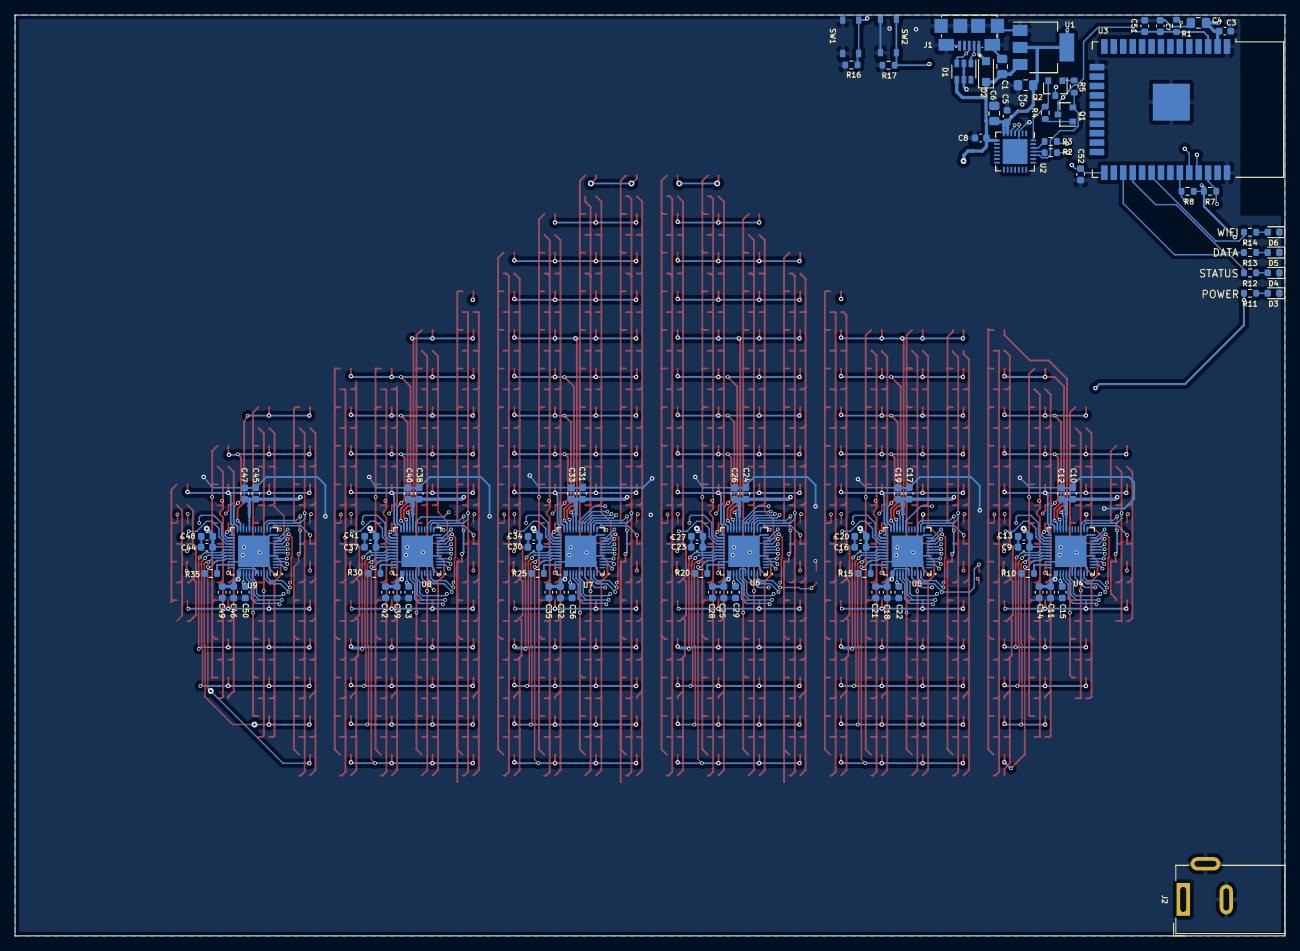
[picture p47: board LED_Cloud.kicad_pcb from below]

Board: 4 copper layers, 171.0 x 124.0 mm, 377 parts (92 on the bottom side), 186 nets.
