wasauce/AirCloudPCBs/(commit log)

2021-05-02 aircloud v1 and v2
    [10118192-0001LF--3DModel-STEP-56544.STEP, 10118192-002lfc.stp, 694108301002 (rev1).stp, AirCloud-BOM.xlsx, BOM.xlsx, LED_Cloud - Copy.kicad_pcb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]
2021-08-23 AirCloud v3 design
    [AirCloud-B_Cu.gbl, AirCloud-B_Mask.gbs, AirCloud-B_Paste.gbp, AirCloud-B_SilkS.gbo, AirCloud-Edge_Cuts.gm1, AirCloud-F_Cu.gtl, AirCloud-F_Mask.gts, AirCloud-F_Paste.gtp]
