wasauce/AirCloudPCBs/(notices)

Notices in the files:
AirCloudv2/3D/TSM-103-01-T-SH.stp:
FILE_NAME( 'p:/temp/worker_10/temp/exporttempdir_4776_179_AauYU/format_0/TSM-103-01-T-SH.stp', '2020-11-01T00:51:39', ( 'License CC BY-ND 4.0' ), ( 'CADENAS' ), ' ', 'PARTsolutions', ' ' );
AirCloudv2/3D/PTS815SJM250SMTRLFS.stp:
FILE_NAME( 'p:/temp/worker_3/temp/exporttempdir_6068_536_1QaUT/format_0/PTS815SJM250SMTRLFS.stp', '2020-11-01T00:31:27', ( 'License CC BY-ND 4.0' ), ( 'CADENAS' ), ' ', 'PARTsolutions', ' ' );
parts and their libraries:
Copyright 2016 Accelerated Designs. All rights reserved.
